brucejcooper/switch_gateway_firmware/src/lights.png

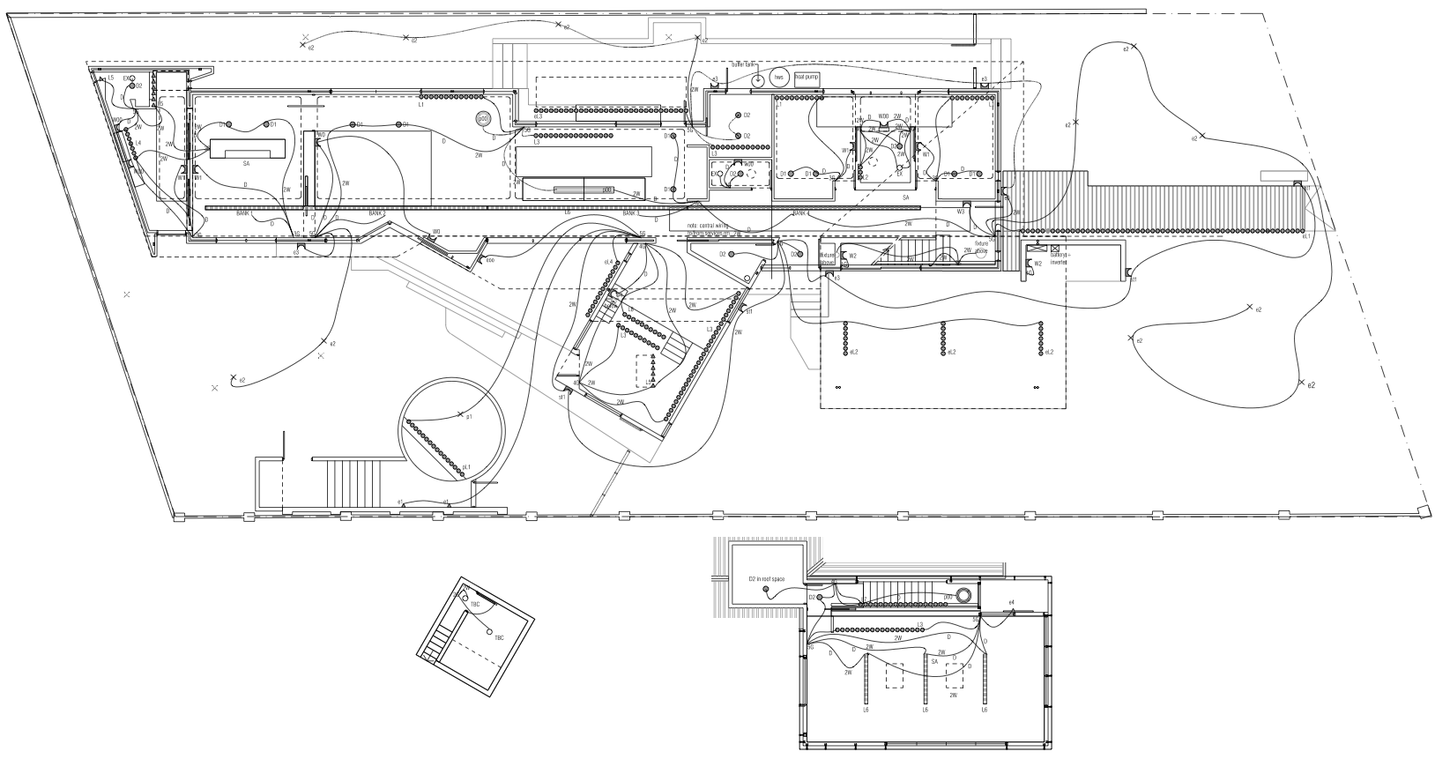
src/lights.png
