brucejcooper/switch_gateway_firmware/hardware/all_in_one_hub/production/all_in_one_hub_2024-05-29_09-31-53/bom.csv

Designator | Footprint | Quantity | Value | LCSC Part #
C1, C2, C3 | 0805 | 3 | 0.1u
CON1, CON2 | MIKROBUS_HOST_CONN | 2 | MIKROBUS_HOST_CONN
D1, D10, D100, D101, D102, D103, D104, D105, D106, D107, D108, D109, D11, D110, D111, D112, D113, D114, D115, D116, D117, D118, D119, D12, D120, D121, D122, D123, D124, D125, D126, D127, D128, D129, D13, D130, D131, D132, D133, D134, D135, D136, D137, D138, D139, D14, D140, D141, D142, D143, D144, D145, D146, D147, D148, D149, D15, D150, D151, D152, D153, D154, D155, D156, D157, D158, D159, D16, D160, D161, D162, D163, D164, D165, D166, D167, D168, D17, D18, D19, D2, D20, D21, D22, D23, D24, D25, D26, D27, D28, D29, D3, D30, D31, D32, D33, D34, D35, D36, D37, D38, D39, D4, D40, D41, D42, D43, D44, D45, D46, D47, D48, D49, D5, D50, D51, D52, D53, D54, D55, D56, D57, D58, D59, D6, D60, D61, D62, D63, D64, D65, D66, D67, D68, D69, D7, D70, D71, D72, D73, D74, D75, D76, D77, D78, D79, D8, D80, D81, D82, D83, D84, D85, D86, D87, D88, D89, D9, D90, D91, D92, D93, D94, D95, D96, D97, D98, D99 | D_SOD-123F | 168 | D
J1 | TerminalBlock_Phoenix_MKDS-1,5-6-5.08_1x06_P5.08mm_Horizontal | 1 | Screw_Terminal_01x06
J3, J4 | PinHeader_1x03_P2.54mm_Vertical | 2 | Conn_01x03
J5 | BarrelJack_Horizontal | 1 | Barrel_Jack_Switch
J6 | TerminalBlock_Phoenix_MKDS-1,5-2-5.08_1x02_P5.08mm_Horizontal | 1 | Screw_Terminal_01x02
R1, R2, R3, R4, R5, R6, R7 | 0603 | 7 | 4.7k
SW1 | SW_Tactile_SKHH_Angled | 1 | SW_Push
U1, U5, U6 | SOIC-16_3.9x9.9mm_P1.27mm | 3 | 74HC595
U2, U3, U7 | Molex 8pc*8pole RJ45 | 3 | ~
U4 | RaspberryPi_Pico_Common | 1 | RaspberryPi_Pico
