brucejcooper/switch_gateway_firmware/hardware/all_in_one_hub/Main Case.stl

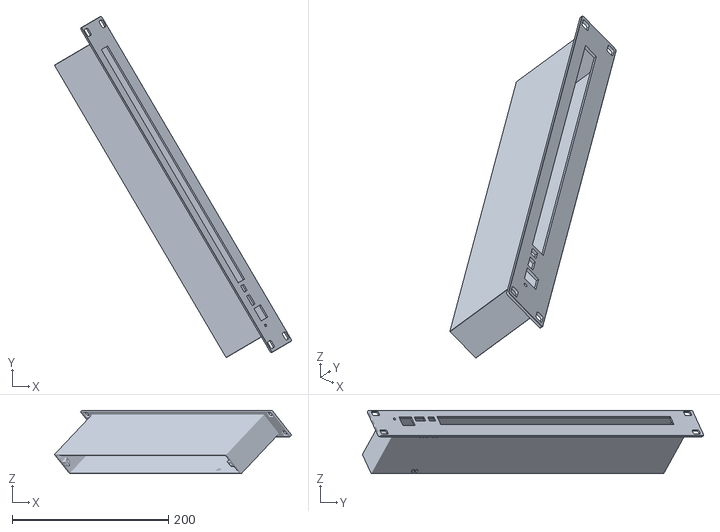
[picture p2: CAD file, 2026-10-23]
hardware/all_in_one_hub/Main Case.stl
303.6 x 437.1 x 81.3
