brucejcooper/switch_gateway_firmware/hardware/all_in_one_hub/All in One Hub v1 case.step

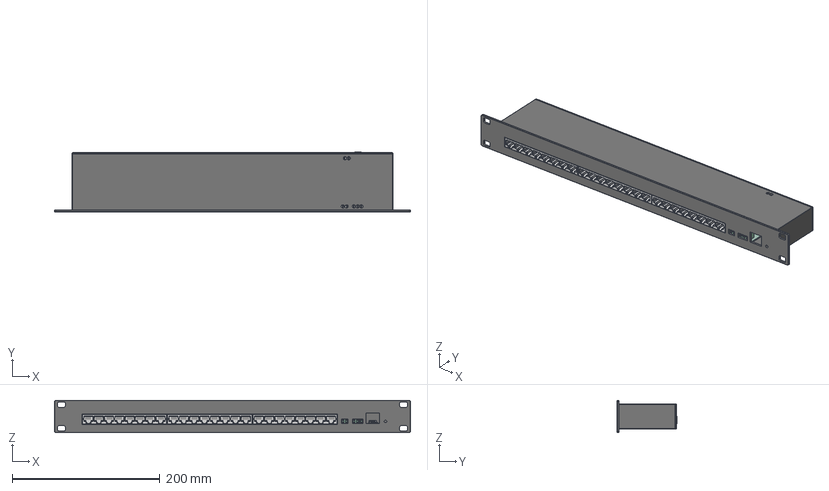
[picture p3: CAD file, 2026-10-23]
hardware/all_in_one_hub/All in One Hub v1 case.step
482.5 x 81.6 x 44.0 mm
D_SOD_123F x 168
R_0603_1608Metric x 7
TerminalBlock_Phoenix_MKDS_15_2_508_1x02_P508mm_Horizontal x 2
C_0805_2012Metric x 3
SSOP_16_53x62mm_P065mm x 3
BarrelJack_Horizontal
PinHeader_1x02_P254mm_Vertical
PinHeader_1x03_P254mm_Vertical
RaspberryPi_Pico_STEP
TerminalBlock_Phoenix_MKDS_15_3_508_1x03_P508mm_Horizontal
all_in_one_hub PCB
