brucejcooper/switch_gateway_firmware/hardware/all_in_one_hub/Mounting.FCStd

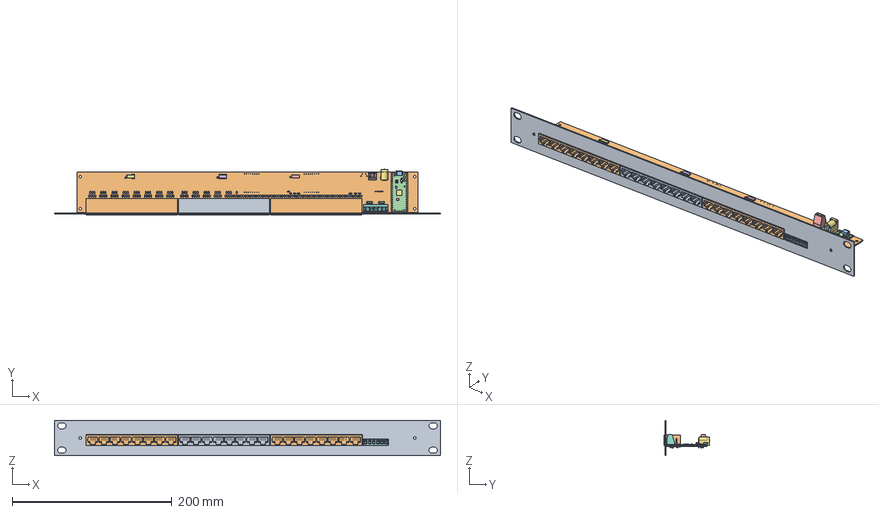
[picture p4: CAD file, 2026-10-23]
hardware/all_in_one_hub/Mounting.FCStd
483.5 x 57.1 x 44.0 mm
Face Plate
D_SOD-123F
D_SOD-123F001
D_SOD-123F002
D_SOD-123F003
D_SOD-123F004
D_SOD-123F005
D_SOD-123F006
D_SOD-123F007
D_SOD-123F008
D_SOD-123F009
D_SOD-123F010
D_SOD-123F011
D_SOD-123F012
D_SOD-123F013
TerminalBlock_Phoenix_MKDS-1,5-6-5.08_1x06_P5.08mm_Horizontal
R_0603_1608Metric
D_SOD-123F014
D_SOD-123F015
Pico_Board
C1_47u
C2_47u
D1_MBR120VLSFT1G
D2_QSME-C194_Base
D2_QSME-C194_Phosphor
D2_QSME-C194_Lens
J1_690T505-x62-01x
L1_2u2
Q1_DMG1012T
SW1_TP-1221U-K9K5325
U1_RP2040
U2_RT6150B-33GQW
U3_W25Q16JVUXIQ
X1_X12M000000S096
D_SOD-123F016
D_SOD-123F017
TerminalBlock_Phoenix_MKDS-1,5-2-5.08_1x02_P5.08mm_Horizontal
D_SOD-123F018
C_0805_2012Metric
D_SOD-123F019
D_SOD-123F020
D_SOD-123F021
D_SOD-123F022
D_SOD-123F023
SOIC-16_3.9x9.9mm_P1.27mm
D_SOD-123F024
C_0805_2012Metric001
D_SOD-123F025
D_SOD-123F026
D_SOD-123F027
D_SOD-123F028
D_SOD-123F029
D_SOD-123F030
D_SOD-123F031
D_SOD-123F032
D_SOD-123F033
D_SOD-123F034
D_SOD-123F035
D_SOD-123F036
D_SOD-123F037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
