brucejcooper/switch_gateway_firmware/hardware/all_in_one_hub/Rear Cover.stl

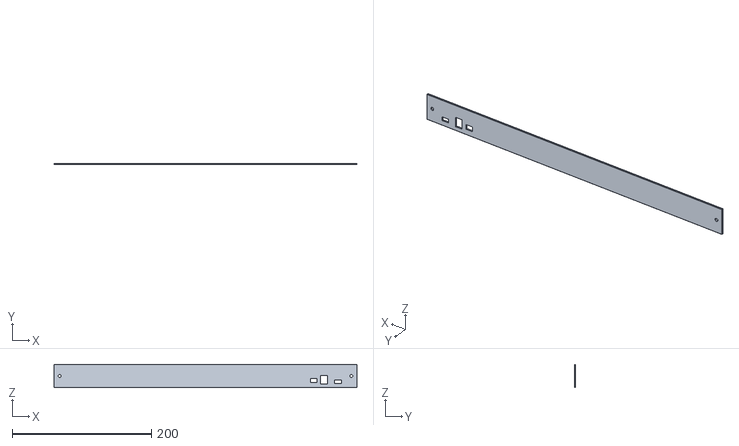
[picture p5: CAD file, 2026-10-23]
hardware/all_in_one_hub/Rear Cover.stl
434.6 x 2.00 x 33.6
