brucejcooper/switch_gateway_firmware/hardware/all_in_one_hub/all_in_one_hub.step

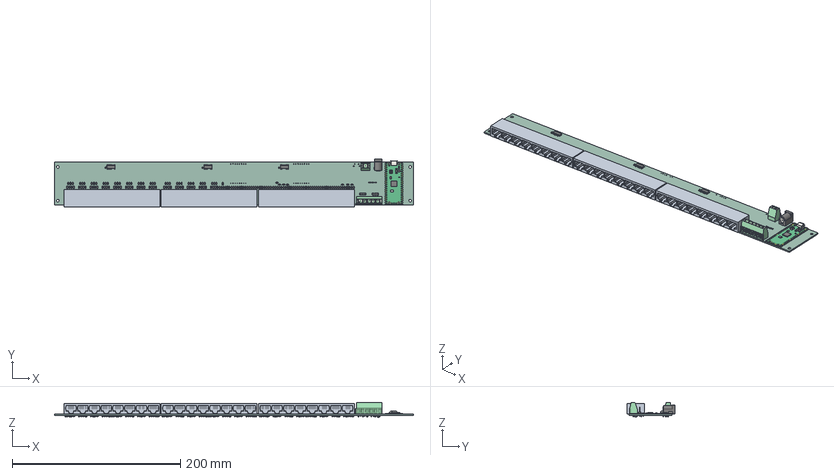
[picture p6: CAD file, 2026-10-23]
hardware/all_in_one_hub/all_in_one_hub.step
427.0 x 57.1 x 17.7 mm
D_SOD-123F x 168
TerminalBlock_Phoenix_MKDS-1,5-6-5.08_1x06_P5.08mm_Horizontal
R_0603_1608Metric x 7
Pico_Board
C1_47u
C2_47u
D1_MBR120VLSFT1G
D2_QSME-C194_Base
D2_QSME-C194_Phosphor
D2_QSME-C194_Lens
J1_690T505-x62-01x
L1_2u2
Q1_DMG1012T
SW1_TP-1221U-K9K5325
U1_RP2040
U2_RT6150B-33GQW
U3_W25Q16JVUXIQ
X1_X12M000000S096
TerminalBlock_Phoenix_MKDS-1,5-2-5.08_1x02_P5.08mm_Horizontal
C_0805_2012Metric x 3
SOIC-16_3.9x9.9mm_P1.27mm x 3
BarrelJack_Horizontal
PinHeader_1x03_P2.54mm_Vertical x 2
all_in_one_hub_PCB
