brucejcooper/switch_gateway_firmware/Switch wiring.xlsx

Sheet: Switch Positions
Light Fitting | Patch Panel Location | Button order |  |  |  |  | Map X | Map Y
Master Bath | 0 | 2 | 5 | 4 | 3 | 1 | 0.03923 | 0.13854
Master Bed near Bath | 1 | 2 | 5 | 4 |  |  | 0.09052 | 0.32571
Lounge near Master Bed | 2 | 2 | 5 | 3 | 4 | 0 | 0.17899 | 0.33459
Master Bed Near sliding Door | 17 | 0 | 1 | 2 | 3 | 4 | 0.16176 | 0.33464
Bed3 | 3 | 5 | 1 | 3 |  |  | 0.65847 | 0.24379
Kitchen bench | 4 | 0 | 1 | 2 | 5 | 4 | 0.33977 | 0.1688
Near Screen Door | 5 | 0 | 3 | 4 | 5 | 2 | 0.43088 | 0.33471
B office | 6 | 4 | 3 | 5 | 1 |  | 0.43491 | 0.34479
Hall near Kitchen | 7 | 2 | 5 | 4 | 3 |  | 0.47566 | 0.27911
Laundry/Kitchen | 8 | 1 | 5 | 4 | 3 |  | 0.46926 | 0.16669
Laundry near external door | 9 | 3 | 1 | 5 |  |  | 0.51399 | 0.25863
Powder | 10 | 5 | 3 | 1 |  |  | 0.51914 | 0.11531
Server Room | 11 | 3 | 1 | 5 | 4 | 2 | 0.5375 | 0.34013
Bed2 | 12 | 3 | 1 | 5 |  |  | 0.58 | 0.25028
Bath2 near Bed2 | 13 | 1 | 3 | 5 | 0 |  | 0.59988 | 0.16759
Bath2 near Bed3 | 14 | 0 | 5 | 3 | 1 |  | 0.63961 | 0.16901
Front Door | 15 | 2 | 5 | 1 | 3 | 4 | 0.70528 | 0.3319
Cellar | 16 | 1 | 3 |  |  |  | 0.55538 | 0.64826
Air Compressor Nook | 17 | 5 |  |  |  |  | 0.58709 | 0.37886
Steel Wall at bottom of stairs | 18 | 4 | 3 | 2 | 1 |  | 0.67684 | 0.37674
Top of stairs | 19 | 4 | 5 | 3 | 1 |  | 0.70459 | 0.69291
solar nook | 20 | 6 |  |  |  |  | 0.73011 | 0.39116
Brewery | 20 | 0 | 1 | 2 | 3 |  | 0.38265 | 0.55698
M studio near balcony | 21 | 1 | 0 | 3 | 4 | 5 | 0.80769 | 0.7589
M studio near door | 22 | 0 | 1 | 2 | 3 | 4 | 0.68279 | 0.78771
Master Bed near Pivot | 23 | 0 | 1 | 2 |  |  | 0.17046 | 0.18894

Sheet: Ethernet patches
Position | Switch Position | Thing | Wiring Fault
1 | 2 | main tv
2 | 5 | Bed2 left (printer)
3 | 17 | Bed 2 ap
4 |  | ???
5 | 20 | Mel studio ap
6 |  | ???
7 |  | Melissa bed side table
8 | 10 | Mel studio
9
10 | 19 | lounge room ap
11 | 12 | front doorbell
12 | 13 | side doorbell |  | 0
13 |  | brewery under table
14 |  | Bruce office 2 (near stairs)
15
16 | 21 | Bruce office 1 (dock)
17 | 18 | WIR ap
18 | 22 | Bed2 Right
19 | NON-ETH | Master Bed Button panel
20 | 16 | air con / solar / bike shed
21 | NON-ETH | Brewery Button panel
22 | 14 | carport | 4,5 open
23
24 | 23 | B studio AP

Sheet: Lights
Light | Location | Device | Address | Fix Name | Btn1 | Fix Name 2 | Btn2 | Fix name 3 | Btn3 | Note | Map X | Map Y
Master Bath Fan | Master Bath | 1 | 0 | Master Bath | 2 |  |  |  |  |  | 0.58902 | 0.36161
Cellar Exterior | Cellar | 1 | 1 | Cellar | 0 | Brewery | 3 |  |  |  | 0.48155 | 0.50552
garden near pool | Exterior | 1 | 2 | Master Bed Near sliding Door | 2 | Near Screen Door | 4 |  |  |  | 0.43215 | 0.46788
fireplace | Lounge | 1 | 3 | Lounge near Master Bed | 2 |  |  |  |  |  | 0.42725 | 0.48459
 | ??? | 1 | 4 |  |  |  |  |  |  |  | 0.4084 | 0.42025
back Deck thin end | Exterior | 1 | 5 | Master Bed Near sliding Door | 3 | Near Screen Door | 3 |  |  |  | 0.44076 | 0.53416
Laundry Fan | Laundry | 1 | 6 | Laundry/Kitchen | 3 | Laundry near external door | 1 |  |  |  | 0.62004 | 0.16019
Powder Fan | Powder Room | 1 | 7 | Powder | 2 |  |  |  |  |  | 0.63222 | 0.19474
Cellar interior | Cellar | 1 | 8 | Cellar | 1 |  |  |  |  |  | 0.63211 | 0.22782
Light above cabinet | Laundry | 1 | 9 |  |  |  |  |  |  |  | 0.60157 | 0.23467
Side Door Strike | Side Entry | 1 | 10 |  |  |  |  |  |  |  | 0.54775 | 0.23688
Master bath towel rail heater | Master Bath | 1 | 11 |  |  |  |  |  |  |  | 0.56708 | 0.23661
 | ??? | 1 | 12 |  |  |  |  |  |  |  | 0.59459 | 0.19509
air compressor nook | Exteriror | 1 | 13 | Air Compressor Nook | 0 |  |  |  |  |  | 0.55216 | 0.12053
Carport ceiling | Exterior | 1 | 14 | Server Room | 2 |  |  |  |  |  | 0.67429 | 0.23645
Front Garden | Exterior | 1 | 15 | Front Door | 4 |  |  |  |  |  | 0.69391 | 0.23685
side entry exterior, front of bike shed and letterbox | Exterior | 1 | 16 | Server Room | 3 |  |  |  |  |  | 0.68829 | 0.12043
Bath2 anton | Bath2 | 1 | 17 | Bath2 near Bed2 | 0 | Bath2 near Bed3 | 0 |  |  |  | 0.64762 | 0.19465
Powder anton | Powder Room | 1 | 18 | Powder | 1 |  |  |  |  |  | 0.56197 | 0.655
Almond and northwest | Exterior | 1 | 19 | Laundry/Kitchen | 2 |  |  |  |  |  | 0.58062 | 0.70708
Master Bath Anton | Master Bath | 1 | 20 | Master Bath | 0 |  |  |  |  |  | 0.68398 | 0.28319
pool wall, and the metal wall extender | Exterior | 1 | 21 | Near Screen Door | 2 | Lounge near Master Bed | 3 |  |  |  | 0.70506 | 0.34723
Northeast exterior | Exterior | 1 | 22 | Front Door | 3 | Laundry near external door | 2 |  |  |  | 0.69527 | 0.35837
Jewellery pendant | Hall | 1 | 25 | Top of stairs | 2 | Steel Wall at bottom of stairs | 3 |  |  |  | 0.75435 | 0.32254
M studio balcony | M Studio | 1 | 26 | M studio near balcony | 4 |  |  |  |  |  | 0.6984 | 0.09932
 | ??? | 1 | 27 |  |  |  |  |  |  |  | 0.86788 | 0.17273
AirCon / Solar Nook | Air con Hutch | 1 | 28 | solar nook | 0 |  |  |  |  |  | 0.71323 | 0.26359
Bath2 fan | Bath2 | 1 | 29 | Bath2 near Bed2 | 2 | Bath2 near Bed3 | 2 |  |  |  | 0.45641 | 0.17882
External Air Intake | Exterior | 1 | 30 |  |  |  |  |  |  |  | 0.45641 | 0.26061
 | ??? | 1 | 31 |  |  |  |  |  |  |  | 0.49059 | 0.28903
top of stairs | M Studio | 2 | 0 | Top of stairs | 0 | Steel Wall at bottom of stairs | 1 | M studio near door | 4 |  | 0.51469 | 0.28909
Back deck towel rail | Exterior | 2 | 1 | Near Screen Door | 0 |  |  |  |  |  | 0.62788 | 0.28895
M studio 3 bar | M Studio | 2 | 2 | M studio near door | 3 | M studio near balcony | 1 |  |  |  | 0.60936 | 0.28924
B studio exterior east | Exterior | 2 | 3 | Server Room | 2 |  |  |  |  |  | 0.37281 | 0.17779
Side Entry | Side Entry | 2 | 4 | Server Room | 0 |  |  |  |  |  | 0.30883 | 0.15254
M studio 1 spot | M Studio | 2 | 5 | M studio near door | 1 | M studio near balcony | 3 |  |  |  | 0.3486 | 0.26107
B studio ceiling LED strip | B Studio | 2 | 6 | B office | 0 | Brewery | 1 |  |  |  | 0.35362 | 0.26115
 |  | 2 | 7 |  |  |  |  |  |  | Collision ???
 | Back Deck | 2 | 7 |  |  |  |  |  |  | Collision |  |  | Multiple devices?
Server Room | Server Room | 2 | 8 | Server Room | 1 |  |  |  |  |  | 0.42529 | 0.26058
M studio 2 bar | M Studio | 2 | 9 | M studio near door | 2 | M studio near balcony | 2 |  |  |  | 0.41622 | 0.2605
M studio 2 spot | M Studio | 2 | 10 | M studio near door | 2 | M studio near balcony | 1 |  |  |  | 0.50692 | 0.17923
M studio 3 spot | M Studio | 2 | 11 | M studio near door | 3 | M studio near balcony | 0 |  |  |  | 0.50694 | 0.14723
B studio Drinks | B Studio | 2 | 12 | B office | 2 | Brewery | 0 |  |  |  | 0.5067 | 0.19731
B studio above Storage | B Studio | 2 | 13 | B office | 1 |  |  |  |  |  | 0.40846 | 0.13981
B studio sticky outy | B Studio | 2 | 14 | B office | 3 |  |  |  |  |  | 0.36752 | 0.00897
M studio bench | M Studio | 2 | 15 | M studio near door | 0 | M studio near balcony | 3 |  |  |  | 0.51524 | 0.15916
B studio Lightwell | B Studio | 2 | 16 | B office | 3 | Brewery | 2 |  |  |  | 0.2072 | 0.16113
Above steel wall | M Studio | 2 | 17 | Top of stairs | 1 | Steel Wall at bottom of stairs | 2 |  |  |  | 0.24321 | 0.16125
attic | M Studio | 2 | 18 | Top of stairs | 3 |  |  |  |  |  | 0.1807 | 0.18845
M studio 1 bar | M Studio | 2 | 37 | M studio near door | 1 | M studio near balcony | 2 |  |  |  | 0.2686 | 0.33315
Master Bath sconce | Master Bath | 3 | 0 | Master Bath | 1 | Master Bed near Bath | 1 | Master Bed near Pivot | 2 |  | 0.8433 | 0.73366
Laundry near door | Laundry | 3 | 1 | Laundry/Kitchen | 0 | Laundry near external door | 0 |  |  | Collision | 0.7374 | 0.76132
Front Door Light | Exterior | 3 | 1 | Front Door | 4 |  |  |  |  | Collision with Laundry | 0.72834 | 0.80681
Bath2 ceiling | Bath2 | 3 | 2 | Bath2 near Bed2 | 1 | Bath2 near Bed3 | 1 |  |  |  | 0.7291 | 0.86794
Spot on Curtain | Lounge | 3 | 3 |  |  |  |  |  |  | Collision with Bath2 soap holder
Bath2 soap holder | Bath2 | 3 | 3 | Bath2 near Bed2 | 3 | Bath2 near Bed3 | 3 |  |  | Collision | 0.77482 | 0.86514
Kitchen near laundry | Kitchen | 3 | 4 | Hall near Kitchen | 0 |  |  |  |  |  | 0.77488 | 0.80407
Bed3 Ceiling near door | Bed3 | 3 | 5 | Bed3 | 0 |  |  |  |  |  | 0.82134 | 0.86788
Master toilet ceiling | Master Bath | 3 | 6 | Master Bath | 4 |  |  |  |  |  | 0.82123 | 0.80497
Hall 3 (wide angle) | Hall | 3 | 7 | Hall near Kitchen | 2 | Front Door | 2 |  |  |  | 0.02503 | 0.1667
Bed2 Ceiling near door | Bed2 | 3 | 8 | Bed2 | 0 |  |  |  |  |  | 0.03514 | 0.19055
Master Bed WIR near bath | Master Bed | 3 | 10 | Master Bed near Pivot | 0 | Master Bed near Bath | 2 |  |  |  | 0.07614 | 0.23056
Bed2 Sconce | Bed2 | 3 | 11 | Bed2 | 1 |  |  |  |  |  | 0.06638 | 0.09675
Hall 4 | Hall | 3 | 12 | Hall near Kitchen | 2 | Front Door | 2 |  |  |  | 0.0118 | 0.0918
Bed3 Curtain | Bed3 | 3 | 13 | Bed3 | 2 |  |  |  |  |  | 0.05302 | 0.10556
Dining Room Upwards firing | Kitchen | 3 | 14 | Kitchen bench | 3 | Hall near Kitchen | 3 | Lounge near Master Bed | 4 |  | 0.03621 | 0.10184
kitchen spot nearest dining | Kitchen | 3 | 15 | Kitchen bench | 4 |  |  |  |  |  | 0.08582 | 0.22975
Oval Light over informal dining | Lounge | 3 | 16 | Kitchen bench | 1 | Master Bed near Pivot | 1 |  |  |  | 0.14049 | 0.16084
Master Bed WIR near lounge | Master Bed | 3 | 18 | Master Bed near Pivot | 0 | Master Bed near Bath | 2 |  |  |  | 0.11122 | 0.16103
Hall 2 | Hall | 3 | 20 | Hall near Kitchen | 1 | Server Room | 4 |  |  |  | 0.12304 | 0.2888
Powder ceiling | Powder Room | 3 | 21 | Powder | 0 |  |  |  |  |  | 0.1851 | 0.49329
Shower | Master Bath | 3 | 22 | Master Bath | 3 |  |  |  |  |  | 0.16732 | 0.3477
kitchen bench | Kitchen | 3 | 23 | Kitchen bench | 0 |  |  |  |  |  | 0.40574 | 0.40015
Bed3 Downlight near window | Bed3 | 3 | 25 | Bed3 | 0 |  |  |  |  |  | 0.30718 | 0.36861
Lounge sconce | Lounge | 3 | 26 | Lounge near Master Bed | 1 |  |  |  |  |  | 0.28232 | 0.74499
Bed2 Ceiling corner | Bed2 | 3 | 27 | Bed2 | 0 |  |  |  |  |  | 0.50866 | 0.23694
Laundry near exterior | Laundry | 3 | 28 | Laundry/Kitchen | 0 | Laundry near external door | 0 |  |  |  | 0.50696 | 0.2215
Bed3 Sconce | Bed3 | 3 | 29 | Bed3 | 1 |  |  |  |  |  | 0.49284 | 0.23653
Hallway Disc | Hall | 3 | 30 | Front Door | 0 |  |  |  |  |  | 0.55464 | 0.35978
Master Bath ceiling strip | Master Bath | 3 | 33 | Master Bath | 0 |  |  |  |  |  | 0.50152 | 0.36008
Lounge ceiling near bed | Lounge | 3 | 34 | Lounge near Master Bed | 0 |  |  |  |  |  | 0.51034 | 0.44259
kitchen spot nearest hall | Kitchen | 3 | 35 | Kitchen bench | 4 |  |  |  |  |  | 0.58986 | 0.48067
Master Bed Niche | Master Bed | 3 | 36 | Master Bed near Bath | 0 |  |  |  |  |  | 0.57837 | 0.38973
Hall 1 | Hall | 3 | 38 | Hall near Kitchen | 1 | Server Room | 4 |  |  |  | 0.41831 | 0.61896
lounge celining near bookshelf | Lounge | 3 | 41 | Lounge near Master Bed | 0 |  |  |  |  |  | 0.73337 | 0.37383
Kitchen near fridge | Kitchen | 3 | 43 | Hall near Kitchen | 0 |  |  |  |  |  | 0.69293 | 0.7119
Mystery | ??? | 3 | 45 |  |  |  |  |  |  |  | 0.75165 | 0.72365
BBQ | Exterior | 3 | 53 | Laundry/Kitchen | 1 |  |  |  |  |  | 0.65059 | 0.69834
Master Toilet window | Master Bath | 3 | 57 | Master Bath | 3
Master bed bar near bath | Master Bed | 3 | 58 | Master Bed Near sliding Door | 1
Dining Room Down firing | Kitchen | 3 | 60 | Kitchen bench | 2 |  |  |  |  |  | 0.06695 | 0.3452
Bed2 Curtain | Bed2 | 3 | 62 | Bed2 | 2
Front deck under-deck | Exterior |  |  | Front Door | 3
Laundry cabinet top | Laundry |  |  | Laundry/Kitchen | 0 | Laundry near external door | 0
Smiley Face | Hall |  |  | Front Door | 1 | Steel Wall at bottom of stairs | w |  |  | Has manual switch
Back Deck light | Exterior |  |  | Near Screen Door | 1
B studio exterior south | Exterior |  |  | Server Room | 3 |  |  |  |  | Missing Driver | 0.04951 | 0.14158

Sheet: Map Layout
Plate | Button | Light | Waypoints
