brucejcooper/switch_gateway_firmware/hardware/all_in_one_hub/all_in_one_hub.kicad_pcb

## KiCad design hardware/all_in_one_hub/all_in_one_hub.kicad_pcb (2026-10-23)

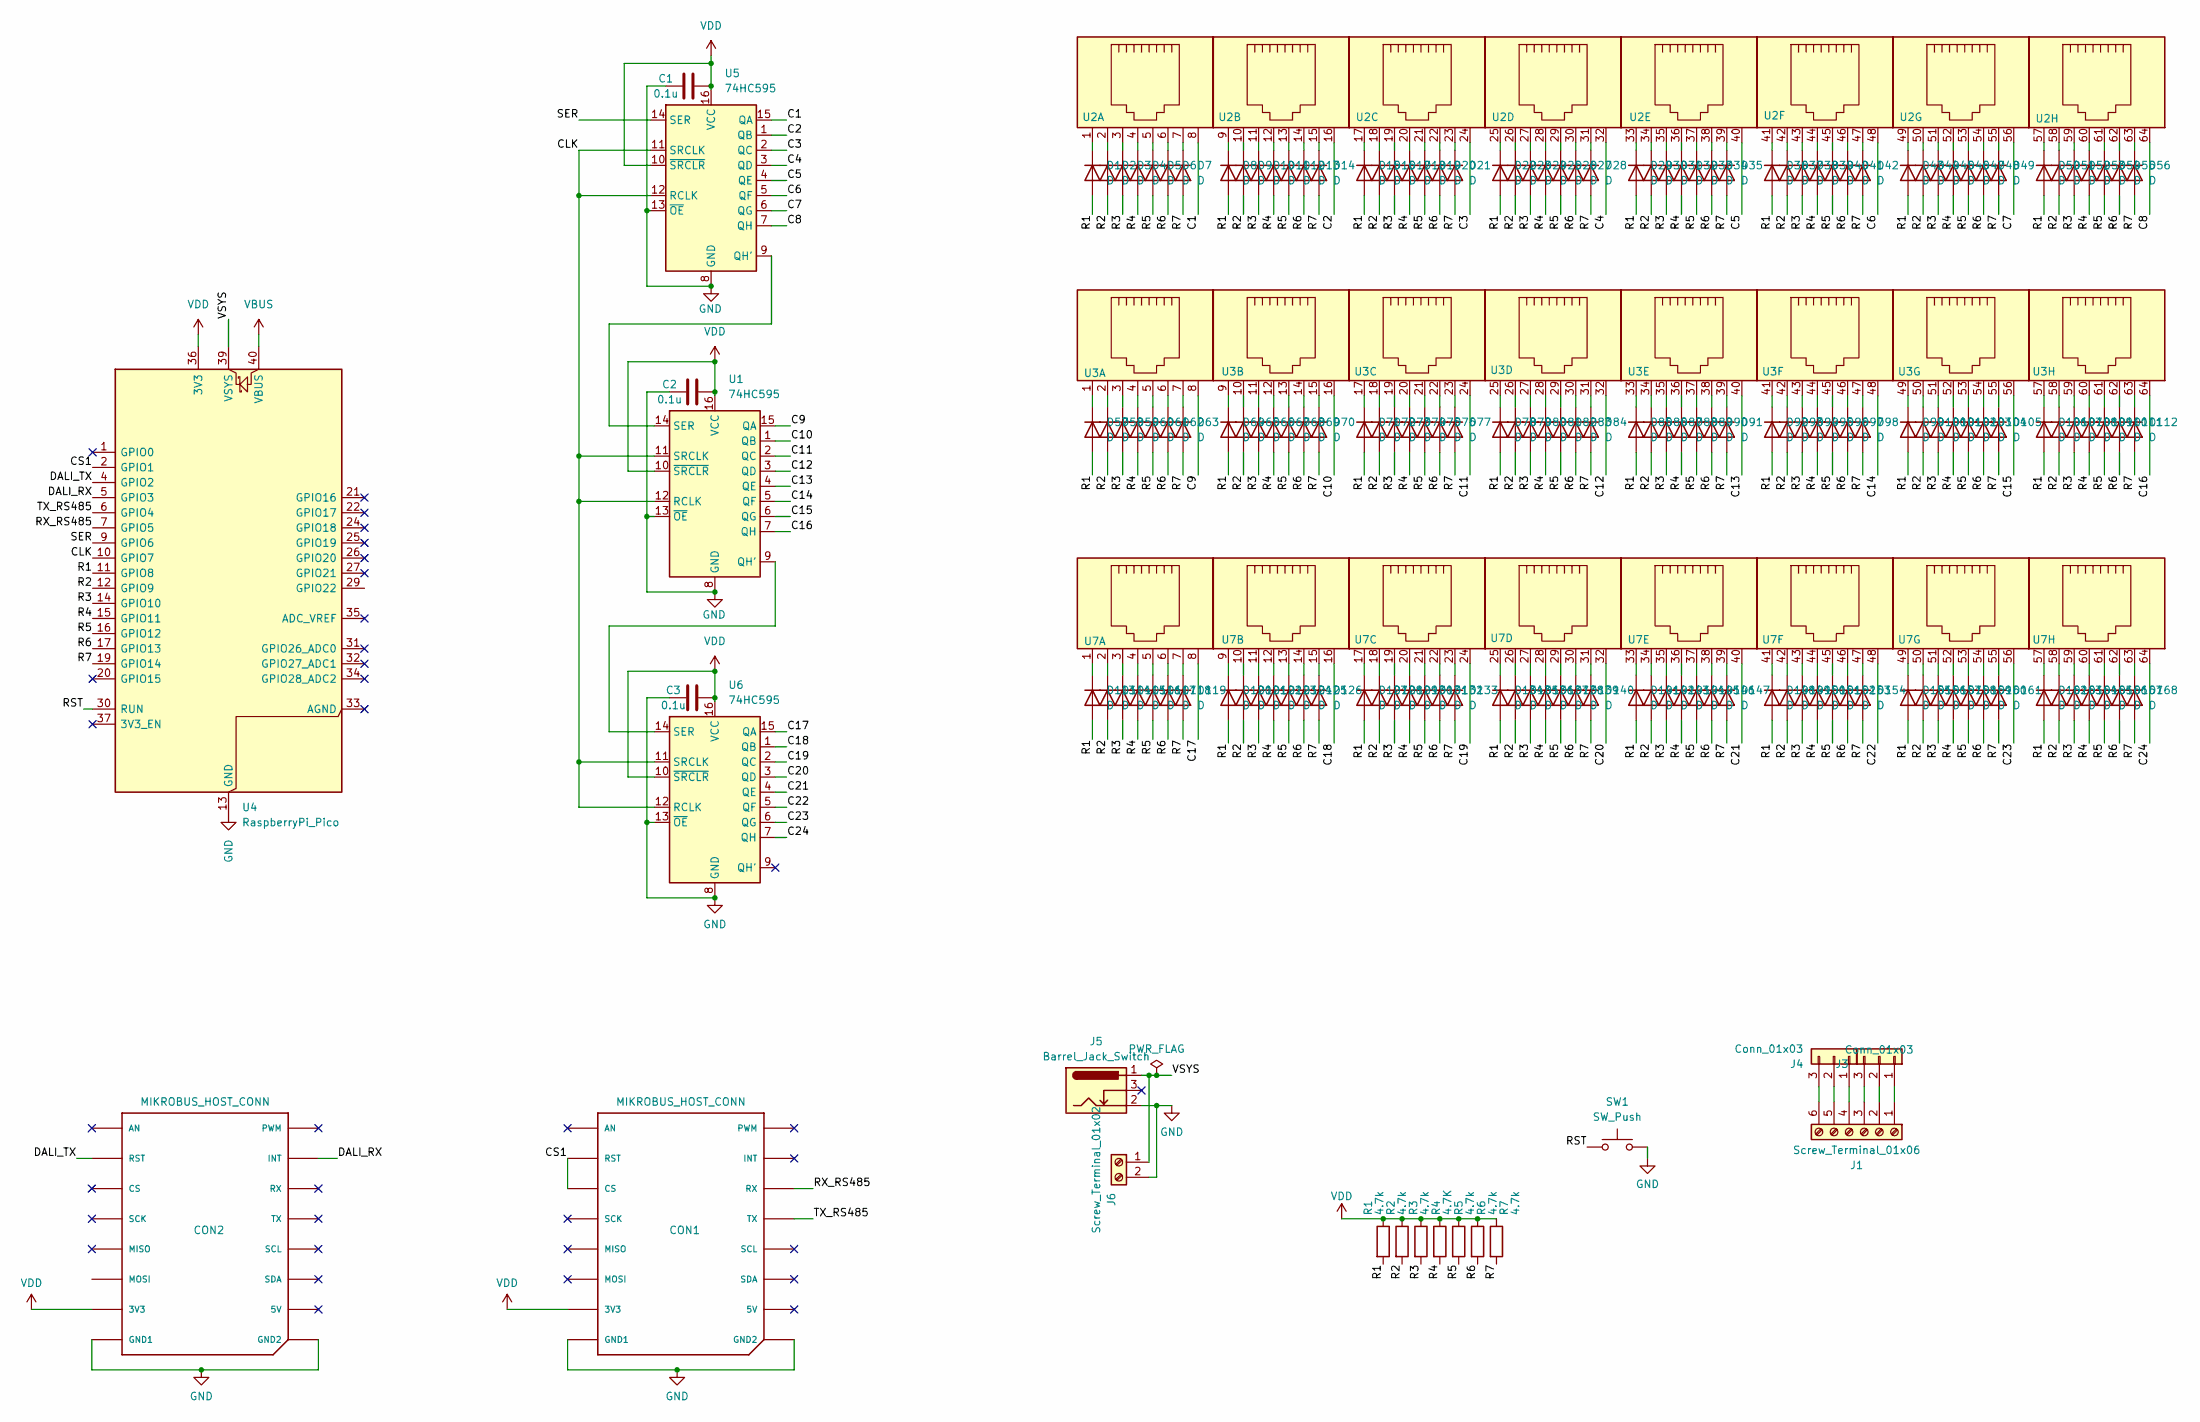
[picture p7: schematic all_in_one_hub.kicad_sch]

Parts:
C1, C2, C3: 0.1u; C_0805_2012Metric
CON1, CON2: MIKROBUS_HOST_CONN
D1, D2, D3, D4, D5, D6, D7, D8, D9, D10, D11, D12, D13, D14, D15, D16, D17, D18, D19, D20, D21, D22, D23, D24, D25, D26, D27, D28, D29, D30, D31, D32, D33, D34, D35, D36, D37, D38, D39, D40, D41, D42, D43, D44, D45, D46, D47, D48, D49, D50, D51, D52, D53, D54, D55, D56, D57, D58, D59, D60, D61, D62, D63, D64, D65, D66, D67, D68, D69, D70, D71, D72, D73, D74, D75, D76, D77, D78, D79, D80, D81, D82, D83, D84, D85, D86, D87, D88, D89, D90, D91, D92, D93, D94, D95, D96, D97, D98, D99, D100, D101, D102, D103, D104, D105, D106, D107, D108, D109, D110, D111, D112, D113, D114, D115, D116, D117, D118, D119, D120, D121, D122, D123, D124, D125, D126, D127, D128, D129, D130, D131, D132, D133, D134, D135, D136, D137, D138, D139, D140, D141, D142, D143, D144, D145, D146, D147, D148, D149, D150, D151, D152, D153, D154, D155, D156, D157, D158, D159, D160, D161, D162, D163, D164, D165, D166, D167, D168: D; D_SOD-123F
J1: Screw_Terminal_01x06; TerminalBlock_Phoenix_MKDS-1,5-6-5.08_1x06_P5.08mm_Horizont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
J3, J4: Conn_01x03; PinHeader_1x03_P2.54mm_Vertical
J5: Barrel_Jack_Switch; BarrelJack_Horizontal
J6: Screw_Terminal_01x02; TerminalBlock_Phoenix_MKDS-1,5-2-5.08_1x02_P5.08mm_Horizont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
R1, R2, R3, R5, R6, R7: 4.7k; R_0603_1608Metric
R4: 4.7K; R_0603_1608Metric
SW1: SW_Push; SW_Tactile_SKHH_Angled
U1, U5, U6: 74HC595; SOIC-16_3.9x9.9mm_P1.27mm
U2, U3, U7: Molex 8pc*8pole RJ45
U4: RaspberryPi_Pico; RaspberryPi_Pico_Common

Connections:
/C1: U2.8, U5.15 (QA)
/C2: U2.16, U5.1 (QB)
/C3: U2.24, U5.2 (QC)
/C4: U2.32, U5.3 (QD)
/C5: U2.40, U5.4 (QE)
/C6: U2.48, U5.5 (QF)
/C7: U2.56, U5.6 (QG)
/C8: U2.64, U5.7 (QH)
/C9: U1.15 (QA), U3.8
/C10: U1.1 (QB), U3.16
/C11: U1.2 (QC), U3.24
/C12: U1.3 (QD), U3.32
/C13: U1.4 (QE), U3.40
/C14: U1.5 (QF), U3.48
/C15: U1.6 (QG), U3.56
/C16: U1.7 (QH), U3.64
/C17: U6.15 (QA), U7.8
/C18: U6.1 (QB), U7.16
/C19: U6.2 (QC), U7.24
/C20: U6.3 (QD), U7.32
/C21: U6.4 (QE), U7.40
/C22: U6.5 (QF), U7.48
/C23: U6.6 (QG), U7.56
/C24: U6.7 (QH), U7.64
/CLK: U1.11 (SRCLK), U1.12 (RCLK), U4.10 (GPIO7), U5.11 (SRCLK), U5.12 (RCLK), U6.11 (SRCLK), U6.12 (RCLK)
/CS1: CON1.P2 (RST), CON1.P3 (CS), U4.2 (GPIO1)
/DALI_RX: CON2.P15 (INT), U4.5 (GPIO3)
/DALI_TX: CON2.P2 (RST), U4.4 (GPIO2)
/R1: D1.2 (A), D8.2 (A), D15.2 (A), D22.2 (A), D29.2 (A), D36.2 (A), D43.2 (A), D50.2 (A), D57.2 (A), D64.2 (A), D71.2 (A), D78.2 (A), D85.2 (A), D92.2 (A), D99.2 (A), D106.2 (A), D113.2 (A), D120.2 (A), D127.2 (A), D134.2 (A), D141.2 (A), D148.2 (A), D155.2 (A), D162.2 (A), R1.2, U4.11 (GPIO8)
/R2: D2.2 (A), D9.2 (A), D16.2 (A), D23.2 (A), D30.2 (A), D37.2 (A), D44.2 (A), D51.2 (A), D58.2 (A), D65.2 (A), D72.2 (A), D79.2 (A), D86.2 (A), D93.2 (A), D100.2 (A), D107.2 (A), D114.2 (A), D121.2 (A), D128.2 (A), D135.2 (A), D142.2 (A), D149.2 (A), D156.2 (A), D163.2 (A), R2.2, U4.12 (GPIO9)
/R3: D3.2 (A), D10.2 (A), D17.2 (A), D24.2 (A), D31.2 (A), D38.2 (A), D45.2 (A), D52.2 (A), D59.2 (A), D66.2 (A), D73.2 (A), D80.2 (A), D87.2 (A), D94.2 (A), D101.2 (A), D108.2 (A), D115.2 (A), D122.2 (A), D129.2 (A), D136.2 (A), D143.2 (A), D150.2 (A), D157.2 (A), D164.2 (A), R3.2, U4.14 (GPIO10)
/R4: D4.2 (A), D11.2 (A), D18.2 (A), D25.2 (A), D32.2 (A), D39.2 (A), D46.2 (A), D53.2 (A), D60.2 (A), D67.2 (A), D74.2 (A), D81.2 (A), D88.2 (A), D95.2 (A), D102.2 (A), D109.2 (A), D116.2 (A), D123.2 (A), D130.2 (A), D137.2 (A), D144.2 (A), D151.2 (A), D158.2 (A), D165.2 (A), R4.2, U4.15 (GPIO11)
/R5: D5.2 (A), D12.2 (A), D19.2 (A), D26.2 (A), D33.2 (A), D40.2 (A), D47.2 (A), D54.2 (A), D61.2 (A), D68.2 (A), D75.2 (A), D82.2 (A), D89.2 (A), D96.2 (A), D103.2 (A), D110.2 (A), D117.2 (A), D124.2 (A), D131.2 (A), D138.2 (A), D145.2 (A), D152.2 (A), D159.2 (A), D166.2 (A), R5.2, U4.16 (GPIO12)
/R6: D6.2 (A), D13.2 (A), D20.2 (A), D27.2 (A), D34.2 (A), D41.2 (A), D48.2 (A), D55.2 (A), D62.2 (A), D69.2 (A), D76.2 (A), D83.2 (A), D90.2 (A), D97.2 (A), D104.2 (A), D111.2 (A), D118.2 (A), D125.2 (A), D132.2 (A), D139.2 (A), D146.2 (A), D153.2 (A), D160.2 (A), D167.2 (A), R6.2, U4.17 (GPIO13)
/R7: D7.2 (A), D14.2 (A), D21.2 (A), D28.2 (A), D35.2 (A), D42.2 (A), D49.2 (A), D56.2 (A), D63.2 (A), D70.2 (A), D77.2 (A), D84.2 (A), D91.2 (A), D98.2 (A), D105.2 (A), D112.2 (A), D119.2 (A), D126.2 (A), D133.2 (A), D140.2 (A), D147.2 (A), D154.2 (A), D161.2 (A), D168.2 (A), R7.2, U4.19 (GPIO14)
/RST: SW1.1, U4.30 (RUN)
/RX_RS485: CON1.P14 (RX), U4.7 (GPIO5)
/SER: U4.9 (GPIO6), U5.14 (SER)
/TX_RS485: CON1.P13 (TX), U4.6 (GPIO4)
/VSYS: J5.1, J6.1, U4.39 (VSYS)
GND: C1.1, C2.1, C3.1, CON1.P8 (GND1), CON1.P9 (GND2), CON2.P8 (GND1), CON2.P9 (GND2), J5.2, J6.2, SW1.2, U1.8 (GND), U1.13 (~OE), U4.3 (GND), U4.8 (GND), U4.13 (GND), U4.18 (GND), U4.23 (GND), U4.28 (GND), U4.38 (GND), U5.8 (GND), U5.13 (~OE), U6.8 (GND), U6.13 (~OE)
unnamed: D1.1 (K), U2.1
unnamed: D2.1 (K), U2.2
unnamed: D3.1 (K), U2.3
unnamed: D4.1 (K), U2.4
unnamed: D5.1 (K), U2.5
unnamed: D6.1 (K), U2.6
unnamed: D7.1 (K), U2.7
unnamed: D8.1 (K), U2.9
unnamed: D9.1 (K), U2.10
unnamed: D10.1 (K), U2.11
unnamed: D11.1 (K), U2.12
unnamed: D12.1 (K), U2.13
unnamed: D13.1 (K), U2.14
unnamed: D14.1 (K), U2.15
unnamed: D15.1 (K), U2.17
unnamed: D16.1 (K), U2.18
unnamed: D17.1 (K), U2.19
unnamed: D18.1 (K), U2.20
unnamed: D19.1 (K), U2.21
unnamed: D20.1 (K), U2.22
unnamed: D21.1 (K), U2.23
unnamed: D22.1 (K), U2.25
unnamed: D23.1 (K), U2.26
unnamed: D24.1 (K), U2.27
unnamed: D25.1 (K), U2.28
unnamed: D26.1 (K), U2.29
unnamed: D27.1 (K), U2.30
unnamed: D28.1 (K), U2.31
unnamed: D29.1 (K), U2.33
unnamed: D30.1 (K), U2.34
unnamed: D31.1 (K), U2.35
unnamed: D32.1 (K), U2.36
unnamed: D33.1 (K), U2.37
unnamed: D34.1 (K), U2.38
unnamed: D35.1 (K), U2.39
unnamed: D36.1 (K), U2.41
unnamed: D37.1 (K), U2.42
unnamed: D38.1 (K), U2.43
unnamed: D39.1 (K), U2.44
unnamed: D40.1 (K), U2.45
unnamed: D41.1 (K), U2.46
unnamed: D42.1 (K), U2.47
unnamed: D43.1 (K), U2.49
unnamed: D44.1 (K), U2.50
unnamed: D45.1 (K), U2.51
unnamed: D46.1 (K), U2.52
unnamed: D47.1 (K), U2.53
unnamed: D48.1 (K), U2.54
unnamed: D49.1 (K), U2.55
unnamed: D50.1 (K), U2.57
unnamed: D51.1 (K), U2.58
unnamed: D52.1 (K), U2.59
unnamed: D53.1 (K), U2.60
unnamed: D54.1 (K), U2.61
unnamed: D55.1 (K), U2.62
unnamed: D56.1 (K), U2.63
unnamed: D57.1 (K), U3.1
unnamed: D58.1 (K), U3.2
unnamed: D59.1 (K), U3.3
unnamed: D60.1 (K), U3.4
unnamed: D61.1 (K), U3.5
unnamed: D62.1 (K), U3.6
unnamed: D63.1 (K), U3.7
unnamed: D64.1 (K), U3.9
unnamed: D65.1 (K), U3.10
unnamed: D66.1 (K), U3.11
unnamed: D67.1 (K), U3.12
unnamed: D68.1 (K), U3.13
unnamed: D69.1 (K), U3.14
unnamed: D70.1 (K), U3.15
unnamed: D71.1 (K), U3.17
unnamed: D72.1 (K), U3.18
unnamed: D73.1 (K), U3.19
unnamed: D74.1 (K), U3.20
unnamed: D75.1 (K), U3.21
unnamed: D76.1 (K), U3.22
unnamed: D77.1 (K), U3.23
unnamed: D78.1 (K), U3.25
unnamed: D79.1 (K), U3.26
unnamed: D80.1 (K), U3.27
unnamed: D81.1 (K), U3.28
unnamed: D82.1 (K), U3.29
unnamed: D83.1 (K), U3.30
unnamed: D84.1 (K), U3.31
unnamed: D85.1 (K), U3.33
unnamed: D86.1 (K), U3.34
unnamed: D87.1 (K), U3.35
unnamed: D88.1 (K), U3.36
unnamed: D89.1 (K), U3.37
unnamed: D90.1 (K), U3.38
unnamed: D91.1 (K), U3.39
unnamed: D92.1 (K), U3.41
unnamed: D93.1 (K), U3.42
unnamed: D94.1 (K), U3.43
unnamed: D95.1 (K), U3.44
unnamed: D96.1 (K), U3.45
unnamed: D97.1 (K), U3.46
unnamed: D98.1 (K), U3.47
unnamed: D99.1 (K), U3.49
unnamed: D100.1 (K), U3.50
unnamed: D101.1 (K), U3.51
unnamed: D102.1 (K), U3.52
unnamed: D103.1 (K), U3.53
unnamed: D104.1 (K), U3.54
unnamed: D105.1 (K), U3.55
unnamed: D106.1 (K), U3.57
unnamed: D107.1 (K), U3.58
unnamed: D108.1 (K), U3.59
unnamed: D109.1 (K), U3.60
unnamed: D110.1 (K), U3.61
unnamed: D111.1 (K), U3.62
unnamed: D112.1 (K), U3.63
unnamed: D113.1 (K), U7.1
unnamed: D114.1 (K), U7.2
unnamed: D115.1 (K), U7.3
unnamed: D116.1 (K), U7.4
unnamed: D117.1 (K), U7.5
unnamed: D118.1 (K), U7.6
unnamed: D119.1 (K), U7.7
unnamed: D120.1 (K), U7.9
unnamed: D121.1 (K), U7.10
unnamed: D122.1 (K), U7.11
unnamed: D123.1 (K), U7.12
unnamed: D124.1 (K), U7.13
unnamed: D125.1 (K), U7.14
unnamed: D126.1 (K), U7.15
unnamed: D127.1 (K), U7.17
unnamed: D128.1 (K), U7.18
unnamed: D129.1 (K), U7.19
unnamed: D130.1 (K), U7.20
unnamed: D131.1 (K), U7.21
unnamed: D132.1 (K), U7.22
unnamed: D133.1 (K), U7.23
unnamed: D134.1 (K), U7.25
unnamed: D135.1 (K), U7.26
unnamed: D136.1 (K), U7.27
unnamed: D137.1 (K), U7.28
unnamed: D138.1 (K), U7.29
unnamed: D139.1 (K), U7.30
unnamed: D140.1 (K), U7.31
unnamed: D141.1 (K), U7.33
unnamed: D142.1 (K), U7.34
unnamed: D143.1 (K), U7.35
unnamed: D144.1 (K), U7.36
unnamed: D145.1 (K), U7.37
unnamed: D146.1 (K), U7.38
unnamed: D147.1 (K), U7.39
unnamed: D148.1 (K), U7.41
unnamed: D149.1 (K), U7.42
unnamed: D150.1 (K), U7.43
unnamed: D151.1 (K), U7.44
unnamed: D152.1 (K), U7.45
unnamed: D153.1 (K), U7.46
unnamed: D154.1 (K), U7.47
unnamed: D155.1 (K), U7.49
unnamed: D156.1 (K), U7.50
unnamed: D157.1 (K), U7.51
unnamed: D158.1 (K), U7.52
unnamed: D159.1 (K), U7.53
unnamed: D160.1 (K), U7.54
unnamed: D161.1 (K), U7.55
unnamed: D162.1 (K), U7.57
unnamed: D163.1 (K), U7.58
unnamed: D164.1 (K), U7.59
unnamed: D165.1 (K), U7.60
unnamed: D166.1 (K), U7.61
unnamed: D167.1 (K), U7.62
unnamed: D168.1 (K), U7.63
unnamed: J1.1, J3.1
unnamed: J1.2, J3.2
unnamed: J1.3, J3.3
unnamed: J1.4, J4.1
unnamed: J1.5, J4.2
unnamed: J1.6, J4.3
unnamed: U1.9 (QH'), U6.14 (SER)
unnamed: U1.14 (SER), U5.9 (QH')
VBUS: U4.40 (VBUS)
VDD: C1.2, C2.2, C3.2, CON1.P7 (3V3), CON2.P7 (3V3), R1.1, R2.1, R3.1, R4.1, R5.1, R6.1, R7.1, U1.10 (~SRCLR), U1.16 (VCC), U4.36 (3V3), U5.10 (~SRCLR), U5.16 (VCC), U6.10 (~SRCLR), U6.16 (VCC)

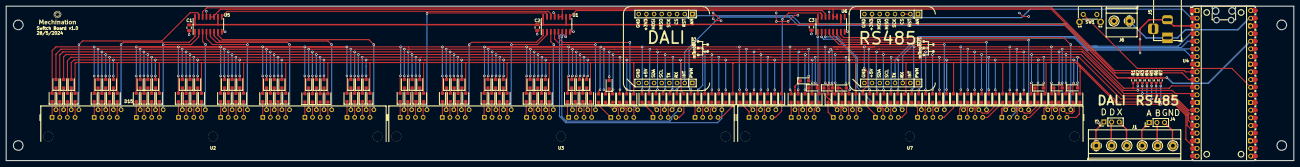
[picture p8: board all_in_one_hub.kicad_pcb from above]

Board: 2 copper layers, 427.0 x 51.2 mm, 193 parts (0 on the bottom side), 218 nets.
