brucejcooper/switch_gateway_firmware/src/dali_state.c

/*
 * dali_state.c — the controller's DALI world model. See dali_state.h.
 *
 * One sweep state machine per DALI slave. The work to do is held as BITMAPS of
 * what needs asking, not as a queue of commands: a ballast marked twice before
 * its query runs is asked once, which is the whole point of keeping wants as
 * state.
 *
 * Each slave runs ONE ballast's pass at a time, but a pass submits its queries
 * in WINDOWS of up to two. STATUS and LEVEL do not depend on each other's
 * answers, nor do the two group reads, so holding one query in flight and only
 * asking the next after the previous landed left the queue empty at every
 * collect moment — and an empty queue is exactly when the transport must spend
 * a bare poll instead of an enqueue that carries the ack (task 10). Submitting
 * the pair means the collect of the first rides the enqueue of the second, and
 * the gateway's DALI engine has the next frame ready the instant it finishes
 * one. The decision about what to ask NEXT still happens at the last possible
 * moment — when the window's results land — so nothing is committed early.
 *
 * A believed-ABSENT address is the exception and stays a single STATUS probe:
 * pairing would double the DALI cost of the common empty-address case for a
 * LEVEL answer that is discarded the moment STATUS reports nobody home.
 *
 * Selection order per slave:
 *   1. verification marks (a command just touched these) at DQ_PRIO_LEVEL_READ
 *   2. scan marks (boot / post-provision discovery)       at DQ_PRIO_BACKGROUND
 *   3. the rotating idle sweep                            at DQ_PRIO_BACKGROUND
 */

#include "dali_state.h"
#include "dali_queue.h"
#include "mbq_client.h"
#include "state_cache.h"
#include "lighting_actions.h"
#include "dali_provision.h"
#include "config.h"
#include "cdc_out.h"
#include "log.h"
#include "pico/time.h"
#include <string.h>

/* DALI query opcodes (IEC 62386-102), short-address command form. */
#define Q_STATUS        0x90u   /* status byte: fade running, lamp fail, limit error, ... */
#define Q_ACTUAL_LEVEL  0xA0u   /* current arc level */
#define Q_GROUPS_0_7    0xC0u
#define Q_GROUPS_8_15   0xC1u

/* Background sweep pace: ONE ballast interrogated per this interval, per slave.
 *
 * This is deliberately slow. The sweep exists only to catch what nothing tells
 * us about — a ballast that lost power and came back, or gear changed by
 * something outside this controller. Everything the system itself does is
 * verified immediately by the post-command path below, so the sweep is a
 * backstop, not the mechanism.
 *
 * For scale: the gateway's own rescan cursor (which this replaces) ran at ONE
 * ballast per 64 s. An earlier version of this file used 250 ms, which is 256x
 * faster than the thing it replaced and kept the RS-485 bus ~59% busy doing
 * nothing useful. */

/* While a ballast reports FADE RUNNING, re-read it at this pace until it
 * settles. A DAPC lands immediately but the level ramps, so a single read taken
 * mid-fade caches an intermediate value and — without this — would stand until
 * the next sweep, minutes later. Bounded by FADE_TRACK_MAX_MS because a stuck
 * fade bit must not pin the bus forever; DALI's longest fade time is ~90 s. */
#define FADE_POLL_MS        250u
#define FADE_TRACK_MAX_MS   95000u

/* Every Nth background step probes an ABSENT address instead of re-reading a
 * present one. Without this the sweep only ever walks ballasts it already
 * believes in, so a ballast that was powered off at boot — or added afterwards —
 * would never be rediscovered short of a manual `scan` or a reboot. A probe of
 * an absent address costs exactly one query (STATUS gets a clean no-answer and
 * the pass is abandoned), and at one probe per 6 steps a full pass over 64
 * addresses takes ~64 min at the default interval: cheap, and far faster than
 * "never". */
#define ABSENT_PROBE_EVERY  6u

/* How often to re-attempt a gateway the client has declared down
 * (LINK_DOWN_FAILS consecutive no-replies, mbq_client.h — the threshold used to
 * be a second `#define 3u` here, with nothing keeping the two in agreement).
 * The client fails these probes fast once the link has been down longer than a
 * restart could explain, so one every 5 s costs a single transaction. */
#define LINK_RETRY_MS     5000u

/* QUERY STATUS bit 4 = fade running (IEC 62386-102). */
#define STATUS_FADE_RUNNING 0x10u

/* Per-ballast query sequence. */
typedef enum {
    STEP_STATUS = 0,
    STEP_LEVEL,
    STEP_GROUPS_LO,   /* scan only */
    STEP_GROUPS_HI,   /* scan only */
    STEP_DONE,
} step_t;

/* One step's submission and its answer. Each carries its OWN token: two
 * queries are live at once and either may be superseded or abandoned alone, so
 * a single expected-token guard could no longer say which answer it admitted. */
typedef struct {
    uint16_t gen;         /* stale-callback guard; 0 = no live query for this step */
    bool     have;        /* a result landed */
    dq_result_t res;
    uint8_t  answer;
} ds_step_state_t;

typedef struct {
    bool     in_use;
    uint8_t  slave_id;
    uint8_t  slave_idx;

    uint64_t verify;      /* ballasts needing a post-command read (high priority) */
    uint64_t scan;        /* ballasts needing a full discovery pass */
    uint64_t present;     /* our current belief */
    uint8_t  strikes[64]; /* consecutive clean no-answers, per address */
    /* When this bus last gave a CLEAN directed-query result (an answer or a
     * silence). Proof the bus itself is alive — see presence_from(). */
    bool     clean_seen;
    uint32_t clean_ms;

    /* the window currently in flight: steps [step, step + win_n) */
    bool     busy;
    uint8_t  addr;
    step_t   step;
    uint8_t  win_n;       /* queries submitted together, 1 or 2 */
    bool     is_scan;     /* this pass includes the group reads */
    bool     burst;       /* this slave's background burst depth is raised */
    uint16_t gen;         /* token source */
    ds_step_state_t st[STEP_DONE];
    absolute_time_t deadline;

    /* partial results for the ballast being read */
    uint8_t  got_status;
    bool     got_status_ok;
    uint8_t  got_level;      /* captured at STEP_LEVEL; the scan path commits later */
    bool     got_level_ok;
    bool     got_level_mask; /* LEVEL answered MASK (0xFF): gear still starting */
    uint16_t got_groups;
    uint8_t  got_groups_ok;   /* bit0 GROUPS 0-7 answered, bit1 GROUPS 8-15 */

    uint8_t  cursor;        /* rotating idle sweep position (present ballasts) */
    uint8_t  absent_cursor; /* rotating probe position across ALL addresses */
    uint8_t  step_count;    /* sweep steps taken, for the absent-probe cadence */
    absolute_time_t next_step_at;
    absolute_time_t link_retry_at;  /* gateway unreachable: don't re-attempt until this */

    /* Fade tracking: re-verify a ballast while it reports FADE RUNNING. */
    uint64_t fade_watch;              /* ballasts being tracked through a fade */
    absolute_time_t fade_next_at;
    absolute_time_t fade_give_up_at;
} ds_slave_t;

static ds_slave_t s_ds[MAX_DALI_SLAVES];

#define QUERY_DEADLINE_MS 400u

/* ── helpers ─────────────────────────────────────────────────────────────── */

/* Background sweep pace, from config. 0 DISABLES the sweep (same convention as
 * gw_diag_interval_ms). Disabling it is safe: every command the system issues is
 * still verified immediately by the post-command path, so switching the sweep
 * off only means "never re-check a ballast that nothing told us about". */
static uint32_t sweep_interval_ms(void) {
    return g_config.dali_sweep_interval_ms;
}

static ds_slave_t *slave_for(uint8_t slave_id) {
    for (int i = 0; i < MAX_DALI_SLAVES; i++)
        if (s_ds[i].in_use && s_ds[i].slave_id == slave_id) return &s_ds[i];
    return NULL;
}

static uint8_t cached_arc(const ds_slave_t *d, uint8_t addr) {
    dali_ballast_state_t *b = state_cache_get_dali(d->slave_idx, addr);
    return b ? b->arc_level : 0u;
}

static uint16_t next_gen(ds_slave_t *d) {
    if (++d->gen == 0) d->gen = 1;   /* 0 = "no live query" */
    return d->gen;
}

void dali_state_init(void) {
    memset(s_ds, 0, sizeof s_ds);
    for (int i = 0; i < g_config.dali_slave_count && i < MAX_DALI_SLAVES; i++) {
        s_ds[i].in_use    = true;
        s_ds[i].slave_id  = g_config.dali_slave_ids[i];
        s_ds[i].slave_idx = (uint8_t)i;
        s_ds[i].next_step_at = get_absolute_time();
    }
}

void dali_state_mark_dirty(uint8_t slave_id, uint8_t addr) {
    ds_slave_t *d = slave_for(slave_id);
    if (!d || addr >= 64) return;
    d->verify |= (uint64_t)1 << addr;
}

void dali_state_mark_dirty_group(uint8_t slave_id, uint8_t group) {
    ds_slave_t *d = slave_for(slave_id);
    if (!d) return;
    /* Fan out through the cached membership. If the cache is empty or stale we
     * simply verify nothing extra — the idle sweep still catches it — rather
     * than guessing at members. */
    uint64_t members = state_cache_get_dali_group(d->slave_idx, group);
    d->verify |= members & d->present;
}

void dali_state_request_full_scan(uint8_t slave_id) {
    ds_slave_t *d = slave_for(slave_id);
    if (!d) return;
    d->scan = ~(uint64_t)0;   /* every address — presence is what we're discovering */
    LOG_INFO("dstate", "slave %u full scan armed", slave_id);
}

void dali_state_mark_scan(uint8_t slave_id, uint8_t addr) {
    ds_slave_t *d = slave_for(slave_id);
    if (!d || addr >= 64) return;
    d->scan |= (uint64_t)1 << addr;
}

static bool scan_busy(const ds_slave_t *d) {
    return d->scan != 0 || (d->busy && d->is_scan);
}

bool dali_state_scan_busy(uint8_t slave_id) {
    ds_slave_t *d = slave_for(slave_id);
    return d && scan_busy(d);
}

/* ── result handling ─────────────────────────────────────────────────────── */

/* The token names the STEP as well as the query: whichever step still expects
 * this token owns the answer. A token no step holds belongs to a query that was
 * superseded or abandoned, and is dropped. */
static void ds_cb(uint8_t slave_id, dq_result_t res, uint8_t answer, void *ctx) {
    ds_slave_t *d = slave_for(slave_id);
    if (!d) return;
    uint16_t g = (uint16_t)(uintptr_t)ctx;
    if (g == 0) return;
    for (int s = 0; s < STEP_DONE; s++) {
        if (d->st[s].gen != g) continue;
        d->st[s].res    = res;
        d->st[s].answer = answer;
        d->st[s].have   = true;
        return;
    }
}

/* A garbled answer counts as a collided ballast only if this bus produced a
 * clean result this recently. A scan steps through addresses every ~100-200 ms,
 * so a live bus refreshes this constantly; a dead bus never does. */
#define BUS_ALIVE_MS 5000u

/* Apply the presence evidence rules to one query outcome. Returns true if the
 * ballast is (still) believed present. */
static bool presence_from(ds_slave_t *d, uint8_t addr, dq_result_t res,
                          bool authoritative) {
    uint64_t bit = (uint64_t)1 << addr;
    switch (res) {
        case DQ_RES_OK:
            d->clean_seen = true;
            d->clean_ms   = to_ms_since_boot(get_absolute_time());
            d->strikes[addr] = 0;
            if (!(d->present & bit)) {
                d->present |= bit;
                state_cache_set_dali_present(d->slave_idx, addr, true);
                LOG_INFO("dstate", "%u.%u present", d->slave_id, addr);
            }
            return true;
        case DQ_RES_NAK:
            d->clean_seen = true;
            d->clean_ms   = to_ms_since_boot(get_absolute_time());
            /* The only outcome that is evidence of absence: the bus was healthy
             * and nobody answered a directed query.
             *
             * An EXPLICIT SCAN is authoritative and skips the debounce. The
             * debounce exists so a single missed reply during routine background
             * polling cannot drop a healthy ballast — but a scan is a deliberate
             * re-establishment of ground truth (boot, `scan`, post-provisioning),
             * and there the caution actively hurts: after a re-provision every
             * vacated address would linger as a phantom in HA, one per background
             * sweep step, so a full renumber could take minutes to converge. */
            if (d->strikes[addr] < 0xFFu) d->strikes[addr]++;
            if (authoritative) d->strikes[addr] = DALI_ABSENT_STRIKES;
            if (d->strikes[addr] >= DALI_ABSENT_STRIKES && (d->present & bit)) {
                d->present &= ~bit;
                state_cache_set_dali_present(d->slave_idx, addr, false);
                LOG_INFO("dstate", "%u.%u absent (%u clean no-answers)",
                         d->slave_id, addr, d->strikes[addr]);
            }
            return (d->present & bit) != 0;
        case DQ_RES_ERR:
            /* A garbled answer to a query sent to ONE short address means
             * something answered — typically two or more gear sharing the
             * address (a collision: new gear often ships on the same address).
             * They are real, they switch on and off together with every command
             * to that address, and HA must show them, not "unavailable" (house,
             * 2026-09-30: 3.1 and 3.3 were doubled up and hidden). The gateway
             * labels that overlap COLLISION or BUSFAULT depending on which pulse
             * its decoder tripped on, so the code cannot tell a collision from a
             * dead bus — an unpowered bus reads BUSFAULT on EVERY address. The
             * bus itself can: accept the garble as presence only if this bus
             * gave a clean answer or silence within BUS_ALIVE_MS. A dead bus
             * never does, so it cannot conjure 64 phantom ballasts. */
            if (d->clean_seen &&
                to_ms_since_boot(get_absolute_time()) - d->clean_ms < BUS_ALIVE_MS) {
                d->strikes[addr] = 0;
                if (!(d->present & bit)) {
                    d->present |= bit;
                    state_cache_set_dali_present(d->slave_idx, addr, true);
                    LOG_WARN("dstate", "%u.%u present, answer garbled — two or more "
                             "gear share this address (collision)", d->slave_id, addr);
                }
                return true;
            }
            return (d->present & bit) != 0;
        default:
            /* Dropped / lost: evidence about the transport, not about this
             * ballast. Freeze the counters and keep the current belief —
             * stale-but-never-wrong beats fresh-but-maybe-wrong. */
            return (d->present & bit) != 0;
    }
}

/* Commit whatever we learned about `addr` and emit if it changed. */
static void commit_ballast(ds_slave_t *d, uint8_t addr, uint8_t arc, uint8_t status,
                           bool have_groups, uint16_t groups) {
    dali_ballast_state_t *b = state_cache_get_dali(d->slave_idx, addr);
    bool changed = !b || b->arc_level != arc || b->status_byte != status;

    state_cache_set_dali_arc(d->slave_idx, addr, arc, status);

    if (have_groups) {
        for (uint8_t g = 0; g < 16; g++) {
            uint64_t mask = state_cache_get_dali_group(d->slave_idx, g);
            uint64_t bit  = (uint64_t)1 << addr;
            bool member   = (groups >> g) & 1u;
            uint64_t nm   = member ? (mask | bit) : (mask & ~bit);
            if (nm != mask) state_cache_set_dali_group(d->slave_idx, g, nm);
        }
    }
    if (changed) lighting_emit_dali_state(d->slave_id, addr, arc, status);
}

/* ── the sweep ───────────────────────────────────────────────────────────── */

/* Pick the next address to interrogate. Verification marks win; then scan
 * marks; then the rotating idle sweep over believed-present ballasts. */
static bool pick_next(ds_slave_t *d, uint8_t *addr_out, bool *is_scan) {
    /* A ballast mid-fade is re-queued for verification as soon as its poll
     * interval elapses — ahead of the background sweep, behind fresh commands. */
    if (d->fade_watch) {
        if (time_reached(d->fade_give_up_at)) {
            LOG_WARN("dstate", "slave %u fade never settled — dropping watch", d->slave_id);
            d->fade_watch = 0;
        } else if (time_reached(d->fade_next_at)) {
            d->verify |= d->fade_watch;
        }
    }
    if (d->verify) {
        *addr_out = (uint8_t)__builtin_ctzll(d->verify);
        *is_scan  = false;
        return true;
    }
    if (d->scan) {
        *addr_out = (uint8_t)__builtin_ctzll(d->scan);
        *is_scan  = true;
        return true;
    }
    if (sweep_interval_ms() == 0u) return false;   /* sweep disabled by config */
    if (!time_reached(d->next_step_at)) return false;

    /* Periodically probe an address we believe is EMPTY, so gear that was off at
     * boot or added later is discovered without a manual scan. */
    if (++d->step_count >= ABSENT_PROBE_EVERY) {
        d->step_count = 0;
        for (uint8_t i = 0; i < 64; i++) {
            uint8_t a = (uint8_t)((d->absent_cursor + i) & 0x3Fu);
            if (!(d->present & ((uint64_t)1 << a))) {
                d->absent_cursor = (uint8_t)((a + 1u) & 0x3Fu);
                *addr_out = a;
                /* Scan-style pass: a newly-found ballast needs its groups read
                 * too, not just its level. */
                *is_scan  = true;
                return true;
            }
        }
        /* Every address occupied — nothing to probe for. */
    }

    for (uint8_t i = 0; i < 64; i++) {
        uint8_t a = (uint8_t)((d->cursor + i) & 0x3Fu);
        if (d->present & ((uint64_t)1 << a)) {
            d->cursor = (uint8_t)((a + 1u) & 0x3Fu);
            *addr_out = a;
            *is_scan  = false;
            return true;
        }
    }
    /* Nothing believed present: re-arm a discovery pass rather than idling
     * forever, so a bus that comes up after us is still found. */
    d->next_step_at = make_timeout_time_ms(5000u);
    d->scan = ~(uint64_t)0;
    return false;
}

/* How many queries to submit together, starting at the pass's current step.
 * Only the fixed sequences pair: neither step of a pair needs the other's
 * answer, so both can be decided now. */
static uint8_t window_at(const ds_slave_t *d) {
    switch (d->step) {
        case STEP_STATUS:
            /* Pair STATUS+LEVEL only where we already believe someone is home.
             * On an address we believe empty, STATUS is a probe we expect to go
             * unanswered and LEVEL would be a second DALI frame thrown at
             * nobody — and 62 of a 64-address scan's frames are that case. */
            return (d->present & ((uint64_t)1 << d->addr)) ? 2u : 1u;
        case STEP_GROUPS_LO:
            return 2u;   /* GROUPS_LO + GROUPS_HI */
        default:
            return 1u;
    }
}

/* Submit the window starting at d->step. Returns false only if NOTHING went
 * out (the class is full); a second query refused after the first went out
 * simply narrows the window to one and is picked up by the next step. */
static bool issue(ds_slave_t *d) {
    static const uint8_t OPCODE[] = {
        [STEP_STATUS]     = Q_STATUS,
        [STEP_LEVEL]      = Q_ACTUAL_LEVEL,
        [STEP_GROUPS_LO]  = Q_GROUPS_0_7,
        [STEP_GROUPS_HI]  = Q_GROUPS_8_15,
    };
    uint8_t addr_byte = (uint8_t)(((d->addr & 0x3Fu) << 1) | 0x01u);
    /* Verification reads outrank the sweep: a command's real outcome must reach
     * HA promptly, while a background refresh can wait behind anything. This now
     * holds: DQ_PRIO_LEVEL_READ has its own scheduler class. */
    dq_prio_t prio = d->is_scan ? DQ_PRIO_BACKGROUND : DQ_PRIO_LEVEL_READ;
    uint8_t want = window_at(d);
    uint8_t n = 0;

    for (uint8_t i = 0; i < want; i++) {
        step_t s = (step_t)(d->step + i);
        uint16_t g = next_gen(d);
        if (!dq_submit(d->slave_id, prio, addr_byte, OPCODE[s],
                       DQ_ANSWER, 0, true, ds_cb, (void *)(uintptr_t)g))
            break;      /* class full — whatever is left goes next tick */
        d->st[s].gen  = g;
        d->st[s].have = false;
        n++;
    }
    if (n == 0) return false;

    d->win_n    = n;
    d->busy     = true;
    /* One deadline for the window: both queries were handed over at the same
     * instant, so it bounds each of them exactly as the per-query deadline it
     * replaced did. */
    d->deadline = make_timeout_time_ms(QUERY_DEADLINE_MS);
    return true;
}

/* Record one step's answer into the pass's accumulators and retire its token. */
static void record(ds_slave_t *d, step_t s) {
    bool ok = (d->st[s].res == DQ_RES_OK);
    uint8_t answer = d->st[s].answer;
    switch (s) {
        case STEP_STATUS:
            d->got_status_ok = ok;
            d->got_status    = ok ? answer : 0u;
            break;
        case STEP_LEVEL:
            /* A query that did not answer cleanly must not publish a fabricated
             * 0 — keep whatever the cache already holds.
             *
             * MASK (0xFF) is not a level either: IEC 62386-102 has QUERY ACTUAL
             * LEVEL answer MASK while the lamp is still starting up. Drivers
             * with a slow start answer it to the verify read ~100 ms after an
             * "on" (house 3.1/3.9/3.19, 2026-09-30), and it used to be published
             * as brightness 255 until the idle sweep came round minutes later.
             * Treat it like a fade in progress: keep the cached level, publish
             * nothing from this read, re-read at FADE_POLL_MS (advance()). */
            d->got_level_mask = ok && answer == 0xFFu;
            d->got_level_ok   = ok && !d->got_level_mask;
            d->got_level      = d->got_level_ok ? answer : cached_arc(d, d->addr);
            break;
        case STEP_GROUPS_LO:
            if (ok) { d->got_groups = (uint16_t)((d->got_groups & 0xFF00u) | answer);
                      d->got_groups_ok |= 1u; }
            break;
        case STEP_GROUPS_HI:
            if (ok) { d->got_groups = (uint16_t)((d->got_groups & 0x00FFu) | ((uint16_t)answer << 8));
                      d->got_groups_ok |= 2u; }
            break;
        default: break;
    }
    d->st[s].gen = 0;   /* answered: this token is no longer live */
}

/* Fold the completed window into the pass and decide what to ask next. */
static void advance(ds_slave_t *d) {
    uint64_t bit = (uint64_t)1 << d->addr;
    step_t last = (step_t)(d->step + d->win_n - 1u);

    for (step_t s = d->step; s <= last; s = (step_t)(s + 1)) record(d, s);

    /* Presence is judged on the FIRST directed query of the pass (QUERY STATUS):
     * one clean no-answer there is the absence evidence; the remaining steps are
     * pointless if nobody is home. */
    if (d->step == STEP_STATUS) {
        bool present = presence_from(d, d->addr, d->st[STEP_STATUS].res, d->is_scan);
        if (!present) {
            /* Abandon the rest of this ballast's pass. A LEVEL answer that
             * arrived in the same window is discarded with it: presence keys off
             * STATUS alone, and there is nothing to publish about a ballast that
             * is not there. */
            d->verify &= ~bit;
            d->scan   &= ~bit;
            d->busy    = false;
            d->step    = STEP_STATUS;
            return;
        }
    }

    if (last == STEP_LEVEL) {
        if (!d->is_scan) {
            /* Verification pass ends here: status + level are what a command
             * changes. Group membership is only re-read on a full scan. */
            if (!d->got_level_mask)   /* MASK: nothing measured yet — re-read below */
                commit_ballast(d, d->addr, d->got_level, d->got_status, false, 0);
            d->verify &= ~bit;
            /* Still ramping? Keep re-reading at FADE_POLL_MS until it settles,
             * and PUBLISH EACH SAMPLE. Every one is a real measured level, so HA
             * gets a live ramp rather than a jump at the end — that is wanted.
             *
             * What must never be published is a level we only ASSUMED: the
             * requested value before the ballast has clamped it to its own
             * min/max. See the "bri" branch of dali_apply_kv, which deliberately
             * reports nothing and lets these reads speak. */
            if ((d->got_status & STATUS_FADE_RUNNING) || d->got_level_mask) {
                if (!(d->fade_watch & bit)) {
                    d->fade_watch |= bit;
                    d->fade_give_up_at = make_timeout_time_ms(FADE_TRACK_MAX_MS);
                }
                d->fade_next_at = make_timeout_time_ms(FADE_POLL_MS);
            } else {
                d->fade_watch &= ~bit;
            }
            d->busy    = false;
            d->step    = STEP_STATUS;
            return;
        }
        d->got_groups    = 0;   /* about to read them */
        d->got_groups_ok = 0;
    }

    if (last == STEP_GROUPS_HI) {
        /* Membership is committed only from TWO clean answers. A QUERY GROUPS
         * that did not answer is bus evidence, not membership evidence: it
         * used to commit as an empty byte, wiping the ballast out of up to
         * eight groups in the cache (and HA) until the next full scan — seen
         * 2026-10-10 when a scan read timed out behind a long desired-state
         * drain. The cached membership stands instead. */
        if (d->got_groups_ok != 3u)
            LOG_WARN("dstate", "slave %u addr %u: QUERY GROUPS unanswered — membership "
                     "left as cached", d->slave_id, d->addr);
        commit_ballast(d, d->addr, d->got_level, d->got_status,
                       d->got_groups_ok == 3u, d->got_groups);
        d->scan  &= ~bit;
        if (d->got_level_mask) {   /* still starting: follow it like a fade */
            if (!(d->fade_watch & bit)) {
                d->fade_watch |= bit;
                d->fade_give_up_at = make_timeout_time_ms(FADE_TRACK_MAX_MS);
            }
            d->fade_next_at = make_timeout_time_ms(FADE_POLL_MS);
        }
        d->busy   = false;
        d->step   = STEP_STATUS;
        return;
    }

    d->step = (step_t)(last + 1);
    d->busy = false;   /* issue the next window on the following tick */
}

void dali_state_tick(void) {
    for (int i = 0; i < MAX_DALI_SLAVES; i++) {
        ds_slave_t *d = &s_ds[i];
        if (!d->in_use) continue;

        /* A scan is the one background burst worth paying for: seconds of work
         * whose whole point is to converge, where depth 1 leaves the gateway's
         * DALI engine idle between every frame. Armed here and dropped the
         * moment the last marked address is committed, from the single place
         * that knows both ends of a scan's life. */
        /* ARMED, not "a scan-style pass is running": the idle sweep's periodic
         * absent probe is also a scan-style pass, and one probe every six sweep
         * steps is the steady state dd83279 bounds at depth 1. */
        bool scanning = (d->scan != 0);
        if (scanning != d->burst) {
            dq_set_bg_burst(d->slave_id, scanning);
            d->burst = scanning;
        }

        /* A slave mid-provisioning owns its bus. */
        if (dali_provision_busy_slave(d->slave_id)) continue;

        /* Gateway not answering: stop generating work for it. The transport
         * keeps a dead slave off the wire (modbus.c absent-slave backoff), but
         * that alone is not enough — a skipped request completes instantly, and
         * every producer's pacing assumes a transaction costs ~25 ms of wall
         * time, so the sweep would churn through all 64 addresses at main-loop
         * speed and re-arm forever. Measured: 10589 skipped requests in 68 s
         * against two dead slaves. Off the bus, but pointless work.
         *
         * One attempt per LINK_RETRY_MS is enough to notice it come back — the
         * queue client's own reconnect and the 5 s scan re-arm do the rest. */
        if (mbq_client_consec_fail(d->slave_id) >= LINK_DOWN_FAILS) {
            if (!time_reached(d->link_retry_at)) continue;
            d->link_retry_at = make_timeout_time_ms(LINK_RETRY_MS);
        }

        if (d->busy) {
            step_t last = (step_t)(d->step + d->win_n - 1u);
            bool all = true;
            for (step_t s = d->step; s <= last; s = (step_t)(s + 1))
                if (!d->st[s].have) all = false;

            if (all) {
                advance(d);
            } else if (time_reached(d->deadline) && dq_pending_count(d->slave_id) > 0u) {
                /* Not lost — not even sent. The deadline is set when the window
                 * is handed to the scheduler, and while this gateway's
                 * desired-state table is draining (a Siri "all off", a big
                 * membership edit) background reads wait below it for
                 * seconds. Expiring here recorded real ballasts as unanswered.
                 * Same rule as the queue client's blocked head: push the
                 * deadline out while the wait is explained, and let it run
                 * again once the drain is done. */
                d->deadline = make_timeout_time_ms(QUERY_DEADLINE_MS);
            } else if (time_reached(d->deadline)) {
                /* Abandon whatever is still missing: record() drops its token so
                 * a late answer is ignored, and the outcome is bus evidence (not
                 * absence evidence) — the counters stay frozen, the belief
                 * stands. A step of the window that DID answer keeps its answer. */
                for (step_t s = d->step; s <= last; s = (step_t)(s + 1)) {
                    if (d->st[s].have) continue;
                    d->st[s].res    = DQ_RES_ERR;
                    d->st[s].answer = 0;
                    d->st[s].have   = true;
                }
                advance(d);
            }
            continue;
        }

        uint8_t addr; bool is_scan;
        if (d->step == STEP_STATUS) {
            if (!pick_next(d, &addr, &is_scan)) continue;
            d->addr    = addr;
            d->is_scan = is_scan;
            d->next_step_at = make_timeout_time_ms(sweep_interval_ms());
        }
        issue(d);   /* false = class full; retried next tick */
    }
}

/* ── observability ───────────────────────────────────────────────────────── */

void dali_state_debug_print(int slave_id) {
    bool any = false;
    for (int i = 0; i < MAX_DALI_SLAVES; i++) {
        ds_slave_t *d = &s_ds[i];
        if (!d->in_use) continue;
        if (slave_id >= 0 && d->slave_id != (uint8_t)slave_id) continue;
        any = true;
        int np = 0;
        for (uint8_t a = 0; a < 64; a++) if (d->present & ((uint64_t)1 << a)) np++;
        cdc_out_printf("dstate slave %u: present=%d busy=%u addr=%u step=%u scan=%s\n",
                       d->slave_id, np, d->busy, d->addr, (unsigned)d->step,
                       d->scan ? "armed" : "idle");
        cdc_out_printf("  present mask: %08lx%08lx\n",
                       (unsigned long)(d->present >> 32), (unsigned long)(d->present & 0xFFFFFFFFu));
        cdc_out_printf("  verify mask:  %08lx%08lx  cursor=%u\n",
                       (unsigned long)(d->verify >> 32), (unsigned long)(d->verify & 0xFFFFFFFFu),
                       d->cursor);
    }
    if (!any) cdc_out_printf("dstate: no matching DALI slave\n");
}
