brucejcooper/switch_gateway_firmware/src/state_cache.c

#include "state_cache.h"
#include "config.h"            /* fix #3: g_config */
#include "mapping.h"
#include <string.h>

static bool                  s_relay[RELAY_COUNT];
static dali_ballast_state_t  s_dali[MAX_DALI_SLAVES][DALI_ADDR_COUNT];
static uint64_t              s_dali_groups[MAX_DALI_SLAVES][16];

void state_cache_init(void) {
    memset(s_relay,        0, sizeof(s_relay));
    memset(s_dali,         0, sizeof(s_dali));
    memset(s_dali_groups,  0, sizeof(s_dali_groups));
}

static uint32_t s_relay_known;   /* bit per channel: a real value has landed */

bool state_cache_relay_known(uint8_t ch) {
    return ch < RELAY_COUNT && (s_relay_known & ((uint32_t)1 << ch)) != 0;
}

void state_cache_set_relay(uint8_t ch, bool on) {
    if (ch >= RELAY_COUNT) return;
    s_relay[ch] = on;
    /* Every caller is a coil READ or a write ACK, never a request, so reaching
     * here means this channel's value is now known rather than defaulted. */
    s_relay_known |= ((uint32_t)1 << ch);
}

bool state_cache_get_relay_on(uint8_t ch) {
    return ch < RELAY_COUNT ? s_relay[ch] : false;
}

int state_cache_slave_idx(uint8_t slave_id) {
    for (int i = 0; i < g_config.dali_slave_count; i++) {
        if (g_config.dali_slave_ids[i] == slave_id) return i;
    }
    return -1;
}

dali_ballast_state_t *state_cache_get_dali(uint8_t slave_idx, uint8_t addr) {
    if (slave_idx >= MAX_DALI_SLAVES || addr >= DALI_ADDR_COUNT) return NULL;
    return &s_dali[slave_idx][addr];
}

void state_cache_set_dali_arc(uint8_t slave_idx, uint8_t addr,
                               uint8_t arc, uint8_t status) {
    if (slave_idx >= MAX_DALI_SLAVES || addr >= DALI_ADDR_COUNT) return;
    bool fading = (status & 0x10) != 0;
    s_dali[slave_idx][addr].arc_level   = arc;
    s_dali[slave_idx][addr].status_byte = status;
    s_dali[slave_idx][addr].fading      = fading;
}

void state_cache_set_dali_config(uint8_t slave_idx, uint8_t addr,
                                  uint8_t max_l, uint8_t min_l,
                                  uint8_t power_on, uint8_t sys_fail,
                                  uint8_t fade_rate, uint8_t fade_time) {
    if (slave_idx >= MAX_DALI_SLAVES || addr >= DALI_ADDR_COUNT) return;
    dali_ballast_state_t *b = &s_dali[slave_idx][addr];
    b->max_level      = max_l;
    b->min_level      = min_l;
    b->power_on_level = power_on;
    b->sys_fail_level = sys_fail;
    b->fade_rate      = fade_rate;
    b->cfg_known      = true;   /* a real read landed */
    b->fade_time      = fade_time;
}

void state_cache_set_dali_present(uint8_t slave_idx, uint8_t addr, bool present) {
    if (slave_idx >= MAX_DALI_SLAVES || addr >= DALI_ADDR_COUNT) return;
    s_dali[slave_idx][addr].present = present;
}

void state_cache_set_dali_group(uint8_t slave_idx, uint8_t group, uint64_t mask) {
    if (slave_idx >= MAX_DALI_SLAVES || group >= 16) return;
    s_dali_groups[slave_idx][group] = mask;
}

uint64_t state_cache_get_dali_group(uint8_t slave_idx, uint8_t group) {
    if (slave_idx >= MAX_DALI_SLAVES || group >= 16) return 0;
    return s_dali_groups[slave_idx][group];
}

bool state_cache_dali_group_any_on(uint8_t slave_idx, uint8_t group) {
    if (slave_idx >= MAX_DALI_SLAVES || group >= 16) return false;
    uint64_t mask = s_dali_groups[slave_idx][group];
    while (mask) {
        uint8_t a = (uint8_t)__builtin_ctzll(mask);
        mask &= mask - 1;
        if (a >= DALI_ADDR_COUNT) continue;
        dali_ballast_state_t *b = &s_dali[slave_idx][a];
        /* MEASURED, not intended: a member counts as on because its last read
         * arc level was non-zero, never because we asked it to be on. Using the
         * commanded intent here made a group report on the instant a command was
         * sent, before any ballast had confirmed it — an inferred value on a
         * topic that must only carry measured ones. */
        if (b->present && b->arc_level > 0) return true;
    }
    return false;
}

uint8_t state_cache_dali_group_max_bri(uint8_t slave_idx, uint8_t group) {
    if (slave_idx >= MAX_DALI_SLAVES || group >= 16) return 0;
    uint64_t mask = s_dali_groups[slave_idx][group];
    uint8_t  max  = 0;
    while (mask) {
        uint8_t a = (uint8_t)__builtin_ctzll(mask);
        mask &= mask - 1;
        if (a >= DALI_ADDR_COUNT) continue;
        dali_ballast_state_t *b = &s_dali[slave_idx][a];
        if (b->present && b->arc_level > max) max = b->arc_level;
    }
    return max;
}
