brucejcooper/switch_gateway_firmware/src/config.h

#pragma once
#include <stdint.h>
#include <stdbool.h>
#include <stddef.h>   /* size_t, for config_hostname_set() */

/* Slaves are addressed by their real Modbus address. The relay (Waveshare) and
 * DALI (TinyModbus) gateways are kept in separate config lists so the firmware
 * can dispatch operations to the right protocol via slave_kind(). Default
 * hardware: relay at slave 1, DALI gateways at slaves 2 and 3. */
#define MAX_RELAY_SLAVES 2
#define MAX_DALI_SLAVES  2

typedef struct {
    uint16_t long_press_ms;        /* default 500 */
    uint16_t dim_repeat_ms;        /* default 200 */
    uint16_t reversal_window_ms;   /* default 400 */
    /* How often the controller reads each DALI gateway's FC04 0x0310 sysinfo
     * block (uptime / boot count / reset reason) and publishes it to HA as
     * diagnostic sensors. Piggybacks on the existing dirty-poll loop. 0 = off. */
    uint32_t gw_diag_interval_ms;  /* default 30000 */
    /* Background DALI sweep: interrogate ONE ballast per slave this often.
     * 0 disables it. This is a backstop for changes nothing tells us about (a
     * ballast that lost power, gear changed outside this controller) — every
     * command the system issues is verified immediately regardless, so a slow
     * sweep costs nothing user-visible. Default 10000. */
    uint32_t dali_sweep_interval_ms;
    uint8_t  relay_slave_ids[MAX_RELAY_SLAVES];
    uint8_t  relay_slave_count;
    uint8_t  dali_slave_ids[MAX_DALI_SLAVES];
    uint8_t  dali_slave_count;

    /* Pending relay_slaves/dali_slaves rewrite, staged by `cfg relay_slaves=`/
     * `dali_slaves=` (CLI). These lists are persist-only, reboot-to-apply: every
     * consumer above binds slave_id -> array index once at boot (dali_state.c,
     * dirty_poll.c, dali_queue.c keep their own frozen slave_id/idx tables) while
     * state_cache_slave_idx() recomputes the index live from
     * relay_slave_ids/dali_slave_ids on every call. Writing a rewrite straight
     * into the live arrays made the frozen tables and the live lookup disagree
     * mid-session, so e.g. removing slave 2 from a {2,3} list re-numbered slave
     * 3 to index 0 and caused emit_state_dali to publish slave 2's stale cached
     * state under slave 3's name while dirty_poll kept polling the removed
     * slave. config_save() persists these pending values in place of the live
     * ones when a rewrite is pending; the live arrays only pick it up on the
     * next config_load() at boot. */
    bool     relay_slaves_pending;
    uint8_t  pending_relay_slave_ids[MAX_RELAY_SLAVES];
    uint8_t  pending_relay_slave_count;
    bool     dali_slaves_pending;
    uint8_t  pending_dali_slave_ids[MAX_DALI_SLAVES];
    uint8_t  pending_dali_slave_count;

    /* Modbus bus settings (migrated from /modbus_baud.txt). */
    uint32_t baud;                 /* default 38400 */

    /* Some Modbus relay boards (e.g. Waveshare Modbus RTU Relay 32CH) return the
     * FC01 coil-status data field with its bytes in REVERSED order (byte0 =
     * highest channels), contrary to the Modbus spec. When set, the firmware
     * reverses the coil-data bytes before decoding so relay read-back matches the
     * physical state. Default 0 (spec-compliant). */
    bool     relay_byteswap;       /* default 0 */

    /* MQTT broker. host is a dotted-quad IP (hostname/DNS is a follow-up).
     * Compile defaults are placeholders only — never commit secrets. */
    char     mqtt_host[64];
    uint16_t mqtt_port;            /* default 1883 */
    char     mqtt_user[48];
    char     mqtt_pass[64];
    char     mqtt_prefix[24];      /* default "lighting" */

    /* Network. dhcp default on; static fields used only when dhcp == 0. */
    uint8_t  net_dhcp;             /* default 1 */
    uint8_t  net_ip[4], net_mask[4], net_gw[4], net_dns[4];
    /* DHCP option-12 hostname (default "lights"). Sent in DISCOVER/REQUEST so the
     * router registers it in local DNS — e.g. reach the board as "lights". DNS
     * label charset (letters/digits/hyphen); reboot to apply. Always stored
     * lowercased — see config_hostname_set(). */
    char     net_hostname[32];     /* default "lights" */

    /* Embedded config web UI (core 1). Basic-auth credentials; default
     * admin/admin. Plain HTTP (no TLS on the W5100S) — LAN-only fallback.
     *
     * The PASSWORD is never stored — only an Argon2id hash of it. The
     * device is the sole VERIFIER of web_pass (there is no third party to
     * present it to), unlike mqtt_pass below, which stays plaintext because
     * there the device is the CLIENT authenticating outward to the broker.
     * That asymmetry is why only this credential moved: /config.json is
     * readable over the CLI (`cat /config.json`) and lands in any flash/UPDI
     * dump or backup, so a plaintext web_pass sitting there defeated the
     * point of having a password at all. web_pass_hash/web_salt are each
     * stored as lowercase hex text (raw 32/16 bytes) rather than binary —
     * see web_auth.h for the KDF and codec, config.c's CFG_HEX schema kind
     * for how they load/save/validate like any other config string. */
    char     web_user[32];         /* default "admin" */
    char     web_pass_hash[65];    /* Argon2id(pass,salt), 32 raw bytes as hex; default = hash of "admin" */
    char     web_salt[33];         /* 16 raw bytes as hex; fixed for the factory default, random once a password is set */

    /* OTA manifest URL override. Empty = the compiled-in default
     * (FWUPDATE_MANIFEST_URL, fwupdate.c). Settable via CLI `cfg fw_url=…`
     * — lets a bench device poll a local HTTP server instead of the
     * production host, and production point at a staging server. */
    char     fw_url[128];
} global_config_t;

extern global_config_t g_config;

/* ── DHCP/DNS hostname validation ─────────────────────────────────────────
 * One RFC-1123 label: 1..31 chars, letters/digits/hyphen, not leading or
 * trailing a hyphen. Rejecting anything else keeps an illegal label off the
 * wire (some DHCP servers drop those silently).
 *
 * Lives here rather than in cli.c (where it started, private and
 * core-0-only) because all three write paths need the same rule: the CLI, the
 * web/API command handler on core 1, and config_load() itself — which used to
 * skip validation entirely and let anything in /config.json reach
 * netif_init(), and so HOST_NAME[] and the wire. Pure functions, no shared
 * state, safe to call from either core. */
bool config_hostname_ok(const char *s);

/* Validate `src` and write its LOWERCASED form into dst[cap]; returns false
 * and leaves dst untouched if `src` is not a valid label. Uppercase is legal
 * in a label (labels are case-insensitive, RFC 4343) but is normalised on the
 * way in so the stored value, the DHCP option-12 bytes and whatever the router
 * shows in local DNS are all the same string. */
bool config_hostname_set(char *dst, size_t cap, const char *src);

/* ── Config field schema — the single writer-side rule for every field ─────
 * See config.c's CFG_SCHEMA[] for the field table itself (name, storage
 * offset, limits) and the drift story that made it necessary: the same
 * "long_press_ms is 100..5000" rule used to live as a UI hint in
 * ha_bridge.c's CFG_NUM[] (never enforced), a raw (uint16_t) cast in the same
 * file's MQTT parse (silently wrapped an out-of-range value), and an
 * unchecked atoi() in cli.c's cmd_cfg — three copies, none of them agreeing,
 * none of them actually bounding anything. Every writer (CLI, the intercore
 * command dispatch, the on-board HTTP API, ha_bridge's MQTT parse) now
 * funnels through the two apply functions below instead of hand-rolling its
 * own parse-and-poke. */
typedef enum {
    CFG_APPLY_OK,             /* validated and written to g_config */
    CFG_APPLY_UNKNOWN_KEY,    /* no schema row named `key` */
    CFG_APPLY_OUT_OF_RANGE,   /* numeric value outside the schema row's min/max */
    CFG_APPLY_TOO_LONG,       /* string value does not fit the field (strfit.h rule) */
    CFG_APPLY_INVALID,        /* wrong-kind API for this key, or a hostname/credential
                                * that failed its own rule (bad label; empty credential) */
} cfg_apply_result_t;

/* Validate + write a numeric or bool field, addressed by its schema key
 * (e.g. "long_press_ms", "mqtt_port", "relay_byteswap"). Range-checked
 * against the schema row before anything is written — out of range leaves
 * g_config untouched. CORE-0-ONLY: writes g_config, the single-writer struct
 * core 0 owns. */
cfg_apply_result_t config_apply_u32(const char *key, uint32_t value);

/* Validate + write a string, hostname, or credential field, addressed by its
 * schema key (e.g. "mqtt_host", "net_hostname", "web_user"). A too-long value
 * (CFG_STR/CFG_CRED) or an invalid label (CFG_HOSTNAME, via
 * config_hostname_set()) leaves g_config untouched. A credential field
 * additionally refuses an empty value (CFG_APPLY_INVALID) — today's rule for
 * a web-credential write; the both-or-neither pairing for a full
 * user+pass change stays in ic_seam.c, not here. CORE-0-ONLY: writes
 * g_config. */
cfg_apply_result_t config_apply_str(const char *key, const char *value);

/* Pure lookup: the [min,max] a numeric schema field enforces, or false if
 * `key` names no numeric field. Touches only the read-only schema table, so
 * unlike the two functions above this is safe to call from EITHER core —
 * e.g. so ha_bridge.c's HA-discovery number entities (core 1) advertise the
 * exact bounds config_apply_u32() (core 0) enforces, instead of a second,
 * driftable copy of the same numbers. */
bool config_field_range(const char *key, uint32_t *min, uint32_t *max);

/* Pure lookup: the longest value (NUL excluded) a string/hostname/credential
 * schema field will accept, or 0 if `key` names no such field. Same
 * either-core safety as config_field_range(). */
unsigned config_field_maxlen(const char *key);

typedef enum {
    SLAVE_KIND_UNKNOWN = 0,
    SLAVE_KIND_RELAY,
    SLAVE_KIND_DALI,
} slave_kind_t;

/* Resolve a Modbus slave id to its protocol kind via the configured lists.
 * Returns SLAVE_KIND_UNKNOWN for slave 0 (broadcast) and unconfigured ids. */
slave_kind_t slave_kind(uint8_t slave_id);

/* Load from /config.json; fills defaults if absent or corrupt.
 * Uses stdio fopen() — works with pico-vfs. Accepts both the legacy
 * "relay_slave":N scalar and the new "relay_slaves":[...] array shape. */
bool config_load(void);

/* Persist current g_config to /config.json */
bool config_save(void);

void config_defaults(void);
