brucejcooper/switch_gateway_firmware/src/net/http_server.c

/*
 * http_server.c — non-blocking embedded config web server (core 1). See header.
 *
 * Design notes:
 *  - One connection per socket, single request then close. The W5100S has no
 *    accept(): a socket sits in SOCK_LISTEN and auto-promotes to ESTABLISHED on
 *    a SYN, so each managed socket is its own little accept-serve-close loop.
 *  - Everything is poll-driven off the socket status register (getSn_SR) and the
 *    RX/TX free-size registers (getSn_RX_RSR / getSn_TX_FSR). We never block and
 *    send at most one bounded chunk per socket per tick, so a large transfer
 *    can't starve mqtt_app_tick() or trip the core-1 watchdog.
 *  - Responses are close-delimited (Connection: close). /api/state has no
 *    Content-Length and is streamed straight from web_state's cursor renderer.
 */

#include "http_server.h"
#include "web_assets.h"
#include "web_state.h"
#include "netif.h"
#include "intercore.h"
#include "web_auth.h"      /* KDF verify/hash + hex codec — check_auth(), POST /api/auth */
#include "log.h"
#include "cdc_out.h"       /* cdc_out_history() — GET /api/log */
#include "fwupdate.h"      /* fwupdate_status_json/announce/install — /api/ota */
#include "remote_cli.h"    /* POST /api/cli — the CLI over HTTP */
#include "cli.h"           /* CLI_LINE_MAX */

#include "socket.h"
#include "wizchip_conf.h"   /* getSn_SR / getSn_RX_RSR / getSn_TX_FSR / Sn_* */
#include "jsmn.h"
#include "jsmn_util.h"      /* jtok_eq/jfind/jint/jstr_set/... — shared jsmn helper layer */
#include "mapping.h"        /* mapping_target_t, TARGET_*, MAX_TARGETS_PER_BTN */
#include "config.h"         /* config_hostname_set() — /api/net validation */
#include "strfit.h"         /* str_set()/STR_MAX_LEN() — the shared fits-or-fails rule */

#include "pico/time.h"
#include <string.h>
#include <stdio.h>
#include <stdlib.h>
#include <stdbool.h>
#include <stdint.h>

#define HTTP_PORT        80
#define HTTP_SOCK_BUFSZ  2048u   /* per-socket TX/RX buffer (netif txsz/rxsz) */
#define HTTP_BUF         2048u    /* per-conn request reassembly / send staging */
#define RECV_TIMEOUT_MS  8000u
#define SEND_TIMEOUT_MS  8000u
/* POST /api/cli: how long to hold the connection open for core 0 to run the
 * command. `discover` and the other blocking commands take seconds. */
#define CLI_WAIT_MS     30000u
#define DRAIN_TIMEOUT_MS 2000u

/* Managed sockets. Sockets 2-3 are always ours; socket 0 is lent opportunistically
 * by the netif DHCP arbiter (revocable bonus capacity). s_conn[2] is socket 0 and
 * is only pumped while netif_web_sock0_enabled(). */
#define N_BASE  2                 /* sockets 2,3 — always ours */
#define N_SOCK  (N_BASE + 1)      /* + socket 0 (opportunistic) */
static const uint8_t k_socks[N_SOCK] = { 2, 3, 0 };

typedef enum { CONN_LISTEN, CONN_RECV, CONN_WAIT, CONN_SEND, CONN_DRAIN } conn_state_t;
typedef enum { RESP_MEM, RESP_STATE } resp_kind_t;
typedef enum { PH_HDR, PH_BODY } send_phase_t;

typedef struct {
    uint8_t  sn;
    conn_state_t st;
    uint32_t t_ms;            /* last activity for timeouts */

    /* request reassembly (during CONN_RECV) */
    uint16_t rx_len;
    bool     hdr_complete;
    uint16_t content_len;
    uint16_t body_start;      /* index of body in buf */

    /* response */
    resp_kind_t  resp;
    send_phase_t phase;
    /* staged bytes to send out of buf[] (header, then state chunks) */
    uint16_t out_len, out_sent;
    /* RESP_MEM body (points into flash/rodata) */
    const uint8_t *mem; uint32_t mem_len, mem_sent;
    /* RESP_STATE streaming */
    web_render_cursor_t cur;
    bool state_done;

    /* POST /api/cli: the remote_cli mailbox ticket this connection holds (0 =
     * none). Held from submit until the connection is reset, because the
     * response body streams straight out of the mailbox's output buffer. */
    uint32_t rcli_ticket;

    char buf[HTTP_BUF];
} conn_t;

static conn_t s_conn[N_SOCK];
static bool   s_sock0_active = false;   /* are we currently serving on socket 0? */

/* Live copy of the Basic-auth credentials. Seeded from the launch snapshot;
 * updated in place when the password is changed via POST /api/auth so the new
 * credentials take effect immediately (core 0 persists them for next boot).
 *
 * s_hash_hex/s_salt_hex are the same hex text config.h stores (web_auth.h's
 * KDF verifies against the raw bytes — see check_auth()). Unlike the old
 * s_pass, this is NOT the credential the server compares candidates against
 * directly; it's what a full KDF run is checked against on a cache miss.
 *
 * s_authcache_digest/s_authcache_valid are the hot-path shortcut: a BLAKE2b
 * digest of the last "user:pass" candidate that passed a full KDF verify,
 * checked with a cheap constant-time compare on every later request instead
 * of re-running Argon2id on each ~1.5 s web-UI poll. Invalidated (only)
 * wherever s_hash_hex/s_salt_hex themselves change — see http_server_init()
 * and the POST /api/auth handler, the only two writers. */
static char s_user[32];
static char s_hash_hex[65];
static char s_salt_hex[33];
static uint8_t s_authcache_digest[WEB_AUTH_HASH_LEN];
static bool    s_authcache_valid = false;

static uint32_t now_ms(void) { return to_ms_since_boot(get_absolute_time()); }

/* ── socket lifecycle ───────────────────────────────────────────────────────*/
/* Count socket()/listen() failures here. arm_listen runs in the per-tick pump,
 * so per the hot-path rule we must NOT LOG_* — bump a counter, surfaced off the
 * hot path via http_server_arm_fail_count(). A non-zero, climbing count means a
 * web socket failed to (re)arm and that listener is dead. */
static uint32_t s_arm_fails = 0;
uint32_t http_server_arm_fail_count(void) { return s_arm_fails; }

/* Self-heal watchdog: if NEITHER base socket reaches LISTEN/ESTABLISHED for this
 * long while netif is otherwise up, the W5100S socket layer is wedged (arm_listen
 * keeps failing, so port 80 refuses) and only a full chip reset clears it — ask
 * netif to recover. s_last_listen_ms tracks the last tick a base socket was
 * healthy; it's also reset whenever netif isn't ready so the window only counts
 * contiguous wedged-while-up time. */
#define WEB_WEDGE_TIMEOUT_MS 30000u
static uint32_t s_last_listen_ms = 0;

/* GET /api/log snapshot. cdc_out_history() must be linearised into a stable buffer
 * because RESP_MEM streams the body pointer across many ticks while the live ring
 * keeps moving. One shared buffer → one /api/log stream at a time; a second
 * concurrent request gets 503 until the first connection is re-armed. */
#define LOG_SNAP_CAP 8192
static char    s_logbuf[LOG_SNAP_CAP];
static conn_t *s_logbuf_owner = NULL;

/* Common to arm_listen and release_sock0_conn: drop whatever this connection
 * was mid-doing and blank its request/response scratch state. Always releases
 * the shared /api/log snapshot owner — a connection that's being torn down
 * (listener re-armed, or socket 0 yanked back by netif) can never finish
 * reading it, so holding the owner slot past this point only starves every
 * later GET /api/log with a permanent 503. */
static void reset_conn_state(conn_t *c) {
    if (s_logbuf_owner == c) s_logbuf_owner = NULL;
    if (c->rcli_ticket) { rcli_release(c->rcli_ticket); c->rcli_ticket = 0; }
    c->st = CONN_LISTEN;
    c->rx_len = 0; c->hdr_complete = false; c->content_len = 0; c->body_start = 0;
    c->out_len = c->out_sent = 0; c->mem = NULL; c->mem_len = c->mem_sent = 0;
    c->state_done = false;
}

static void arm_listen(conn_t *c) {
    reset_conn_state(c);
    close(c->sn);
    int8_t s = socket(c->sn, Sn_MR_TCP, HTTP_PORT, SF_IO_NONBLOCK);
    int8_t l = (s == c->sn) ? listen(c->sn) : (int8_t)-1;
    if (s != c->sn || l != SOCK_OK) s_arm_fails++;
}

/* Socket 0 was just yanked back by the netif arbiter (DHCP renewal due, or
 * ping/ota/fwupdate acquired it) — see http_server_tick(). We no longer own
 * the physical socket, so unlike arm_listen() we must NOT re-open/listen on
 * it (that would fight whoever the arbiter handed it to next); we only close
 * our end and blank the connection slot so it starts clean if/when the loan
 * returns and arm_listen() re-arms it for real. */
static void release_sock0_conn(conn_t *c) {
    reset_conn_state(c);
    close(c->sn);
}

void http_server_init(void) {
    const ic_snapshot_t *sn = intercore_snapshot();
    /* Fall back to admin/admin's factory-default hash+salt only when there is
     * NO snapshot at all (pure bootstrap) — the same literals
     * config_defaults() compiles in (config.c), so this fallback and a fresh
     * device's real snapshot agree. An EMPTY hash/salt in a REAL snapshot is
     * not "unset" — a fresh device gets the real default hash from
     * config_defaults(), so empty can only mean config_load() deliberately
     * cleared an unusable stored credential (see the CFG_HEX/CFG_CRED
     * fail-closed rules, config.c). Defaulting that back to admin/admin would
     * turn a damaged config into an auth downgrade, which is exactly what the
     * clearing exists to prevent; check_auth() refuses while either stays
     * empty. */
    snprintf(s_user,     sizeof s_user,     "%s", sn ? sn->web_user      : "admin");
    snprintf(s_hash_hex, sizeof s_hash_hex, "%s", sn ? sn->web_pass_hash
             : "05143c762a259de70d8e6e2eac4b0a857d816fa43071e968e24680f32d39bd8c");
    snprintf(s_salt_hex, sizeof s_salt_hex, "%s", sn ? sn->web_salt
             : "6c6967687473776974636864666c7430");
    s_authcache_valid = false;
    if (!s_user[0] || !s_hash_hex[0] || !s_salt_hex[0])
        LOG_ERR("http", "web credential unusable — UI locked until /config.json is repaired");
    for (size_t i = 0; i < N_SOCK; i++) s_conn[i].sn = k_socks[i];
    /* Arm the always-ours sockets now; socket 0 is armed on demand by the tick. */
    for (size_t i = 0; i < N_BASE; i++) arm_listen(&s_conn[i]);
    s_last_listen_ms = now_ms();
    LOG_INFO("http", "config web server on :%d (sockets 2-3 +0 when DHCP idle)", HTTP_PORT);
}

/* ── tiny HTTP helpers ───────────────────────────────────────────────────────*/

/* Case-insensitive search for a header; returns a pointer to the value (leading
 * spaces skipped) within the NUL-terminated request, or NULL. */
static const char *find_header(const char *req, const char *name) {
    size_t nlen = strlen(name);
    for (const char *p = req; *p; ) {
        const char *eol = strstr(p, "\r\n");
        if (!eol || eol == p) break;                 /* end of headers */
        if ((size_t)(eol - p) > nlen && p[nlen] == ':' &&
            strncasecmp(p, name, nlen) == 0) {
            const char *v = p + nlen + 1;
            while (*v == ' ' || *v == '\t') v++;
            return v;
        }
        p = eol + 2;
    }
    return NULL;
}

static int b64val(char c) {
    if (c >= 'A' && c <= 'Z') return c - 'A';
    if (c >= 'a' && c <= 'z') return c - 'a' + 26;
    if (c >= '0' && c <= '9') return c - '0' + 52;
    if (c == '+') return 62;
    if (c == '/') return 63;
    return -1;
}
static int b64decode(const char *in, uint8_t *out, int outcap) {
    int n = 0, bits = 0, acc = 0;
    for (; *in && *in != '\r' && *in != '\n' && *in != ' '; in++) {
        int v = b64val(*in);
        if (v < 0) break;                /* padding '=' or invalid -> stop */
        acc = (acc << 6) | v; bits += 6;
        if (bits >= 8) { bits -= 8; if (n < outcap) out[n++] = (uint8_t)(acc >> bits); }
    }
    return n;
}

/* Validate Basic auth against the snapshot credentials.
 *
 * HOT PATH: called once per request, including every ~1.5 s /api/state poll
 * from every open web-UI tab — see the file header's "do NOT log / do NOT
 * block" rule. A full Argon2id run (tens to a few hundred ms on this MCU,
 * see web_auth.c) on every one of those would starve the connection pump and
 * mqtt_app_tick() sharing this core, so this function runs the KDF at most
 * ONCE per credential — the first request after boot or after a password
 * change — and thereafter compares a cheap BLAKE2b digest
 * (web_auth_fast_digest(), microseconds) against a cache seeded by that one
 * KDF verify. The cache is content-addressed by nothing but its own explicit
 * invalidation: http_server_init() and the POST /api/auth handler are the
 * ONLY two writers of s_hash_hex/s_salt_hex, and both clear
 * s_authcache_valid in the same breath, so the cache can never outlive the
 * credentials it was computed against.
 *
 * check_auth() itself never disagrees with the slow path about what counts
 * as a match — every comparison, fast or slow, goes through
 * web_auth_verify_equal() (constant-time), and the fast-path digest is only
 * ever written immediately after a slow-path pass, never predicted. */
static bool check_auth(const char *req) {
    /* Fail CLOSED on a missing credential. config_load() clears the hash (or
     * salt) when the stored value is unusable, deliberately refusing to fall
     * back to the compiled admin/admin default — a damaged config must not
     * become an auth downgrade. Without this check an empty hash would
     * accept anything hashing to it — impossible for a REAL hash, but an
     * empty s_hash_hex is exactly the "cleared" marker, not a real hash. */
    if (!s_user[0] || !s_hash_hex[0] || !s_salt_hex[0]) return false;
    const char *v = find_header(req, "Authorization");
    if (!v || strncasecmp(v, "Basic ", 6) != 0) return false;
    uint8_t dec[96];
    int n = b64decode(v + 6, dec, sizeof dec - 1);
    if (n <= 0) return false;
    dec[n] = '\0';

    /* Split "user:pass" (Basic auth's wire format) at the first colon. */
    char *colon = memchr(dec, ':', (size_t)n);
    if (!colon) return false;
    *colon = '\0';
    const char *cand_user = (const char *)dec;
    const char *cand_pass = (const char *)colon + 1;

    /* Username is an identifier, not a secret (CFG_CRED's own framing,
     * config.h) — same plain compare the combined-string version above used
     * for the whole "user:pass", no behaviour change for this half. */
    if (strcmp(cand_user, s_user) != 0) return false;

    uint8_t digest[WEB_AUTH_HASH_LEN];
    web_auth_fast_digest(cand_user, cand_pass, digest);

    bool ok;
    if (s_authcache_valid && web_auth_verify_equal(digest, s_authcache_digest)) {
        ok = true;   /* fast path: matches the last candidate that verified */
    } else {
        uint8_t salt[WEB_AUTH_SALT_LEN], want_hash[WEB_AUTH_HASH_LEN];
        if (!web_auth_hex_decode(s_salt_hex, salt, sizeof salt) ||
            !web_auth_hex_decode(s_hash_hex, want_hash, sizeof want_hash)) {
            ok = false;   /* can't happen given the emptiness check above, but never trust it */
        } else {
            uint8_t got_hash[WEB_AUTH_HASH_LEN];
            /* retry_ms=0: a single non-blocking attempt. Losing the race for
             * the shared KDF work area (core 0 or the /api/auth handler mid-
             * hash) fails CLOSED for this one request rather than blocking
             * the tick loop — see this function's header comment and
             * web_auth.c's concurrency argument for why that's safe: the
             * next poll (or an impatient human's retry) tries again, and a
             * busy KDF never yields a cheap "yes" for a request that hasn't
             * actually been checked. */
            ok = web_auth_hash(cand_pass, salt, got_hash, 0) &&
                 web_auth_verify_equal(got_hash, want_hash);
            web_auth_wipe(got_hash, sizeof got_hash);
        }
        web_auth_wipe(salt, sizeof salt);
        web_auth_wipe(want_hash, sizeof want_hash);
        if (ok) {
            memcpy(s_authcache_digest, digest, sizeof digest);
            s_authcache_valid = true;
        }
    }
    web_auth_wipe(digest, sizeof digest);
    web_auth_wipe(dec, sizeof dec);
    return ok;
}

/* ── response builders ───────────────────────────────────────────────────────*/

static void resp_mem(conn_t *c, const char *status, const char *extra_hdr,
                     const char *mime, const uint8_t *body, uint32_t len, bool gz) {
    c->out_len = (uint16_t)snprintf(c->buf, sizeof c->buf,
        "HTTP/1.1 %s\r\n"
        "Content-Type: %s\r\n"
        "Content-Length: %lu\r\n"
        "%s%s"
        "Connection: close\r\n\r\n",
        status, mime, (unsigned long)len,
        gz ? "Content-Encoding: gzip\r\n" : "",
        extra_hdr ? extra_hdr : "");
    c->out_sent = 0;
    c->resp = RESP_MEM; c->phase = PH_HDR;
    c->mem = body; c->mem_len = len; c->mem_sent = 0;
    c->st = CONN_SEND; c->t_ms = now_ms();
}

/* Small fixed text/JSON reply (body is a string literal in flash). */
static void resp_text(conn_t *c, const char *status, const char *mime, const char *body) {
    resp_mem(c, status, NULL, mime, (const uint8_t *)body, (uint32_t)strlen(body), false);
}

/* Dump the retained log scrollback (GET /api/log). Network path to the logs that
 * otherwise live only on USB-CDC — works even when USB has no reader or is wedged.
 * Snapshots under cdc_out's lock into s_logbuf, then streams it like any RESP_MEM
 * body. Auth is already enforced by route() before we get here. */
static void resp_log(conn_t *c) {
    if (s_logbuf_owner && s_logbuf_owner != c) {
        resp_text(c, "503 Service Unavailable", "text/plain", "log busy, retry\n");
        return;
    }
    int n = cdc_out_history(s_logbuf, sizeof s_logbuf);
    s_logbuf_owner = c;
    resp_mem(c, "200 OK", "Cache-Control: no-store\r\n", "text/plain; charset=utf-8",
             (const uint8_t *)s_logbuf, (uint32_t)n, false);
}

/* Small dynamic JSON reply. Unlike resp_text (whose body must be a stable
 * pointer valid across the multi-tick send), this copies the body INTO the
 * connection's own buf right after the header, so mem points at per-connection
 * storage — safe with concurrent connections, no shared buffer/owner guard. */
static void resp_json(conn_t *c, const char *status, const char *body, int blen) {
    int hlen = snprintf(c->buf, sizeof c->buf,
        "HTTP/1.1 %s\r\n"
        "Content-Type: application/json\r\n"
        "Content-Length: %d\r\n"
        "Cache-Control: no-store\r\n"
        "Connection: close\r\n\r\n",
        status, blen);
    if (hlen < 0) hlen = 0;
    if (hlen > (int)sizeof c->buf) hlen = (int)sizeof c->buf;
    if (blen > (int)sizeof c->buf - hlen) blen = (int)sizeof c->buf - hlen;
    memcpy(c->buf + hlen, body, (size_t)blen);
    c->out_len = (uint16_t)hlen; c->out_sent = 0;
    c->resp = RESP_MEM; c->phase = PH_HDR;
    c->mem = (const uint8_t *)(c->buf + hlen); c->mem_len = (uint32_t)blen; c->mem_sent = 0;
    c->st = CONN_SEND; c->t_ms = now_ms();
}

/* GET /api/ota — firmware/update status for the web Firmware tab and for
 * scripted/agent polling. Auth is already enforced by route(). */
static void resp_ota(conn_t *c) {
    char body[900];
    int n = fwupdate_status_json(body, sizeof body);
    resp_json(c, "200 OK", body, n);
}

static void resp_401(conn_t *c) {
    resp_mem(c, "401 Unauthorized",
             "WWW-Authenticate: Basic realm=\"lightswitch\"\r\n",
             "text/plain", (const uint8_t *)"auth required", 13, false);
}

static void resp_state(conn_t *c) {
    char etag[24];
    snprintf(etag, sizeof etag, "ETag: \"%lu\"\r\n", (unsigned long)web_state_seq());
    c->out_len = (uint16_t)snprintf(c->buf, sizeof c->buf,
        "HTTP/1.1 200 OK\r\n"
        "Content-Type: application/json\r\n"
        "Cache-Control: no-store\r\n"
        "%s"
        "Connection: close\r\n\r\n", etag);
    c->out_sent = 0;
    c->resp = RESP_STATE; c->phase = PH_HDR;
    web_render_begin(&c->cur); c->state_done = false;
    c->st = CONN_SEND; c->t_ms = now_ms();
}

/* ── JSON request parsing (jsmn) + write dispatch ───────────────────────────*/
/* jtok_eq/jfind/jhas/jint/jint_key/jstr_get_unescaped/jstr_clamped/jbool_key/
 * jip are the shared helpers, jsmn_util.h — see that header for why
 * jstr_get_unescaped() (via jfield_unescaped() above, not jstr_set(), and
 * not jstr_clamped — this file's old jstr_key) is what every /api/mqtt,
 * /api/auth and /api/net(hostname) field below decodes through: the escaped
 * JSON text jsmn hands back is not what the browser typed (see json_str.h's
 * header comment for the literal-backslash bug that was), and every one of
 * these fields is stored and later echoed back as if it were. jstr_clamped
 * survives only for jip()'s dotted-quad scratch and the "mode" string a few
 * lines down — see its own comment for why those two are fine with the old
 * clamp-not-reject behaviour. jtri() stays local: it decodes the
 * {on: true|false|"toggle"} tri-state used only by the DALI/relay/group
 * write handlers here, not a generic jsmn primitive. */
static bool jtri(const char *js, const jsmntok_t *t, int n, const char *key, ic_tri_t *out) {
    int i = jfind(js, t, n, key);
    if (i < 0) return false;
    if (jtok_eq(js, &t[i], "toggle"))                              *out = IC_TRI_TOGGLE;
    else if (jtok_eq(js, &t[i], "on") || jtok_eq(js, &t[i], "true")) *out = IC_TRI_ON;
    else { char ch = js[t[i].start]; *out = (ch == 't' || ch == '1') ? IC_TRI_ON : IC_TRI_OFF; }
    return true;
}
/* Walk a JSON targets array [{slave,addr|group},...] at value-token `ai`. */
static uint8_t parse_targets_at(const char *js, const jsmntok_t *t, int n, int ai,
                                mapping_target_t *out, uint8_t max) {
    if (ai < 0 || t[ai].type != JSMN_ARRAY) return 0;
    uint8_t c = 0; int i = ai + 1, count = t[ai].size;
    for (int el = 0; el < count && c < max && i < n; el++) {
        if (t[i].type != JSMN_OBJECT) break;
        int sz = t[i].size; i++;
        int sl = 0, addr = 0, grp = -1;
        for (int f = 0; f < sz && i + 1 < n; f++) {
            if      (jtok_eq(js, &t[i], "slave")) sl   = (int)jint(js, &t[i + 1]);
            else if (jtok_eq(js, &t[i], "addr"))  addr = (int)jint(js, &t[i + 1]);
            else if (jtok_eq(js, &t[i], "group")) grp  = (int)jint(js, &t[i + 1]);
            i += 2;
        }
        out[c].slave = (uint8_t)sl;
        out[c].addr  = grp >= 0 ? TARGET_MAKE_GROUP(grp) : (uint8_t)(addr & 0x3F);
        c++;
    }
    return c;
}
/* Decode a JSON member array [0,1,5] at value-token `ai` to a 64-bit mask. */
static uint64_t parse_members_at(const char *js, const jsmntok_t *t, int n, int ai) {
    uint64_t mask = 0;
    if (ai < 0 || t[ai].type != JSMN_ARRAY) return 0;
    int count = t[ai].size, i = ai + 1;
    for (int el = 0; el < count && i < n; el++, i++) {
        int a = (int)jint(js, &t[i]);
        if (a >= 0 && a < 64) mask |= (1ull << a);
    }
    return mask;
}

static void resp_ok(conn_t *c) { resp_text(c, "200 OK", "application/json", "{\"ok\":true}"); }

/* 400 for an over-long field, naming the field and its real maximum so the
 * caller learns where the boundary is rather than just that they crossed it.
 * `cap` is the destination's sizeof, so the limit quoted can never drift from
 * the one actually enforced. */
static void resp_too_long(conn_t *c, const char *field, size_t cap) {
    char msg[128];
    snprintf(msg, sizeof msg, "{\"error\":\"%s is too long (max %u characters)\"}",
             field, STR_MAX_LEN(cap));
    resp_text(c, "400 Bad Request", "application/json", msg);
}

/* 400 for a malformed JSON string escape — a dangling backslash, an escape
 * letter outside RFC 8259 §7's set, bad \uXXXX hex, or a lone UTF-16
 * surrogate (json_str.h's json_unescape(), the decode step behind
 * jstr_get_unescaped()/jfield_unescaped() below). Distinct from
 * resp_too_long() so the caller learns their JSON was broken, not merely
 * that the value was oversized — jsmn itself accepted the token (it only
 * validates that an escape's SHAPE is legal, never decodes it; see
 * json_str.h's header comment), so this is the first point in the pipeline
 * that actually looks at what the escape decodes to. */
static void resp_bad_escape(conn_t *c, const char *field) {
    char msg[96];
    snprintf(msg, sizeof msg, "{\"error\":\"%s has a malformed JSON string escape\"}", field);
    resp_text(c, "400 Bad Request", "application/json", msg);
}

/* jstr_get_unescaped() into dst[cap], translating its four states into the
 * two failure responses a write handler's string field can produce and
 * sending the response itself — every NEW-write call site below is just
 * `if (!jfield_unescaped(...)) return;`. JSTR_ABSENT (present but not a JSON
 * string — jhas() already gated presence at every call site below) is
 * folded into "too long" rather than getting its own message: that matches
 * this file's PRE-existing behaviour, where a false return from jstr_set()
 * meant the same thing for "wrong type" and "too long" and both produced
 * resp_too_long(). Splitting that apart is not this pass's job. */
static bool jfield_unescaped(conn_t *c, const char *js, const jsmntok_t *t, int n,
                             const char *key, char *dst, size_t cap) {
    jstr_status_t s = jstr_get_unescaped(js, t, n, key, dst, cap);
    if (s == JSTR_OK) return true;
    if (s == JSTR_MALFORMED) resp_bad_escape(c, key);
    else                     resp_too_long(c, key, cap);
    return false;
}

static void push_cmd_resp(conn_t *c, const ic_cmd_t *cmd) {
    if (intercore_push_cmd(cmd)) resp_ok(c);
    else resp_text(c, "503 Service Unavailable", "application/json", "{\"error\":\"busy\"}");
}
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
