brucejcooper/switch_gateway_firmware/src/dali_queue.c

/*
 * dali_queue.c — DALI adapter over the generic Modbus command-queue client
 * See dali_queue.h for the model.
 *
 * This layer is DALI-SPECIFIC and sits ABOVE the DALI-agnostic mbq_client:
 *   1. a per-slave PULL SCHEDULER: storage partitioned by
 *      priority class rather than one shared FIFO, plus per-ballast dim-step
 *      COUNTERS that hold no commands at all. dq_tick walks the priority ladder
 *      and ships at most one command per tick per slave, applying that class's
 *      own gateway depth — so background work can neither displace a user
 *      command's storage nor sit more than 2 slots deep in front of one;
 *   2. a PAYLOAD ADAPTER: pack a DALI command into the client's 4 opaque command
 *      bytes ([addr, data, flags, dtr0]) and map the client's terminal outcome +
 *      response8 back to a dq_result_t for the producer's callback.
 *
 * There is NO id ledger and NO reboot resync/rebuild/rollback here — the client
 * handles gateway-reboot recovery through the queue-protocol §4 rules,
 * resubmitting idempotent commands and reporting the rest DQ_RES_DROPPED.
 *
 * FAIRNESS is this layer's job, not the protocol's (spec §5). Slaves with work
 * pending are served ROUND-ROBIN from a rotating cursor, so with per-slave
 * single-outstanding transactions any slave's wait is bounded by one
 * transaction time per competing slave. This is what replaced spinning as the
 * anti-starvation mechanism when the client started pacing its polls.
 */

#include "dali_queue.h"
#include "dali_pending.h"
#include "mbq_client.h"
#include "modbus.h"
#include "config.h"
#include "dali_provision.h"
#include "log.h"
#include "pico/time.h"
#include <string.h>
#include "cdc_out.h"
#include "core1.h"   /* wd_feed */

/* ── Scheduler shape ────────────────────────────────────────────────────────
 * There is no single FIFO backlog any more. Two reasons, both measured:
 *
 * 1. A shared pool lets background work occupy the storage a button press needs
 *    — the old 16-deep backlog reported backlog_full=2 in normal operation, and
 *    every one of those is a silently dropped command. Storage is now
 *    PARTITIONED BY CLASS, so a burst of background work can neither displace a
 *    user command nor sit in front of one. The user class is sized to one
 *    button's full fan-out (MAX_TARGETS_PER_BTN), so a press always fits.
 *
 * 2. Latency comes from commands already at the GATEWAY, which executes strictly
 *    FIFO with no priority — so a queued background command delays a button by a
 *    whole DALI frame. Hence a per-class DEPTH: background may occupy only ONE
 *    of the gateway's command slots, bounding that inversion to one frame time,
 *    while user work may fill the queue. The task-07 soak measured the trade at
 *    the older 8-slot depth (depth 2 = 82 % of peak throughput, depth 4 = 96 %,
 *    each extra slot ~25 ms of inversion); at the v4 depth of 2 the ladder's
 *    only remaining lever is keeping background out of the second slot.
 *    Background work is not latency-sensitive; buttons are.
 *
 * Dim steps are not stored as commands at all — see the delta counters below. */
#define DQ_CLASS_MAX     8u   /* per-class ring capacity (max over the classes) */

/* Each class's GATEWAY DEPTH is the SCHEDULER's own ordering policy, not the
 * protocol's flow control — that is A_FULL (spec §5, decided 2026-08-12): the
 * client has no in-flight cap of its own, and submits until the gateway
 * refuses. What depth actually bounds is s->outstanding: commands this
 * scheduler has SHIPPED to the client and not yet had resolved, i.e. how much
 * of a class's commitment is allowed to sit ahead of the priority ladder
 * (see DQ_PIPELINE_MAX below). Note v2 needed every class strictly BELOW the
 * depth, because a submit carried its own status read-back and so needed a
 * slot it already knew was free. A v4 enqueue is its own frame and needs no
 * free slot in advance, so a class may fill the queue completely — that
 * retired constraint is what buys the one-transaction-per-DALI-frame steady
 * state. */
/* How much of the PIPELINE the scheduler keeps filled — client staging plus
 * whatever the gateway holds, which is what s->outstanding counts.
 *
 * CMDQ_DEPTH at the gateway plus ONE staged is the whole of it. Going deeper
 * does not buy throughput (the gateway is the bottleneck, and it says A_FULL)
 * and it costs latency: work staged in the client has left the priority
 * ladder behind, so anything queued past the gateway's depth is a DALI frame
 * a button press may have to wait out. */
#define DQ_PIPELINE_MAX  (CMDQ_DEPTH + 1u)

/* Pipeline share per class. The ladder's job is priority, not flow control.
 * What matters is that BACKGROUND may never take the staging slot: capped at
 * CMDQ_DEPTH it can fill the gateway but never the slot in front of it, so a
 * button press arriving now is staged next and waits only for the DALI frame
 * already executing. That bound is the whole point of the ladder. */
#define DQ_DEPTH_USER    DQ_PIPELINE_MAX          /* user work may fill the queue */
#define DQ_DEPTH_CFG     DQ_PIPELINE_MAX
#define DQ_DEPTH_READ    DQ_PIPELINE_MAX          /* verification reads: an outcome to HA */
/* ONE, and the file's own design note above says why: the gateway executes
 * strictly FIFO with no priority, so every background command already sitting
 * there delays a button press by a whole DALI frame. At depth 2 background can
 * hold BOTH gateway slots and a press waits ~76 ms behind them; at 1 the
 * inversion is bounded to the single frame already executing.
 *
 * This was CMDQ_DEPTH, which contradicted that note — the comment said "only
 * ONE of the gateway's command slots" while the constant allowed both.
 * Background throughput drops to ~0.6x (one idle DALI frame per collect round
 * trip), which is irrelevant to a 10 s-cadence backstop sweep and costs a few
 * seconds on the boot scan. Buttons are latency-sensitive; sweeps are not. */
#define DQ_DEPTH_BG      1u

/* ...EXCEPT while a scan is armed for that slave (dq_set_bg_burst, task 10).
 *
 * Depth 1 also serialises background work to one command per round trip: the
 * gateway's DALI engine finishes a frame and then sits idle while the result is
 * collected and the next command enqueued. That idle is most of what made a
 * full scan hold 66 % of the RS-485 bus for 3.4 s — the producer windows above
 * cannot ship their second query while a background command is outstanding.
 *
 * A scan is armed at boot, by `scan`, and after provisioning: seconds at a
 * time, not the steady state. For that window background may hold BOTH gateway
 * slots, so a button press can again wait ~76 ms behind two frames (dd83279
 * measured the depth-1 bound as a 241->189 ms median improvement under
 * SATURATING load). Bruce's call, 2026-08-15: a few seconds of scan is worth
 * it; the steady-state sweep stays at 1, where dd83279's bound is what
 * matters. */
#define DQ_DEPTH_BG_BURST 2u

/* The pending desired-state table (task 14 — HA/web/CLI on/off/level, see
 * dali_pending.h) drains at CMDQ_DEPTH: it may keep the gateway full but, like
 * background, never takes the staging slot in front of it. A wall press arriving
 * mid-drain is therefore staged next and waits only for the frames already at
 * the gateway — buttons always win. A Siri "all off" is ~40 frames on the
 * busier gateway, ~1.5 s of DALI, and none of it may sit ahead of a press. */
#define DQ_DEPTH_PENDING  CMDQ_DEPTH
_Static_assert(DQ_DEPTH_PENDING < DQ_PIPELINE_MAX,
               "the pending table must not take the staging slot");
_Static_assert(DQ_DEPTH_USER <= DQ_PIPELINE_MAX && DQ_DEPTH_CFG <= DQ_PIPELINE_MAX &&
               DQ_DEPTH_READ <= DQ_PIPELINE_MAX && DQ_DEPTH_BG < DQ_PIPELINE_MAX &&
               DQ_DEPTH_BG_BURST < DQ_PIPELINE_MAX,
               "no class may exceed the pipeline, and background must not take the staging slot");

/* Pending dim steps, per ballast and per group, instead of queued UP/DOWN
 * frames (user decision, 2026-07-28). A held button emits dim repeats faster
 * than DALI can issue them, so queueing each one builds a backlog that keeps
 * dimming after release — the exact latency problem this task removes. A signed
 * counter collapses that: the scheduler issues ONE step per submit opportunity
 * and decrements ON SUBMIT.
 *
 * Decrementing on submit (not on completion) is deliberate: a step lost to a
 * gateway reboot simply doesn't happen, which is invisible in a dim ramp, and
 * it can never be replayed into a double-step. That is also why these frames go
 * out non-idempotent. The clamp drops excess by design — the ballast's own fade
 * rate and min/max clamping still govern the result, which is why this issues
 * real UP/DOWN rather than computing a level from cache. */
#define DQ_DELTA_MAX     4

/* DALI response8 failure codes on a FAILED slot — the payload contract mirrored
 * from the gateway (TinyModbus dali_sync.h). A COMPLETE slot's response8 is the
 * backward-frame answer byte instead. */
/* 0x01 was DALI_RESP_NAK, retired 2026-08-13 — "a query got silence" is the
 * status MBQ_R_NAK now, not a failure payload. Reserved, not reused. */
#define DALI_RESP_COLLISION  0x02u  /* garbled backward frame (≥1 gear answered) */
#define DALI_RESP_BUSFAULT   0x03u  /* transport-level fault (short pulse etc.) */

typedef struct {
    uint8_t  addr, data, flags, dtr0;
    uint8_t  prio;           /* dq_prio_t — kept for the debug dump */
    bool     idempotent;
    dq_result_cb_t cb;
    void    *ctx;
} dq_cmd_t;
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
