brucejcooper/switch_gateway_firmware/(commit log)

2025-11-17 Now we use LUA, and don't use FreeRTOS, because pico-vfs and FreeRTOS appear to be incompatible
2026-01-23 Copeid values off old device
2026-03-13 Multi-button scripting
2026-05-16 Remove unused FreeRTOS-Kernel dependency
    The firmware doesn't use FreeRTOS, so drop the submodule and its
    CMake import helper. pico-sdk (2.2.0) and pico-vfs are already at
    their latest upstream revisions.
2026-06-05 Controller bring-up tooling + 38400 default baud
    - dali_raw <slave> <cmd16> [twice]: send a raw 16-bit DALI forward frame
    through the gateway RAW_CMD register, with Modbus-level ack/exception.
    - gw_reboot <slave>: software-reset a TinyModbus gateway (writes the
    MBREG_SYSTEM_RESET magic) to recover a wedged bus.
    - Decode Modbus exception codes in CLI error output and the rx-exception
    warning (modbus_exception_str) — e.g. "exception 0x06 (device busy)".
    - dirty_poll: log the *reason* before each holding-register read at INFO,
    and demote the per-action Modbus function/response chatter to DEBUG.
    - Default and boot-discovery (probe) baud -> 38400, now that the TinyModbus
    RX-starvation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
2026-06-05 Controller: end-to-end test harness, Saleae tooling, working notes
    - test/run_tests.py: build/flash the controller, wait for boot discovery,
    capture all controller logs, and run DALI presence tests over the CLI.
    - test/saleae_capture.py: Saleae Logic 2 automation wrapper — captures the
    DALI/RS-485 lines, decodes RS-485 as Modbus, summarises line activity;
    handles the capture arming-latency and uses timed (auto-stopping) captures.
    - test/dali_tx_probe.py: wire-level "does the gateway drive DALI TX?" probe.
    - test/gw_watch.py: watch a gateway for receive-path wedges.
    - CLAUDE.md: build/flash for both firmwares, serial port, rig wiring, the
    root-cause writeup, and gateway recovery not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
2026-06-06 Revert canonical bus baud to 19200 (38400 marginal for ATtiny RX sampling)
    DEFAULT_BAUD_RATE and the discovery BAUD_FAST go back to 19200. At 38400 the
    TinyModbus ATtiny mis-frames otherwise-clean Modbus frames under DALI load
    (its internal-RC oscillator is marginal for 38400 RX sampling) — confirmed
    byte-for-byte on the Saleae and by the gateway's new RX error counters going
    to zero at 19200. The earlier RX interrupt-starvation bug was a separate,
    already-fixed fault; 38400 was never actually reliable on this hardware.
2026-06-06 DALI collision tooling: dali_raw result-readback, read_mem, identify, re-provision
    - dali_raw now always polls FC04 0x0108 and reports the DALI outcome
    (ok 0x00FF / nak / err malformed...).
    - read_mem <slave> <addr> <bank> <off> <n>: read a ballast's memory bank via
    raw SET DTR1/DTR0 + READ MEMORY LOCATION (re-sets DTR0 per byte to tolerate
    unreadable holes like bank-0 offset 0x01); prints hex.
    - identify <slave> <addr>: GTIN (bank 0, 0x03, 6B) + serial (0x0B, 8B) as hex;
    a garbled serial read => "collision" (serial is unique per device, so two
    gear sharing an address is always detectable).
    - provision <slave> <addr> now works: writes 0x03YY to drive the gateway's new
    re-provisio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
2026-06-06 Add dali_inventory.py: scan a slave's ballasts, print GTIN/serial, flag collisions
2026-06-06 Add dali_xlsx_sync.py: sync device serials with Switch wiring.xlsx
    The DALI serial number (memory bank 0) is a stable per-device id; short
    addresses change on (re-)provisioning. Two modes on the Lights sheet:
    populate (record each device's GTIN+serial into its Device/Address row) and
    remap (after re-provisioning, scan serial->address and rewrite each row's
    Address by matching its recorded serial). Backs up the file first.
2026-06-06 Fix button-driven DALI toggle going stale after the first press
    A button toggle reads state_cache_any_on, but only the CLI path called
    dirty_poll_mark_active to refresh the cache — button presses left it stale, so
    every press read the same on-state and did nothing after the first.
    Every lighting DALI action now records a synchronous on/off intent
    (commanded_on) that the toggle reads, and marks the slave active so dirty-poll
    confirms the exact level. dirty-poll re-syncs commanded_on only from a stable
    read after a 0.7s settle window, so a stale/mid-fade read can't clobber an
    in-flight rapid toggle, while external changes are still picked up once tapping
    stops. Verified: clean alternation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
2026-06-06 Add btn synth-press CLI + toggle debug log (button testing)
    `btn <fixture> <button> [tap|press|release]` injects a synthetic button event
    into the FSM queue (button_fsm_inject) so the button path can be exercised
    without hardware. do_toggle logs the cached on/off it toggled from.
2026-06-06 Expose DALI per-ballast config to HA + get/set commands
    Home Assistant needs min/max/power-on/sys-fail/fade. The controller already
    fetched these (full scan reads gateway BLOCK1-3) but never exposed them.
    - state_dali emit now carries min/max/power_on/sys_fail/fade_rate/fade_time.
    - set_dali_config <slave> <addr> <field> <value> (CLI) and
    {"t":"set_dali_config",...} (JSON, any subset of fields) write the gateway
    BLOCK1/2/3 register pairs, arming the DALI STORE-DTR-AS sequence; read-
    modify-write preserves the pair's other field, with a predictive cache
    update + re-emit. {"t":"get_dali_config",...} re-emits a ballast's state.
    - Flip the BLOCK1 read order to (min<<8)|max to match th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
2026-06-07 Unify settings protocol: {t,d,v} envelope for set/get/report (JSON + CLI)
    The HA bridge needs one consistent notation. Replace the flat, asymmetric
    commands with a single {t, d, v} envelope per domain — d addresses the entity,
    v is a field bag — used identically for set, get, and the report, so the client
    sets values in the same shape it receives them.
    - JSON: set_dali/get_dali (state on/bri + config min/max/power_on/sys_fail/
    fade_rate/fade_time), set_relay/get_relay, set_group/get_group,
    set_cfg/get_cfg, get_mapping. Reports keep their names (state_dali/state_relay/
    state_group/config_mapping; new state_cfg). ack is the receipt, state_* the
    value confirmation. Fields parse by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
2026-06-07 Fold controller device config into the cfg domain; FW_VERSION from git
    cfg now carries the whole controller device config so Home Assistant shows it
    like everything else: state_cfg / hello report fw_version (read-only), baud,
    relay_slaves, dali_slaves, and the timing values. set_cfg / `cfg key=val`
    set the writable ones — timing, baud (reboot to apply), and the slave lists
    (JSON arrays; CLI comma form). set_baud folded into set_cfg's baud key.
    FW_VERSION is now built from git (`<base>+<git describe --tags --always
    --dirty>`) via cmake/gen_version.cmake → build/generated/version.h, regenerated
    each build and only rewritten when the string changes (no spurious recompiles).
    Verified on ha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
2026-06-07 Finish bindings in the unified scheme: CLI map + grid dims + get_mappings
    JSON bindings were already consistent (get/set/del_mapping → config_mapping);
    this finishes the rest:
    - CLI `map` joins the unified pattern: `map <fix> <btn> [targets=<s>:<a>,...]`,
    bare = get (emits config_mapping), `targets=` (empty) deletes. Targets take
    N (ballast) or gN (group). Replaces the old `map set/del` subcommands.
    - Renamed JSON get_config -> get_mappings (dump all) — clearer now that cfg is
    the device config.
    - state_cfg reports read-only max_fixtures/max_buttons/max_targets so HA knows
    the binding grid.
    Verified on hardware: CLI map get/set/delete (ballast + group targets), JSON
    set/get/get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
2026-06-07 Persist mappings as versioned JSON instead of a raw struct dump
    The old /mappings.bin was a versionless raw fwrite() of mapping_record_t, read
    back with a bare fread() of sizeof(struct). That couples the on-disk format to
    the in-memory layout with no safety net: any struct change (or a whole-table
    overwrite while the table is momentarily empty) silently drops every binding.
    That's why bindings vanished across a firmware change while /config.json (text
    JSON) survived — the partition was never wiped.
    Switch to line-delimited JSON in /mappings.json: a
    {"format":"mappings","version":1} header then one
    {"fixture":F,"button":B,"targets":[...]} object per binding, with explicit
    serialise/parse.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
2026-06-07 mqtt bridge: update to new protocol + per-instance identity + .env config
    - Protocol: the bridge sent cmd_relay/cmd_dali/set_config, all removed this
    session. Switch to set_relay/set_dali/set_cfg in the {t,d,v} envelope (bri/on
    in v, not d). Inbound state parsing was already compatible (extra config
    fields ignored).
    - Co-existence: HA unique_ids and device identifiers hardcoded "lighting", so a
    second bridge would collide in HA. Parameterize them by NODE (= --prefix), and
    add --node-name (LABEL) to prefix human device names. Default lighting/"" keeps
    the main system byte-for-byte unchanged; a test rig runs with --prefix testrig
    to get fully independent topics + entities + devic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
2026-06-07 mqtt bridge: expose groups, DALI config, device config, and fixture bindings
    Surface all the features added this session as HA entities:
    - DALI groups: a light entity (on/bri) per non-empty group + an editable
    "members" text entity, on a per-group device. state_group → state + members;
    group/<s>/<g>/set → set_group; .../members/set → set_group members.
    - Per-ballast config: min/max/power_on/sys_fail/fade_rate/fade_time as number
    entities (config category) on each present ballast; values come from the
    extended state_dali, set via dali/<s>/<a>/config/<field>/set → set_dali.
    - Controller device: a "Controller" device with timing number entities
    (long_press/dim_repeat/reversal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
2026-06-07 mqtt bridge: brightness slider fix + per-gateway availability
    - Brightness: switch ballast/group lights from the legacy `brightness: true`
    flag (no longer renders a slider in recent HA) to supported_color_modes:
    ["brightness"], reporting color_mode in the ON state. Verified the broker
    carries {"state":"ON","color_mode":"brightness","brightness":N}.
    - Per-gateway availability: handle state_gateway → gateway/<slave>/availability
    (seeded online on hello). Ballast lights, ballast-config numbers, group light +
    members, and provisioning entities now gate on [system, gateway, (per-ballast)]
    with availability_mode "all", so a down gateway marks them unavailable. Verified
    end-to-end: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
2026-06-07 bridge: drop prefix/node_name config — one lighting system per broker
    Each broker now hosts exactly one lighting system (dev broker = test rig, prod
    broker = main rig), so the per-instance MQTT_PREFIX / NODE_NAME machinery is
    unnecessary. Removed the --prefix/--node-name flags and their env vars; NODE is a
    fixed "lighting" constant for HA unique_ids/topics and LABEL stays empty (clean
    device names). Defaults now target a local anonymous broker (localhost, no creds).
2026-06-07 bridge: publish all 16 DALI groups per gateway (always present)
    The controller only reports a group once it has members, so empty groups never
    appeared in HA — you couldn't add lights to one. DALI groups are a fixed 0-15 set
    per gateway, so on hello the bridge now publishes all 16 group devices per DALI
    slave, seeded empty/off, gated on the gateway availability ([system, gateway],
    mode all). The controller's state_group fills in the populated ones; an empty
    group now has a real members text entity the mapper can write to populate it.
    Verified: 32 group devices (16 × 2 slaves) discovered in HA.
2026-06-07 modbus: retry RAW_CMD on DEVICE_BUSY so multi-target buttons fire all targets
    A gateway mid-DALI-frame answers a new RAW_CMD with a DEVICE_BUSY (0x06)
    exception. The modbus layer treated any exception as a final answer and never
    retried, so a button bound to several ballasts on one gateway only actuated the
    first — the rest raced into the busy window and were silently dropped.
    Now DEVICE_BUSY is retried: wait ~one average DALI forward-frame (10 ms) and poll
    again, up to DALI_BUSY_RETRIES (6) times, which transparently serialises rapid
    same-gateway commands. Other exceptions are still delivered as failures.
    Verified on the rig: a button bound to 2:0,2:1 toggles both ballasts on/off.
    Co-A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
2026-06-07 serial: emit get_mappings incrementally so the whole table reaches HA
    serial_tx_config_full() serialised every binding into one 4 KB buffer via
    mapping_serialise_all(), which returns -1 (and prints nothing) the moment the
    output would overflow. A full house config (~95 bindings ≈ 8 KB) tripped this, so
    get_mappings answered empty. HA calls get_mappings on every reconnect, clears its
    binding text entities first, then had nothing to refill them — so the bindings
    "vanished" from Home Assistant after every flash/reconnect even though the
    controller's /mappings.json and in-RAM table were intact and the buttons worked.
    Now each populated binding is emitted as its own config_mapping line with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
2026-06-07 docs: state-sync review — intermittent HA updates root-caused
2026-06-07 docs: record B outcome — fixes intermittency for fading ballasts
2026-06-07 state sync: backstop dirty-poll + drop the optimistic level guess
    A (backstop, dirty_poll): the poller deactivated after 2 zero reads (~200ms), so
    on/fade/multi-target dirty bits landing later were missed and took the 60s
    background check to self-heal. Now a slave stays active for a 2s window after the
    last command/change (time-based, not a zero count), and a regular 1s dirty-mask
    sweep runs while idle so external/manual/post-fade changes reflect within ~1s. A
    non-zero sweep re-activates fast polling. Measured: fade=0 multi-target ON 2/8 -> 12/12.
    C (no guess, serial): set_dali "on" no longer assumes a brightness (it used to emit
    max_level/254). GOTO_LAST_ACTIVE restores a level the control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
2026-06-07 docs: correct D — GOTO_LAST_ACTIVE is intended; polling is the fix
2026-06-07 dirty_poll: drop invalid 0xFF level reads; add DALI wire-decode proof tool
    Belt-and-braces behind the gateway fix: if a brightness read ever comes back 0xFF
    (not a valid DALI level — max is 254), drop it and keep the last good value rather
    than reporting 100%.
    test/dali_wire_proof.py captures D0/D1 with the Saleae and Manchester-decodes the
    DALI forward+backward frames (self-validating against the known forward opcodes) so
    "what the ballast actually returned" is provable from the wire, not inferred.
2026-06-07 docs: record wire-proven 255 root cause + fix
2026-06-08 tools/xlsx_to_ha.py: migrate Switch wiring.xlsx into Home Assistant
    Reads the Lights + Switch Positions sheets and produces (then applies) a plan:
    - rename each DALI light device by (Device, Address) -> Light name; place at Map X/Y
    - rename each fixture (patch location L -> lighting_switch_plate_LL), set its
    button_order = the wiring string (order[position] = controller pin), place at
    Map X/Y; a patch location shared by two fixtures becomes one HA fixture with a
    split order "A+B" and a second (ext) marker placed from the 2nd fixture's Map X/Y
    - bindings: a light's (Fix Name, position Btn) -> pin = order[Btn] -> that fixture
    pin's binding text entity gets the light's target
    Bt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
2026-06-08 relay availability: gate on relay-board reachability like DALI gateways
    Relays showed as available whenever the Pico was connected, even with the relay
    board absent — because the controller never polled the board for reachability and
    the bridge gated relay switches on the system topic only (DALI ballasts additionally
    gate on their gateway's state_gateway topic, which is why slave 3 went unavailable).
    Controller (dirty_poll.c): poll each relay slave's coils every 2s and emit
    state_gateway online/offline on a debounced transition, identical to the DALI
    gateway path (reuses GATEWAY_FAIL_THRESHOLD). Modbus already queues requests so this
    doesn't collide with the DALI polls.
    Bridge: store rel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
2026-06-08 Update Switch wiring.xlsx
2026-06-08 build: target WIZnet W5100S-EVB-Pico (RP2040), add net + JSON libs
    First commit of the core1-mqtt work (moving the Python MQTT bridge on-board
    onto core 1 over the W5100S). Build-system only; no behaviour change yet.
    - Switch PICO_BOARD to wiznet_w5100s_evb_pico: pins PICO_PLATFORM=rp2040,
    the W5100S SPI0 pins, 2 MB flash + W25Q080 stage2. (Was bare Pico 2/rp2350.)
    - Add submodules lib/ioLibrary_Driver (W5100S socket/DHCP/DNS) and lib/coreMQTT
    (pinned v2.3.1, static / malloc-free / float-free). Vendor lib/jsmn/jsmn.h.
    - Link pico_multicore; add the jsmn include dir. Libraries are in-tree but not
    yet compiled — wired into the build by the later net commits.
    - button_actions.c: replac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
2026-06-08 core1: launch the second core + heartbeat-gated watchdog
    Bring up core 1 as a stub network bridge and make the single hardware
    watchdog tolerant of a network outage while still catching a real core-1 wedge.
    - core1.c/.h: multicore_launch_core1_with_stack() with an explicit static
    8 KB stack. core1_entry() calls flash_safe_execute_core_init() first
    (registers core 1 as the flash lockout victim — the one app-side action
    needed for multicore flash safety; pico-vfs already wraps the writes),
    then loops beating a heartbeat and draining/discarding the event queue
    (the net stack replaces the discard later). core1_launch() blocks
    (bounded 1 s) until that init is done, so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
2026-06-08 intercore: carry provisioning msg verbatim to core 1
    Revert a premature optimisation. The previous commit dropped the gateway's
    free-form provisioning status message from the event struct (to keep the
    element ~32 B) and planned to synthesise it on core 1 from the state enum.
    That loses real detail HA shows in its "Commission Status" sensor — error
    specifics, per-step progress, prose counts — and adds a synthesiser core 1
    would not otherwise need.
    RAM is plentiful (264 KB), so carry the 80-byte msg verbatim, faithfully
    reproducing the Python bridge. The event queue is ~50 KB of heap now; fine.
2026-06-08 net: W5100S bring-up, DHCP, PHY link and chip recovery (core 1)
    Get the board onto the network. This is the netif half of the original
    "commit 4"; the TCP socket state machine + DNS move to the coreMQTT commit,
    where the connection manager that drives them lives.
    - net/wizchip_glue.c: SPI0 + CS/RST/INT glue and the ioLibrary callbacks.
    The cris callback disables interrupts around each W5100S access so a
    register/burst transfer can't be interrupted mid-transaction by core 1's
    flash-lockout (SIO) IRQ — which would park core 1 with CS asserted while
    core 0 writes flash. Each access is microseconds, so it only briefly
    defers a flash write, never blocks it.
    - net/netif.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
2026-06-08 net: coreMQTT connection manager + non-blocking TCP socket SM + LWT
    Stand up the broker connection on core 1 and make it self-healing. Treats the
    connection as disposable: any fault tears down to a known state and rebuilds.
    - net/mqtt_app.c: a 5-state connection manager (OFFLINE -> TCP_CONNECTING ->
    MQTT_CONNECTING -> ONLINE -> BACKOFF) over a single non-blocking W5100S
    socket. Implements the socket-level reliability requirements:
    #1 SF_IO_NONBLOCK + getSn_SR() state machine; every op has a wall-clock
    timeout (TCP connect 5 s) so connect() can't wedge the loop.
    #2 explicit SOCK_CLOSE_WAIT -> disconnect()+close() recycle.
    #3 act on Sn_IR (CON / DISCON / T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
2026-06-08 net: Home Assistant MQTT discovery (incremental) + availability
    Port mqtt_bridge.py's auto-discovery to core 1. On each MQTT (re)connect the
    full retained entity set is (re)published so HA repopulates from scratch.
    Published INCREMENTALLY — one entity per disc_step(), a bounded batch per tick,
    gated on free socket-TX space (TX_HEADROOM). Blasting ~600 retained configs at
    once would overrun the 2 KB socket TX buffer and freeze the core-1 heartbeat;
    the tx-free check means a ~650 B publish never meets a full buffer, so it flows
    at network speed and never blocks. Payloads are built one at a time into a
    single reused 1.5 KB buffer (no full-set-in-RAM).
    Entities (shapes mirror mqtt_bridge.py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
2026-06-08 net: event->state + command translation + resync (HA functional)
    Complete the mqtt_bridge.py port. The board now publishes live state to HA and
    acts on HA commands directly — no Python bridge in the path.
    Outbound (ic_event_t -> retained MQTT state), mirroring the bridge:
    relay/dali(state+config)/group(state+members)/gateway-availability/button/
    mapping(+binding)/provision-status(with verbatim msg + state-enum->string)/
    config-state. Per-ballast and controller config-number entities moved into
    the incremental discovery cursor (TX-safe) rather than lazy bursts.
    scan_complete's 64-address availability sweep is its own incremental cursor:
    popping a scan_complete starts a sweep tha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
2026-06-08 config: unify config.json (baud/DE + mqtt + net), wire broker into core 1
    Consolidate the four persisted files to two. config.json now also holds the
    modbus baud + DE mode and the MQTT + network settings; mappings.json is
    untouched (kept separate for its tolerant, frequently-rewritten format).
    - config.c: parse with jsmn (malloc/float-free; JSMN_STATIC so config.c and
    ha_bridge.c each get a private copy). Flat keys (mqtt_host, net_ip, ...) for
    simple, robust, human-editable JSON. One-time migration imports
    /modbus_baud.txt + /modbus_config.txt then deletes them.
    - modbus.c: read baud + DE mode from g_config (set by config_load before
    modbus_init); modbus_set_baud / set_m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
2026-06-08 serial: strip JSON from USB (text CLI only); README on-board topology
    USB CDC is now a human text CLI only — all JSON emit/parse is gone. JSON lives
    solely at core 1's MQTT edge. The state emitters still feed core 1 (typed
    structs); they just no longer print JSON to USB.
    - emit_state_dali/relay/group/cfg, emit_config_mapping, serial_provision_poll:
    converted from "printf JSON + push struct" to push-only.
    - removed emit_event (the levt->JSON formatter); serial_poll forwards events
    via levt_to_ic only.
    - removed handle_json_line (inbound JSON command parser) — handle_line ignores
    any stray '{' line; the text CLI is the only USB command surface.
    - removed serial_tx_ack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
2026-06-09 net: W5100S SPI at 10 MHz + longer reset — fixes hardware bring-up
    First on-hardware test: getVER() read 0x00 (SPI desync) at the initial 30 MHz
    SPI clock. Dropping to 10 MHz and lengthening the reset (RSTn low 10 ms, 150 ms
    PLL-settle before the first access) brings the chip up cleanly — VER=0x51, PHY
    link up, DHCP lease acquired. 10 MHz is ample for MQTT and conservative for the
    board's signal integrity.
    Also adds a write/read-back diagnostic in the VER-mismatch path (re-read VER +
    RTR write/read) to distinguish a dead SPI link from an anomalous read on any
    future failure.
    Validated on a WIZnet W5100S-EVB-Pico: "net: DHCP lease ip=192.168.1.234" /
    "core1: alive: link=1 ready=1".
    Co-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
2026-06-09 core1: register flash victim before fs_init (fix persistence on fresh board)
    On-hardware: config/mappings wouldn't persist on a fresh board. Root cause —
    fs_init() ran in main() BEFORE core1_launch(), so the first-boot littlefs
    format (a flash write via pico-vfs) happened before core 1 had registered as
    the flash lockout victim. flash_safe_execute() then returns NOT_PERMITTED (no
    lockout helper; PICO_FLASH_ASSUME_CORE1_SAFE defaults to 0), the format fails,
    and the filesystem never mounts — so every fopen() fails. (The old single-core
    board only ever *mounted* an already-formatted fs, so it never hit this.)
    Fix: launch core 1 first (it calls flash_safe_execute_core_init), THEN fs_init()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
2026-06-09 net: work around ioLibrary non-block recv() bug (fixes MQTT receive)
    On-hardware: MQTT connected (CONNECT accepted by the broker) but the Pico never
    received the CONNACK — MQTT_Connect failed with MQTTNoDataAvailable while the
    diagnostic showed sr=ESTABLISHED, rx_rsr=4 (the 4-byte CONNACK sat unread).
    Root cause is a bug in the vendored ioLibrary_Driver socket.c recv(): on the
    non-IPv6 path the SF_IO_NONBLOCK check returns SOCK_BUSY *before* the
    "if (recvsize != 0) break;" check, so a non-block socket's recv() never delivers
    received data (the IPv6 path has the checks in the correct order).
    Work around it in our transport_recv without patching the vendored lib: read
    Sn_RX_RSR robustly (t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
2026-06-09 net: coalesce MQTT publishes into one TCP segment via transport writev
    coreMQTT serialises each packet as several iovec fragments (fixed header,
    topic-len, topic, [packet-id], payload). With only a scalar `send` in the
    TransportInterface, sendMessageVector() called send() once per fragment,
    and each ioLibrary send() issues a W5100S SEND immediately (no Nagle) —
    so one PUBLISH left the wire as 3-4 tiny back-to-back TCP segments.
    Implement the optional `writev` callback: gather all fragments into one
    scratch buffer (MQTT_NET_BUF_SIZE; we have ample RAM) and send once.
    Partial gather/send is handled — return the accepted count and coreMQTT
    re-calls for the remainder — so large payloads a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
2026-06-09 cleanup: retire the Python bridge, sweep transition cruft, refresh docs
    The MQTT bridge now runs on-board on core 1, so the external Python host
    and its leftovers are gone. Also enable CLI echo by default and bring the
    docs in line with the actual firmware.
    Removed:
    - bridge/ — mqtt_bridge.py + env/requirements (replaced by core 1; the
    rotating controller.log* and .env secrets went with the directory).
    - docs/{core1-mqtt-plan,issue-raw-cmd-async,state-sync-review}.md — design
    notes for completed work; git history preserves them.
    - src/bindings.txt, src/lights.png — unreferenced scratch data committed
    into src/.
    - mapping_serialise_all() — dead since get_mappings switched to in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
2026-06-09 relay/gateway availability: replay reachability on resync
    Relays (and DALI gateways) showed available even when the board was
    absent. The controller does emit gateway online/offline (dirty_poll relay
    health poll + gateway_report), but reachability is a ONE-SHOT transition:
    online→offline fires once, early in boot. On every MQTT (re)connect core 1's
    discovery re-seeds every gateway-availability topic "online"
    (seed_gateway_avail), and lighting_resync_emit replayed relay/DALI/group
    state but NOT gateway reachability — so the seed's "online" was never
    corrected. Relays have no per-channel presence to fall back on (unlike DALI
    ballasts, whose per-address availability resync DOES replay via
    s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
2026-06-09 feat: embedded config web UI on core 1 (W5100S)
    A LAN-only fallback for commissioning a device before/instead of Home
    Assistant, running alongside the MQTT client on the W5100S.
    Firmware (core 1):
    - src/net/http_server.c: non-blocking HTTP/1.1 server on sockets 2-3
    (+ opportunistic DHCP socket 0). Basic auth (creds from config snapshot),
    gzipped static asset serving from flash, GET /api/state, and full-parity
    POST /api/{relay,dali,group,cfg,net,mqtt,auth,mapping,provision}. One
    request per connection, bounded one-chunk-per-tick I/O, no hot-path logging.
    - src/net/web_state.c: core-1 read model fed from the same event drain the
    MQTT bridge consumes (so the UI stays live even when M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
2026-06-09 fix(ha): button events never fired in HA — drop event value_template
    The MQTT button-event discovery (disc_plate_event) set
    "value_template":"{{ value_json.event_type }}"
    HA's MQTT *event* platform applies value_template first and then requires the
    RESULT to be a JSON object containing event_type. The template renders the bare
    string "press", which isn't JSON, so HA logged "No valid JSON event payload
    detected" and the event entity never fired (stuck at 'unknown').
    The publish already sends {"event_type":"press"} — exactly what the event
    platform parses by default — so the template is both wrong and unnecessary.
    Removing it makes HA take event_type from the raw payload. Verified on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
2026-06-09 feat(buttons): split into press/release/click/long_press events
    The button event taxonomy was mislabeled and asymmetric: a short tap emitted
    "press" (on release — so a click was reported as a press), "release" only fired
    after a hold, and there was no physical button-down event at all.
    New model — physical press/release frame every interaction, with the gestures
    overlaid:
    - press physical button down (every interaction)
    - release physical button up (every interaction)
    - click completed short tap (down->up before long-press)
    - long_press hold threshold crossed (was long_press_start)
    - long_press_repeat repeats while held
    So a tap emits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
2026-06-09 fix(buttons): log every emitted event to the CLI
    The CLI only logged the button-down "press" and the hold-path events, so a tap
    appeared to produce a single "press" with nothing else — the click/release were
    emitted to HA but never written to the serial log. Move logging into the single
    emit choke-point (emit_button_event) so the CLI mirrors exactly what reaches HA:
    press, click, release, long_press at INFO; long_press_repeat at DEBUG (it's
    ~5 Hz). The old scattered FSM logs are removed; the held=ms / dim dir detail is
    kept at DEBUG.
2026-06-09 feat(ha): re-assert discovery + state on HA restart (birth message)
    Previously the controller relied solely on retained discovery/state: an HA
    restart was handled only by the broker replaying retained messages, and the
    controller re-published only when its OWN broker session reconnected.
    Now ha_bridge subscribes to homeassistant/status and, on "online" (HA's birth
    message), kicks the same full discovery burst + state resync as a fresh session
    connect. This is the HA-recommended belt-and-suspenders pattern: discovery stays
    retained as the fallback, and HA also gets a proactive, fresh re-assert whenever
    it restarts. Verified: publishing homeassistant/status=online makes the device
    log "HA onl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
2026-06-09 fix(core0/net): watchdog-safe blocking modbus waits + clamp JSON snprintf accumulation
    Two review findings from the cross-repo consistency scan:
    1. A DALI group-membership write to an unresponsive gateway chains up to four
    1.5 s `cli_mb_wait` spins (plus inter-word sleeps) on the core-0 main loop —
    the only watchdog feeder — exceeding the 5 s watchdog and forcing a spurious
    reboot. `cli_mb_wait` now feeds the watchdog each poll iteration, covering
    every blocking CLI/command modbus path. It reuses main.c's core-1-gated
    `wd_feed()` (now exposed via core1.h), so a genuine core-1 wedge still
    reboots — only the slow-gateway false positive is suppressed.
    2. The `n += snpr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
2026-06-11 Restoring Switch wiring
2026-06-13 feat(modbus): log received RS-485 response bytes at debug level
    The TX path dumped the request frame as hex at DEBUG, but the RX path only
    logged the byte count ("rx ok ... bytes=N"). Add a matching hex dump of every
    received frame so request and response can be compared on the wire.
    Refactored the tx hex dump into a shared log_frame_hex("tx"/"rx", ...) helper
    (identical format both directions) and sized it for a full frame — the old tx
    dump capped at 16 bytes; it now shows up to 64 with a "+N" trailer. The rx dump
    runs at the top of the response handler, so it covers normal and exception
    replies; a timeout logs nothing (readbuf_sz == 0).
    This immediately earned its keep: on a bus whose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
2026-06-13 fix(modbus): don't latch our own frame — arm RX only after transmit
    In half-duplex (rs485=tx / DE-WHENTX) the master could receive its own
    outgoing request as the "reply": every transaction logged rx == tx byte-for-
    byte (even to a nonexistent slave), and the real response that arrived a few
    hundred µs later was discarded. On the wire the transceiver was correct — DE/RE
    high during transmit (receiver muted), the genuine reply afterward, no bus echo
    (confirmed on a scope). The fault was timing in the firmware.
    start_action_tx() enabled the RX interrupt *during* transmit. While DE is
    asserted the receiver is muted and its RxD pin floats, so the controller
    capacitively latched its own 8 t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
2026-06-13 fix(modbus): pull up the RX pin — kill the half-duplex self-echo at its source
    Empirically the root cause of the "rx == tx" self-echo: GP5 (UART RX) had no
    pull configured, so while the transceiver tri-states RxD during transmit (RE
    tracks DE in half-duplex) the pin floats and capacitively couples from the
    adjacent GP4 (TX), and the UART latches the controller's own outgoing frame as
    a phantom reply.
    Confirmed on hardware: adding only this pull-up to the OLD (RX-armed-during-TX)
    firmware eliminates the echo — real slave replies come through. Biasing RX to
    the UART idle level (high) means coupling can no longer fake a start bit.
    Kept alongside the deferred RX-arm in release_de() (prev c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
2026-06-13 fix(disc): ping the relay board with a full 32-coil read
    ping_relay() issued FC01 read-coils with count=1 (tx 01 01 00 00 00 01 ...).
    The relay board doesn't answer a single-coil read — it only responds to a
    full-bank read of all 32 coils (tx 01 01 00 00 00 20 ...), the same frame
    dirty_poll/state reads already use. So `ping 1` (and boot discovery of the
    relay) always failed even with the board present and healthy.
    Read all 32 coils instead. Verified on hardware: ping 1 now gets
    rx [01 01 04 00 00 00 00 FB D1] and reports the relay present.
2026-06-13 fix(button): route relay-bound toggles to the relay, not DALI
    do_toggle() dispatched every non-group binding target to the DALI path
    (lighting_set_on_off -> FC06 holding-register write). A binding to a relay
    channel (e.g. 1:22) is a coil, not a ballast, so the relay board never answered
    and the write timed out:
    light: dali 1.22 on
    modbus: rx timeout slave=1 fc=0x06 (gave up)
    light: DALI write failed (0)
    Check slave_kind() like the dim path already does, and send relay targets via
    lighting_set_relay(channel, on) (addr = coil channel). Verified on hardware:
    toggling F10.B1 (bound 1:22) now emits FC05 write-coil 22 and the relay answers.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
2026-06-14 fix(modbus): self-heal a wedged bus SM + stop poll state-leaks on dropped actions
    Hardening for the "controller stops sending commands after a fade burst, needs a
    reboot" failure. Root causes found in review:
    1. The bus SM could wedge permanently in a non-IDLE state with no error and no
    recovery: MODBUS_TRANSMITTING is left ONLY by the release_de alarm (whose
    schedule return was unchecked), and MODBUS_RECEIVING has no overall deadline
    (uart_irq refreshes the inter-byte timeout on every byte, so a dribbling bus
    never times out). Either strands the SM forever -> queue fills -> all commands
    silently dropped.
    2. dirty_poll and the relay-health poll advanced their AWAITING_* / aw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
2026-06-15 fix(errors) P1: surface swallowed faults (bad reads, dropped events/cmds)
    Per the audit policy: detect/handle/log fallible calls; log off the hot path,
    COUNT on it.
    dirty_poll: full_scan BLOCK1-3 and background_check BLOCK0 ignored their
    sync_read_holding() returns, caching uninitialised stack data on a timeout. Now
    track per-chunk success, LOG_WARN a failed chunk, and skip the cache write for
    ballasts in a failed chunk.
    provisioning: serial_provision_poll() cleared its dirty flag *before* an
    unchecked intercore_push_event(), permanently losing the terminal provisioning
    status on a full queue. Now clear only on a successful push (retry otherwise).
    mqtt_app: tcp_open() ignored connect()'s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
2026-06-15 fix(errors) P2: correct log levels
    Per policy (routine → DEBUG, real problem → WARN/ERROR):
    - gateway / relay-board reachability transitions were silent at this layer:
    LOG_WARN on going unreachable, LOG_INFO on recovery (gateway_report /
    relay_health_cb).
    - mqtt_app_publish: the QoS0 publish-fail log was coded LOG_WARN but commented
    "DEBUG"; a publish failing while offline/TX-full is routine → LOG_DBG
    (rate-limit kept as the off-hot-path mitigation).
    - serial_protocol: the per-line "rx: %s" CLI trace is normal traffic, not an
    event → LOG_DBG.
2026-06-16 fix(relay): correct Waveshare 32CH reversed FC01 coil byte order
    The Waveshare Modbus RTU Relay 32CH returns its FC01 (read coils) status
    data field with the byte order reversed (byte0 = relays 25-32), contrary to
    the Modbus spec. Control (FC05) uses the normal address, so writes work but
    read-back lands on the wrong channel.
    Proven on the wire: control coil 16 -> reported coil 8, control coil 17 ->
    reported coil 9 (bytes [B0 B1 B2 B3] sent as [B3 B2 B1 B0]; bits within a
    byte are spec-standard). Waveshare's own wiki documents it as "small-endian,
    low bytes first".
    Effect: the boot relay sync is the only read that hydrates the relay on/off
    cache, so reversed bytes -> wrong cache -> resync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
2026-06-17 fix(log): non-blocking core-safe CDC output ring with drop-on-full
    log_emit() and core-1 net code wrote straight to the USB-CDC via blocking
    printf/vprintf/putchar. When the host FIFO filled (a `log dbg` firehose with
    a slow/absent reader) the calling core stalled past the 5 s watchdog and
    rebooted — and the shared stdout mutex let core-1 block core-0's modbus/
    buttons. This was behind the Jun-16 overnight watchdog reboots.
    - New src/cdc_out.{c,h}: a 4 KB output ring. cdc_out_write() copies a whole
    line in under a brief critical section (safe from either core / ISR) and
    never blocks; if it won't fit the whole line is dropped and a counter bumped
    (never a fragment). cdc_out_drain() (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
2026-06-17 feat(diag): poll DALI gateway sysinfo → HA; quiet core1 heartbeat
    Poll each DALI gateway's FC04 0x0310 sysinfo block (uptime / boot count /
    reset reason) and publish it to Home Assistant as per-gateway diagnostic
    sensors, grouped under the existing gateway device (lighting_dali_gw_<slave>).
    - dirty_poll.c: low-frequency sysinfo read piggybacked on the existing
    per-gateway poll loop (no separate poller); decodes the 4 registers and
    emits IC_EVT_GW_DIAG. Reuses gateway_report() for reachability.
    - New event path: LEVT_GW_DIAG → IC_EVT_GW_DIAG (lighting_actions, intercore,
    serial_protocol levt_to_ic).
    - ha_bridge.c: discovery for Uptime (device_class duration, numeric/graphable),
    R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
2026-06-17 fix(test): detect Linux /dev/ttyACM* ports; add requirements.txt
    The test scripts auto-detected the controller's USB-CDC port with a
    macOS-only glob (/dev/tty.usbmodem*), so on the Raspberry Pi (music.local,
    /dev/ttyACM0) port resolution returned an empty list and threw
    "list index out of range". Extend the glob to also match /dev/ttyACM* in all
    six port-resolution sites (dali_inventory, gw_watch, dali_xlsx_sync,
    dali_tx_probe, dali_wire_proof, run_tests) so --port is no longer needed on
    Linux. CSV globs left untouched.
    Also add test/requirements.txt (pyserial, openpyxl, logic2-automation) —
    there was no manifest for the test tooling deps.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
2026-06-17 fix(dali): retry garbled memory reads before declaring a collision
    identify/read_mem flagged a collision on a single garbled DALI backward
    frame (raw_cmd_result 0x02xx). But a one-off line glitch corrupts a backward
    frame the same way two gear answering at once do, so a transient hiccup
    produced a false "collision" that read clean on the next run (seen on 2:7).
    dali_read_mem now re-reads a garbled byte up to DALI_READ_RETRIES (3) times,
    re-setting DTR0 each attempt, and only sets *collision if it never returns a
    clean byte. A real collision garbles on every read (still flagged); a glitch
    clears on retry. NAK (absent/hole) stays definitive and is not retried.
    Verified on hardware: identify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
2026-07-25 feat: OTA infrastructure + button ground-truth probe + stuck-button protection
    OTA stack (implemented July, hardware bring-up this commit's era):
    - bootloader (verify/commit/rollback + hardened: vector sanity check,
    watchdog-armed factory jump, every stuck path lands in BOOTSEL)
    - PRIMASK fix in jump_to_app — the app is entered reset-faithful now;
    entering with interrupts masked was the relocated-app "hang"
    - staging/backup partitions, ed25519 signing, manifest polling, HA update
    entity, /api/ota endpoints, cfg fw_url manifest-URL override for bench
    Buttons:
    - press-time any-on probe (QUERY LAMP POWER ON) — group toggles use ballast
    ground truth, immune to gateway-reboot mask-ca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
2026-07-25 Task 03 Phase A: config reads via raw DALI queries (dual-path)
    Add a dual-path config-read mechanism behind the runtime flag
    g_config.dali_raw_cfg (default off = existing gateway BLOCK1-3 bank reads,
    no behaviour change on flash). When on, the controller fills the per-ballast
    config cache (min/max/power-on/sys-fail/fade) with its own raw DALI queries
    instead of the gateway banks — the path that lets the gateway retire those
    banks in Phase D.
    - lighting_actions.c/.h: new lowest-priority config-query state machine
    (lighting_cfg_query_*) mirroring the any-on probe's write-then-poll against
    the single raw slot (0x1000 write / 0x0108 result). Per-slave pending bitmap;
    5-query sequence pe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
2026-07-25 Task 03 Phase B: config writes via raw DTR0+SET pairs (verified)
    When g_config.dali_raw_cfg is on, per-ballast config writes (min/max/power-on/
    sys-fail/fade, from both the serial CLI key=val path and HA number entities via
    IC_CMD_SET_DALI) become controller-owned raw DALI sequences instead of gateway
    bank writes.
    - lighting_actions.c/.h: new lighting_dali_cfg_write() arms a DTR0-load
    (0xA3 <value>, once) + field SET (SET opcodes 0x2A-0x2F, twice) back-to-back
    on the raw FIFO as an indivisible unit (the FIFO is strictly ordered and the
    probe / config-query SMs both hold off while it is non-empty, so nothing
    interleaves between DTR0 and SET). All-or-nothing: rejects unless both frame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
2026-07-26 Task 03 Phase B: raw config write returns async (2) to skip pre-verify emit
    The HA command path (IC_CMD_SET_DALI) only emits state_dali when a field apply
    returns 1. Returning 2 (as the async 'on' path does) from the raw config-write
    branch suppresses the premature emit of the pre-write cached value, leaving the
    verifying query-back to write-through and emit the actual (clamped) value.
    Claude-Session: https://claude.ai/code/session_01Qx6PYci78VgBNLL3oDM6uq
2026-07-26 Task 03 review fixes: complete gateway tombstone, bound cfgq deadline, gate seed
    Addresses reviewer-03 findings on the phase A–C branch.
    - Finding 1 (MEDIUM): tombstone_gateway now clears the entire gateway HA device
    `lighting_dali_gw_<slave>` — the three gwdiag sensor discovery configs, the
    three provisioning sensors, four provisioning buttons and the target number,
    plus the gateway-scoped data topics (availability, diag, provision/status,
    provision/target_state). Previously it cleared only availability+diag, leaving
    a ghost gateway device in HA after retirement. ~15 empty retained publishes;
    best-effort QoS0 into the ~2 KB socket (drained during a manual decommission)
    an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
2026-07-26 Task 03 hotfix: settle-gate cfgq/probe against stale raw result register
    Fixes a stale-result race in the config-over-raw query-back. After a config
    write via lighting_dali_cfg_write() (DTR0+SET pair pushed fire-and-forget
    through s_rawq, no result read), the cfgq query-back could start the instant
    the FIFO drained — while the gateway was still executing the SET on the DALI
    bus and its terminal result still occupied the single shared result register
    (FC04 0x0108). The cfgq first-field poll then consumed that stale result,
    shifting the field reads by one.
    Bench repro (firmware 2.0.0+f7dbd9c): after `dali 3 0 min=200`, the commit
    published max=200/min=stale (device verified min=200, max=254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
2026-07-26 Task 04 stage 3 (transport): FC16 + FC23 in the Modbus master
    Add ACTION_WRITE_MULTI_REG (0x10) and ACTION_READ_WRITE_MULTI_REG (0x17)
    to the RP2040 Modbus master so the gateway command queue can be fed by a
    submit window write (FC16) and a combined submit+collect transaction
    (FC23, write-before-read). The action struct grows a write-side payload
    (wr_address/wr_count/wr_payload, capped at 8 registers = the 4-command
    submit window); existing fixed-frame enqueuers switch to designated
    initialisers so the inserted fields don't misalign. Frame builders for
    both new function codes added to start_action_tx; the generic CRC-gated
    RX path already handles their variable-length responses. Public API: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
2026-07-26 Task 04 stage 3: id-based gateway command-queue client
    New src/dali_queue.{c,h}: one driver per DALI gateway that owns a local FIFO
    backlog (the priority queue in front of the gateway's 8-deep queue), assigns
    gateway ids (1..31, cycling), and ships commands via FC23 — write up to 4
    records into the submit window (0x1100) and read the 10-register status block
    back through the holding alias (0x1180) in one transaction (submit-N /
    collect-N-1). Results are routed to each command's completion callback.
    Policy:
    - Strict credits: submit min(pending, free_slots, 4); free_slots tracked from
    every response is a conservative lower bound, so the gateway never answers
    SLAVE_DEVICE_BUSY at 19200.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
2026-07-26 Task 04 docs: document the command-queue client in the controller README
    - New "DALI command queue client" section: model (local FIFO priority queue +
    id assignment), FC23 submit-N/collect-N-1, strict-credit policy (19200, the
    one baud-adjacent constant), transport recovery (read-status-before-resubmit,
    idempotency), gateway-reboot resync + controller-boot id adoption, and the
    three subsystems ported (raw path, any-on probe, config queries) with the note
    that id-tagging retired the shared-result interlocks + settle-gate.
    - Update the register contract: config banks 0x0040-0x00FF retired (ILLEGAL
    DATA ADDRESS; config now raw-only), add the queue registers, mark the
    0x1000/0x1001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
2026-07-26 Task 04: `dq [slave]` CLI observability + queue-client counters
    Bench fault drills (power-pull resync, controller-reboot id adoption) need to
    read the client's internal state from outside. Add per-slave diagnostic
    counters to dali_queue (submitted, collected, timeouts, resubmits, busy
    exceptions, adoptions, reboot resyncs) plus last-seen accepted_id, and a
    dev-grade `dq [slave]` CLI command (dq_debug_print) that dumps scheduler state,
    ids, the in-flight (id:class) list, per-class queued depths, and the counters.
    Console printf like the existing `show` outputs; no MQTT surface. Documented in
    the controller README + help. Build-only; clean, zero warnings.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
2026-07-26 Task 04 review fixes (controller): stale config-bank comments + dq_submit_sync doc
    reviewer-04 findings 3-4:
    3. Config-bank leftovers:
    - dirty_poll.h: drop the deleted-field "only when g_config.dali_raw_cfg" note;
    remove the dead DALI_BLOCK1/2/3_START defines (only BLOCK0 is read now) and
    note the config banks were retired.
    - serial_protocol.c dali_cfg_field: clarify that 0x0040/0x0080/0x00C0 are an
    INTERNAL field-pair encoding, not gateway register addresses (the config
    banks are gone; writes go via a raw DTR0+SET queue entry).
    4. dq_submit_sync idempotent=true: document precisely why it is safe — the
    driver's read-status-before-resubmit recovery never double-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
2026-07-26 Task 04 review fix 4 (upgrade): dq_submit_sync gets a real idempotent parameter
    Per team-lead: finding 4 upgraded from a comment to an actual flag. dq_submit_sync
    now takes `bool idempotent` and passes it through to dq_submit. The CLI paths set
    it correctly:
    - `dali_raw` (arbitrary human-supplied frame, can be a non-idempotent UP/DOWN
    step) passes FALSE — a transport fault fails-and-reports to the operator rather
    than auto-resubmitting and risking a double-apply ("stale-but-never-wrong").
    - read_mem's SET DTR1 / SET DTR0+READ MEMORY (queries) and blink's DAPC pass TRUE
    (idempotent, safe to resubmit).
    One-line help note on dali_raw ("no auto-retry on fault").
    Controller builds clean,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
2026-07-26 Task 04 bench fix: converge reboot resync with adoption; stop double-fire
    Bench drill 1 (gateway UPDI reset mid-burst) exposed a ledger-corruption bug
    in dali_queue's reboot recovery. Two faults, both fixed here:
    1. Double-fire: the status-anomaly detector consumed the reboot (resync #1,
    correct), but ~30 s later the periodic sysinfo poll saw boot_count change
    and fired resync #2 for the SAME reboot. dq_resync now clears boot_valid,
    so the next dq_note_boot_count re-baselines to the gateway's current
    boot_count instead of reading the already-consumed change as a new reboot.
    2. Corruption: resync hardcoded next_id=1 / last_completed=0, assuming a fresh
    gateway. When it fired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
2026-07-26 Task 04 docs: README reboot-resync ≡ adoption + two-detector re-baseline
    Fold the 77fceaa behavior into the queue-client section: both reboot detectors
    (status anomaly, boot-count poll), either consuming a reboot re-baselines the
    other, recovery always routes through the read-only adoption path, and the
    resyncs counter is split by trigger (boot=/anom=). This is the behavior the §6
    fault drill validates.
    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
2026-07-26 Task 04 bench fix v3: converge fresh-rebuild baseline with adoption
    0223c54's fresh-rebuild branch hardcoded next_id=1/last_completed=0 as a
    parallel id-baseline, separate from the read-only adoption logic that a warm
    controller boot uses. On the bench (reboot drill, verify-exhaust -> fresh
    rebuild) that baseline sat one behind the gateway's real completed_id: a
    persistent accepted-completed=1 with a repeatable one-command answer lag
    (query N returned query N-1's answer) -- the same result-ring off-by-one class
    as the v1 double-fire, now delta 1 from the single rebuild.
    The adoption path (dq_handle_adopt) reads live accepted/completed and was
    proven clean on hardware twice. Converge on it: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
2026-07-26 Task 04 DEBUG: instrument fresh-rebuild for phantom root-cause (STRIP)
    TEMPORARY bench instrumentation to decide the fresh-rebuild phantom with ground
    truth rather than a plausible-but-wrong story. reviewer-04 proved the gateway
    zeroes q_accepted_id AND q_completed_id on init and cannot complete an unaccepted
    id, so accepted==0 => completed==0 always; the fresh branch is gated on
    accepted==0, so baselining last_completed from the live read (fc388ec) is
    expected to be a NO-OP for a genuinely-fresh gateway. That leaves two live
    hypotheses for the one-command answer lag: (1) the accepted==0 gate misfiring
    against a not-actually-fresh gateway, or (2) the re-pend/resubmit id alignment
    (rebuild re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
2026-07-26 Task 04 DEBUG: refocus instrumentation on the STRUCTURAL offset (STRIP)
    reviewer-04 + team-lead ruled out last_completed as the root: dq_collect ends
    every call with last_completed = completed_id, so a bogus 0 self-heals in one
    FC23 — a self-correcting scalar cannot cause a lag persistent across thousands
    of commands. The real root is structural: a permanent one-entry misalignment
    between the controller backlog and the gateway queue (front entry forever one
    behind the gateway's just-completed id). Prime suspect: dq_rebuild_fresh re-pends
    an entry the gateway already completed pre-reboot (result reached the ring, not
    yet collected) → a +1 phantom that shifts every later collection by one.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
2026-07-26 Task 04: strip fresh-rebuild phantom instrumentation — fix validated
    Removes the temporary dqdbg instrumentation (commits ccf535b + 6164ac0);
    src/dali_queue.c is now identical to fc388ec's fix. No behavior change.
    Mechanism the instrumented trace pinned (reviewer-04's consistency-trap):
    the reboot-resync path carried a SPLIT id-baseline. dq_rebuild_fresh set
    next_id/last_completed/free_hint/adopted itself — a parallel source separate
    from the read-only adoption logic (dq_handle_adopt) that a warm controller
    boot uses and that was proven clean on hardware. The two sources were not
    mutually consistent across the reboot-resync sequence, so the first
    post-rebuild collect paired the front ba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
2026-07-26 Task 04 fix: boot_count-confirmed reboot is authoritative — fresh-rebuild (DEBUG)
    reviewer-04's bisect (confirmed on HW at gw_diag_interval_ms=200): in a busy
    burst the controller's own post-reboot submits make accepted_id!=0, so the
    accepted==0 anomaly detector never fires. The pre-reboot in-flight commands were
    lost in the reboot but stay stuck at the front of the backlog (the gateway will
    never complete their old ids). If a boot_count poll fires INSIDE the ~2s
    transport-recovery window, the reboot_flag path — gated on accepted alone — took
    the ALIVE branch and KEPT the stale-lost entries, desyncing the result ring by one
    slot permanently. Present identically in 0223c54 AND fc388ec (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
2026-07-26 Task 04 DEBUG: log alive-branch PROMOTE/ROLLBACK to capture mechanism B (STRIP)
    Bench proved the boot_count-authoritative fix (4285a82) resolves reviewer-04's
    mechanism A (alive-KEEP of lost in-flight) but NOT the persistent lag — 8/8 at
    gw_diag=200, and a single triggered resync then scrambles 19/20 solid-register
    queries across multiple slots, self-clearing only on controller reboot. That is
    reviewer-04's mechanism B: the submit_n rollback race in dq_resync_apply's ALIVE
    branch — when the status read that drives the resync predates the gateway's accept
    of the just-sent submit, accepted_id != submit_last_id, so dq_rollback_submit
    re-pends a command the gateway ACTUALLY accepted → perm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
2026-07-26 Task 04: boot_count-confirmed reboot is authoritative — fresh-rebuild
    Clean, instrumentation-free shipping build. Supersedes the debug builds
    (4285a82 / 90b19d5); dali_queue.c is fc388ec's queue plus ONLY this fix.
    Bug (reviewer-04's bisect, confirmed on HW): in a busy burst the controller's own
    post-reboot submits make accepted_id!=0, so the accepted==0 status-anomaly detector
    never fires. The pre-reboot in-flight commands were lost in the reboot but stay
    stuck at the front of the backlog (the fresh gateway will never complete their old
    ids). When a gw-diag boot_count poll fires INSIDE the ~2s transport-recovery window,
    the reboot_flag path — gated on accepted alone — took the ALIVE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
2026-07-26 Task 04 docs: known-limitation names BOTH reboot-recovery residuals
    Honest-docs correction on top of the boot_count-authoritative fix. The shipped
    known-limitation (dali_queue.h + README) previously named only the fast-poll
    boot-poll-mid-recovery transient and framed the residual as poll-gated/unreachable.
    Per reviewer-04's reachability correction that UNDERSTATED severity: there is a
    SECOND residual — the transport-glitch / verify-exhaust submit_n rollback race
    (dq_resync_apply: a status read predating the gateway's accept of the just-sent
    submit rolls back a command the gateway actually accepted) — which is PROD-REACHABLE
    independent of poll rate (on the transport-recovery path, not gw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
2026-07-27 Task 06 stage 1: generic Modbus command-queue pattern doc
    Queue v2 stage 1 (register-map lock + pattern doc). docs/modbus-command-queue.md
    describes the generic, DALI-AGNOSTIC self-describing slot protocol: 8 slots, per-slot
    lifecycle (idle/pending/executing/complete/failed), opaque 32-bit command in +
    [status:8|response8:8] out, slave-assigned wrap-aware accept-sequence ordering,
    reject-write-to-active (0x06 all-or-nothing), and the master rules (optimistic cache,
    FC23 write+read submit, deliver-once, reconcile-from-8-statuses, idle-means-gone
    fail-all + resubmit-idempotent, ABA guard).
    Bakes in reviewer-04's six correctness cruxes: status-write atomicity (response8
    before status under the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
2026-07-27 Task 06 stage 3: controller generic mbq_client (unwired)
    Adds the controller half of the generic Modbus command-queue: mbq_client.c/.h —
    the DALI-AGNOSTIC mirror of the gateway mbq_slots protocol. Per Modbus slave, an
    OPTIMISTIC 8-slot cache + a single-in-flight FC23 transaction SM. Opaque 4-byte
    command in, (result, response8) out to a per-command callback. No id ledger, no
    resync/rebuild/rollback — the gateway's 8 slot statuses are the truth, reconciled
    on every read-back.
    Design (documented in the source for the reviewer audit — this carries the task-04
    transport-glitch/reboot bug class, so the subtle points are called out):
    - Per-slot cache lifecycle FREE→ARMED→SENT→LIVE→(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
2026-07-27 Task 06 stage 3 fix: SENT-going-idle re-arm respects idempotency
    Closes the idempotency trap team-lead flagged in mbq_client's reconcile. A SENT
    (never-confirmed) slot exists only when the submit FC23's response was lost; an
    idle read on it is ambiguous — the write never landed (never executed) OR it
    landed, executed, and the gateway rebooted before the next read (ALREADY RAN). My
    first cut re-armed it unconditionally ("never executed → safe"), which would
    double-apply a non-idempotent step (UP/DOWN) in the executed-then-rebooted case.
    Fix: the SENT-going-idle path now applies the SAME idempotency policy as the
    reboot/fail path — re-arm to resubmit ONLY if idempotent; deliver MBQ_R_LO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
2026-07-27 Task 06 stage 3 fix v2: never-confirmed SENT slot is untrusted (reviewer-04 A+B)
    Closes reviewer-04's REQUEST-CHANGES on mbq_client reconcile — the v2
    mis-attribution/double-apply class. A SENT (never-confirmed) slot's read-back
    status is trustworthy ONLY in its OWN submit transaction (its write executed
    before that same read); resolved by any LATER poll it is ambiguous and must not be
    delivered by that status.
    - reconcile() now takes submit_slot (the slot this txn wrote, 0xFF for a poll).
    A SENT slot with k != submit_slot is resolved by idempotency (re-arm / LOST),
    NEVER by its status — fixes BOTH:
    A (idle read): could be write-never-landed OR landed-executed-then-rebooted.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
2026-07-27 Task 06 stage 3 fix v3: reconcile matches reviewer-04 net rule exactly
    Refines the B fix (6d218c2) to reviewer-04's precise SENT-resolution rule and
    closes a residual I introduced: a SENT non-submit-slot was idempotency-resolved
    for ANY status — including PENDING/EXECUTING, which is unambiguous (the gateway
    makes a slot active only in response to OUR write, so it landed). For a
    non-idempotent command that landed, that wrongly delivered LOST while the command
    actually ran (a false-LOST mis-report).
    reconcile() Pass 2 now:
    - PENDING/EXECUTING (any owned slot, incl. still-SENT) → LIVE (write landed, confirmed).
    - TERMINAL/IDLE: trusted only if the slot is LIVE or the submit_slot's own read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
2026-07-27 task 06 stage 4: refactor dali_queue into a DALI adapter over mbq_client
    Replace the v1 id-ledger driver in dali_queue.c with a thin DALI adapter over
    the generic queue-v2 client (mbq_client). The per-slave priority scheduler and
    the producer API (dq_submit/dq_submit_sync/dq_busy/dq_debug_print) are unchanged
    above the client; the transaction layer beneath is now the 8-slot self-
    describing protocol.
    - dq_init registers each DALI slave with mbq_client; dq_tick drives
    mbq_client_tick then ships the highest-priority backlog command into a free
    gateway slot, capped at DQ_INFLIGHT_MAX in flight so a fresh high-priority
    command is never stuck behind background work filling all 8 slots.
    - P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
2026-07-27 task 06 stage 5: controller README queue-v2 rewrite
    Rewrite the "DALI command queue client" section for queue v2: describe the two
    layers (generic DALI-agnostic mbq_client + the dali_queue.c DALI adapter/
    scheduler on top), the priority ladder + DQ_INFLIGHT_MAX depth cap above the
    client, the [addr,data,flags,dtr0] payload contract, the response8 ->
    dq_result_t mapping (collision-vs-NAK preserved for the any-on probe), and the
    status-driven "idle means gone" reboot recovery. Delete the task-04 known-
    limitation block (the recovery-corruption class it tracked is eliminated by
    construction in v2) and all the id-ledger/resync/boot_count prose. Add the
    matched-set / no-cross-version-interop note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
2026-07-27 task 06: CLI dali_raw prints specific failure reason (backlog/timeout/lost)
    dq_submit_sync now sets *result to DQ_RES_BACKLOG or DQ_RES_TIMEOUT on its two
    false-return paths so the CLI distinguishes a submit rejected up front (backlog
    full) from a submitted command that missed its 300ms deadline (bus congestion),
    instead of printing a bare timeout for both. A reboot-lost command is surfaced
    as 'lost (gateway reboot)' rather than the cryptic 0x0203 result word.
    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
2026-07-28 Task 07 stage 1: command-queue soak probe (verified DTR0 write/read pairs)
    A bench instrument for the comms path, not a product feature. The relay
    ballast cannot switch fast enough to be a soak stimulus, and the config
    parameters (fade time, power-on level, ...) are NVM-backed — a multi-hour
    soak would eat the gear's EEPROM write-cycle budget.
    DTR0 is the settable thing that is VOLATILE: SET DTR0 = v (0xA3<v>, one
    forward frame, no answer) followed by QUERY CONTENT DTR0 (0x98, backward
    frame) must answer exactly v. Verified on the bench ballast (slave 3 addr 0)
    with dali_raw before writing any code. v walks a stride-97 cycle over all
    256 values, so consecutive pairs never share an expecte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
2026-07-28 Task 07: fix soak set-accounting + add per-transaction timing
    Two corrections from the first bench run:
    - A no-answer forward frame (KIND_CMD) is completed by the gateway as
    FAILED/DALI_RESP_NAK — "no backward frame" is the SUCCESSFUL outcome for a
    fire-and-forget send (dali_state_transmitting.c: finished_transmission()
    calls dali_result_received(DALI_RESPONSE_NAK, 0) for CMD_SEND). The soak was
    scoring all 73 SET DTR0 frames as failures. Only a real bus error or LOST
    counts now.
    - txns-per-command was double-scaled by print_rate (reported 106.71 for 1.07).
    New instrumentation, because the first run showed ~100 ms per Modbus
    transaction where an FC23 at 19200 should cost ~22 ms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
2026-07-28 Task 07: RS-485 bus-occupancy accounting + `busload` CLI
    The soak's transactions measured 22 ms on the wire (the theoretical FC23 cost
    at 19200) but 102 ms end to end, so the command path is waiting for the bus,
    not driving it. Nothing in the firmware could say who had the bus.
    modbus.c now charges every transaction from the moment it leaves the action
    queue until the SM returns to IDLE — including its retries and the post-frame
    dead time, i.e. what that transaction really costs every other producer. A
    dead board being retried three times a poll therefore shows up as the bus hog
    it is, which no other view exposes. Read it with `busload` (per-slave split,
    `busload reset` to start a fresh w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
2026-07-28 Task 07: count Modbus re-sends in the busload window
    A transaction that times out, retries and then succeeds is invisible in every
    per-transaction success count, yet costs a full 50 ms response timeout of bus
    time. Without this, "the slave is slow to answer" and "the reply is being
    lost" look identical from the controller. Both re-send classes (timeout and
    DEVICE_BUSY) are now counted per busload window and printed by `busload` and
    in the soak report.
    Claude-Session: https://claude.ai/code/session_01STSZT2DguJ8ntaDTJXvk1d
2026-07-28 Task 07: measure slave turnaround (request out -> reply in)
    The soak's transactions cost 82 ms of bus each while the wire time is 22 ms,
    and the busload window showed 114 timeout re-sends and 523 DEVICE_BUSY
    re-sends. DEVICE_BUSY can only mean the targeted slot was already
    pending/executing (mbq_slots.c) — i.e. our own earlier write had landed and we
    re-sent it. So the question is whether those replies are LOST or merely LATE,
    which turnaround measurement answers directly: time from our last byte
    clearing the line to a valid reply, against the 50 ms response timeout.
    Reported by `busload` and in the soak report.
    Claude-Se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
2026-07-28 Fix: FC23 submit declared a 2-slot write — every command put a bogus DALI frame on the bus
    mbq_client's issue_submit passed MBQ_CMD_BYTES (4) as the FC23 write count,
    but that parameter is a REGISTER count. So each submit declared an 8-byte
    write: the gateway's submit_window computed n_slots = wr_count/2 = 2 and armed
    slot k AND slot k+1, and modbus_read_write_multiple_registers memcpy'd 8 bytes
    out of the 4-byte cmd[] — so slot k+1's "command" was the four bytes that
    follow cmd[] in slot_t, i.e. the callback pointer, interpreted as
    [addr, data, flags, dtr0].
    Consequences, all present in the shipped task-06 firmware:
    - HALF of every DALI frame issued was garbage, at full priority, so th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
2026-07-28 Task 07: long CLI dumps go through the CDC ring, not printf
    stdout is deliberately non-blocking (PICO_STDIO_USB_STDOUT_TIMEOUT_US=0), so a
    printf burst that outruns the host is silently truncated MID-LINE — which is
    exactly what was corrupting the soak report and busload dump, in the middle of
    the numbers they exist to deliver. New cdc_out_printf() formats a line and
    hands it to the same 4 KB ring the logs use, which serial_poll paces to what
    the FIFO can accept. Soak report and `busload` now use it.
    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
2026-07-28 Task 07 docs: soak/busload in the README, submit-length rule in the pattern doc
    Documents the two bench instruments (what they measure and how to read the
    pacing verdict), the DTR0-is-volatile reason for the stimulus choice, and the
    reference numbers. The generic pattern doc gains the rule the two-slot bug
    broke: a submit's FC23 write count is in REGISTERS and the slave derives
    n_slots from it, so wrong units silently arm the next slot with adjacent memory
    as a real command rather than failing the request.
    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
2026-07-28 Task 05 phase 1: pull scheduler replaces the shared backlog; dim steps become per-target counters
    The controller-side queue was one 16-deep priority-sorted FIFO per slave. Two
    problems, both measured in task 07:
    - Shared storage: background work can occupy the entries a button press needs.
    The bench reported backlog_full=2 in normal operation, and each of those is a
    silently dropped command.
    - Latency: the GATEWAY executes strictly FIFO with no priority, so every
    background command already submitted delays a button by a full DALI frame.
    DQ_INFLIGHT_MAX was one number for all classes, so background work routinely
    sat 3 frames deep in front of user work.
    Storage is now partitioned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
2026-07-28 Task 05 phase 1: measure the scheduler — dali_raw latency + soak submit paths
    The scheduler's claim is a bound on priority inversion, so it needs a
    measurement, not an assertion.
    - dali_raw now prints elapsed time. It is a USER-class submit, so it measures
    exactly what a button press would see under whatever load the bus is
    carrying.
    - soak gains path=direct|bg|user. direct (default) bypasses the scheduler and
    measures the transport, as before. bg/user route through dq_submit at that
    priority class, turning the probe into realistic load OF A CHOSEN CLASS —
    which is how the bound gets measured: saturate with path=bg and time a
    dali_raw against it.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
2026-07-28 Task 05 phase 1: a class-full refusal is backpressure, not an error event
    dq_submit returning false means different things to different producers: to a
    button it is a dropped command (and that caller logs it), to a polling producer
    — the config-query rotation, the bench probe — it is ordinary "try again next
    tick" backpressure. With the background class only 2 deep, a polling producer
    generated 818 730 refusals in one bench run, each one a LOG_WARN. Now
    rate-limited (every 256th) with the counter as the signal, matching how
    modbus.c reports drops. Counter renamed refused= in the dump to say what it
    actually counts.
    Also paced the soak's scheduler path against its own depth rather than t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
2026-07-28 Task 07: back off the soak's scheduler path after a class-full refusal
    The main loop spins far faster than DALI drains, so a probe offering commands
    to a deliberately shallow class retried thousands of times per second — 74 408
    refusals in one bench session, all of them backpressure rather than a fault.
    Back off ~5 ms before re-offering, which keeps the refused= counter meaningful
    as a signal.
    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
2026-07-28 Fix: an empty relay_slaves/dali_slaves list could not persist
    config_load() applied a parsed slave list only `if (count > 0)`, so an EMPTY
    list was indistinguishable from a missing key and the compiled default was
    restored on the next boot. "This installation has no relay board" is a valid
    configuration — it can be set at runtime and appeared to take effect, then
    silently reverted to slave 1 on reboot, which is how it was found: the bench
    kept polling a relay board that had been removed from the config.
    get_u8_array now returns -1 for an absent key and >= 0 for a present one
    (including empty), so only a missing key falls back to the default.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
2026-07-28 Fix: `net` reported 0.0.0.0 for a device with a working DHCP lease
    cmd_net printed g_config.net_ip — the configured STATIC address, which is all
    zeros whenever dhcp is on. So a controller with a perfectly good lease, a live
    web server and an active MQTT socket reported ip=0.0.0.0, which reads exactly
    like a network fault to anyone diagnosing one. It cost real time here: the
    bench controller was declared unreachable and HA testing written off as
    blocked, when it was sitting on 192.168.1.218 the whole time.
    Core 1 now republishes the live interface address each loop into a shared
    volatile (same pattern as the heartbeat — no queue changes), and `net` prints
    it first, marking "(no lease yet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
2026-07-28 Task 05 stage 1a: DALI level/off writes go through the command queue
    lighting_dali_set_level and the OFF branch of lighting_set_on_off wrote to the
    gateway's per-ballast brightness bank (FC06 0x0000+addr) and let the gateway
    synthesise the DAPC frame. Task 05 removes that register, so the controller now
    emits the DAPC itself — address byte in DAPC form (bit 0 clear), arc level as
    the data byte, idempotent.
    Bench-verified on slave 3 addr 0: on=true -> on/254, bri=128 -> clamped to 254
    with status 0x0C (limit error, correct for a binary relay ballast whose
    min=max=254), on=false -> off/0. The clamp is exactly the "trust the read-back,
    not the intent" case the design calls for.
    Co-Authored-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
2026-07-28 Task 05 stage 1b: controller-owned DALI world model (dali_state.c)
    The controller now learns every fact about a ballast by QUERYING IT through
    the command queue, instead of reading a gateway register. This is the half of
    task 05 that has to exist before the gateway strip can remove anything.
    Replaces, one for one:
    gateway block0 (arc/status) -> QUERY STATUS + QUERY ACTUAL LEVEL sweep
    gateway dirty bitmap -> post-command verification marks
    gateway present bitmap -> presence evidence rules
    gateway group masks -> QUERY GROUPS 0-7 / 8-15 per ballast
    Work is held as BITMAPS of what needs asking, not as a queue of commands, so a
    ballast marked twice before its que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
2026-07-28 Task 05 stage 2: group membership writes become DALI frames
    dali_group_set_members wrote the gateway's group-mask registers (0x0110+) and
    let the GATEWAY diff old-vs-new and emit the ADD/REMOVE FROM GROUP frames. That
    cache is going away with the strip — and it was also the root of the
    group-toggle bug: a rebooted gateway lost the masks, so the diff had nothing to
    work from and group buttons always turned on.
    The controller now diffs against its own cache and emits the frames itself
    (ADD 0x60|g, REMOVE 0x70|g, send-twice, idempotent), spinning the bus until
    each is accepted rather than dropping members of a membership change when the
    user class is momentarily full.
    Crucially the result i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
2026-07-28 Task 05 stage 3: DALI commissioning moves to the controller
    The IEC 62386-102 binary-search address assignment ran inside the gateway
    behind MBREG_COMMISSION (write a mode word, poll a status word). That register
    and its state machine go away with the strip, so the sequence is now driven
    from the controller as ordinary queued DALI frames — INITIALISE, RANDOMISE,
    SEARCHADDRH/M/L, COMPARE, PROGRAM SHORT ADDRESS, VERIFY, WITHDRAW, TERMINATE.
    No tight inter-step timing is involved: the gear's INITIALISE window is 15
    minutes against a run of tens of seconds.
    PORTED, not rewritten — including the two behaviours that were found on
    hardware in the gateway implementation and are easy to get wron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
2026-07-28 Task 05 stage 3 fix: provisioning frames need their own scheduler class
    The first bench run of controller-side commissioning deadlocked at the very
    first step ("Commissioning (initialise)... 0 devices" then a step timeout).
    dq_tick had: if (dali_provision_busy_slave(id)) continue;
    That gate was written when the GATEWAY owned commissioning, where the correct
    behaviour was indeed "submit nothing to this slave". Now the controller drives
    the sequence through that same queue, so the gate blocked the commissioning
    frames themselves — the run could never issue its first INITIALISE.
    Provisioning now has its own class (DQ_CL_PROV, cap 2, depth 1 — each bisect
    step depends on the previous ans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
2026-07-28 Fix: CLI/HA group `on=toggle` silently meant OFF; and the on/off parser
    Two bugs, the second self-inflicted while fixing the first.
    1. The CLI group handler tested the value against "true"/"1"/"on" only, so
    "toggle" matched nothing and fell through to FALSE — `dali <s> g<n>
    on=toggle` sent an unconditional OFF with no error. The per-ballast path
    handled toggle correctly; only groups were wrong. This is also why an
    earlier group-toggle regression drill appeared to pass while proving
    nothing: the light was on, the command sent OFF, and it looked like a
    correct toggle.
    2. Reusing parse_on_off_toggle() for the fix then broke `on=true`, because that
    helper accepted only o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
2026-07-28 Task 05 stage 4: delete the gateway-register reads; reachability via the queue
    dirty_poll.c 658 -> 328 lines. Every read of a register the strip removes is
    gone: block0 (arc/status), the present and dirty bitmaps, the group masks, and
    the background presence/fault check that walked them. What remains is the relay
    board (a different device) and the gateway sysinfo poll, neither touched by the
    strip. The controller now reads NOTHING from a gateway but the command queue
    (0x1000/0x1010) and sysinfo (0x0310).
    Fixes a regression I introduced when disabling the dirty sweep: gwdiag_cb
    deliberately ignores failed reads because "the dirty sweep owns reachability" —
    so with the sweep gone, NOTHING m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
2026-07-28 Fix: the background sweep was 256x faster than it had any reason to be
    The world model swept one ballast every 250 ms per slave. Nothing needed that.
    The system verifies its own commands immediately via the post-command path, so
    the sweep exists ONLY to catch what nothing tells us about — a ballast that lost
    power and came back, or gear changed outside this controller. For scale, the
    gateway's own rescan cursor that this replaces ran at one ballast per 64 s.
    Measured cost of the mistake: the RS-485 bus sat 59% busy on an idle system,
    400 transactions in 16 s, achieving nothing. After: 3% busy, 27 transactions in
    21 s. Idle user-command latency tightened correspondingly — p90 83.3 -> 70.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
2026-07-28 Task 05: make the DALI sweep interval tunable; probe absent addresses
    dali_sweep_interval_ms joins the config surface alongside gw_diag_interval_ms,
    with the same 0-means-off convention: CLI `cfg`, /config.json, the intercore
    snapshot, the HA number entity ("DALI Background Sweep (ms)"), the web UI field
    and the /api/cfg POST handler. Default 10000. Disabling it is safe — every
    command the system issues is still verified immediately by the post-command
    path, so 0 only means "never re-check a ballast that nothing told us about".
    Fixes a real gap found while answering "does the controller do a faster sweep
    at boot?". It does — the boot scan is checked BEFORE the interval gate, so it
    runs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
2026-07-28 Fix: adding a controller-config entity silently published nothing
    disc_controller() walked its entities with the bounds hardcoded in four places
    — `if (k < 4)`, `k - 4`, `k == 6`, and `s_i >= 7` for the phase total — while
    the entity tables were locals. So adding dali_sweep_interval_ms as a fifth
    number put it in the table but PAST the guard: no discovery message, no HA
    entity, and nothing anywhere said so. The key worked over CLI, config.json and
    the web UI; only HA was quietly missing it.
    Tables hoisted to file scope and every bound derived from their sizes
    (CFG_NUM_N / CFG_SENS_N / CFG_STEPS), so the next entity added is published by
    construction rather than by remembering to update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
2026-07-28 Fix: controller-config discovery object_ids were silently truncated
    disc_controller() formatted its object_id into char[32]. The longest is
    "lighting_cfg_dali_sweep_interval_ms" (35 chars) and
    "lighting_cfg_gw_diag_interval_ms" is 32, so BOTH were cut short in the
    discovery topic — the latter since it was added. snprintf truncates without
    complaint and the topic is the only place it surfaces, so nothing ever said so.
    Harmless in practice (HA keys entities on the unique_id in the payload, which
    was always full-length) but it makes the retained topic tree misleading and two
    config keys sharing their first 31 characters would have collided outright.
    Widened to 48, matching the other discove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
2026-07-28 One DISC_BUF (64) for every discovery string buffer
    Per user: stop hand-sizing these. They were individually 24/28/32/40/48, and
    the one that was too small — controller-config object_ids at 32, against the 35
    chars "lighting_cfg_dali_sweep_interval_ms" needs — truncated silently, because
    snprintf does not complain and the discovery topic is the only place it shows.
    "lighting_cfg_gw_diag_interval_ms" (32) had been cut short since it was added.
    A single generous constant removes the class rather than the instance: adding a
    longer entity key can no longer quietly cut a topic short. Cost is stack in the
    core-1 discovery frames, which have 8 KB.
    Stale truncated retained topics cleared on th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
2026-07-28 Task 05 docs: controller README — world model + scheduler model
    The README described a controller that polls a gateway dirty bitmask and reads
    block-0 registers. Since task 05 the gateway caches nothing, so all of that was
    wrong.
    - "DALI ballasts — dirty-bit polling" replaced by "the controller's world
    model": the three work sources (post-command verification, discovery,
    background sweep) with their priorities and rates, the measured 4.87 s full
    interrogation, fade tracking, and the presence evidence rules including why
    an explicit scan is authoritative where the background sweep is not.
    - NEW "Scheduler model" section — the class-partitioned storage and per-class
    gateway de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
2026-07-28 Absent-slave backoff: keep dead slaves off the bus
    A slave that is not there cost MODBUS_MAX_RETRIES+1 attempts x the 50 ms
    response timeout — ~186 ms of bus per transaction, every time any producer
    polled it. Measured as the LARGEST single contributor to worst-case command
    latency: a user command arriving behind one waits the whole thing out, because
    a Modbus transaction cannot be preempted.
    Four parts, each found by measuring the previous one:
    1. TRANSPORT BACKOFF (modbus.c). After 3 consecutive dead transactions, stop
    putting that slave on the wire; requests complete immediately as a timeout
    without transmitting, so producers see exactly what they saw before, minus
    the bus co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
2026-07-28 Fix: the blocking full scan could trip the watchdog on a real bus
    dirty_poll_full_scan() spins modbus_poll/dq_tick/dali_state_tick until the
    interrogation completes, and never fed the watchdog. At boot that is harmless —
    it runs before watchdog_enable() — but `scan` and the post-provisioning re-scan
    run at RUNTIME against a live 5 s watchdog.
    The scan's duration scales with how much gear is on the bus: an ABSENT address
    costs one query, a PRESENT one costs four. Measured 4.87 s with the bench's
    single ballast, which is why every test so far passed — by about 130 ms. Three
    or four present ballasts would exceed 5 s, and a full 64-ballast bus takes
    ~15 s, so on a real installation `provi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
2026-07-28 Boot no longer blocks on DALI interrogation: 53 s -> 3.5 s
    Measured on the bench with one absent gateway configured (dali_slaves=2,3,
    slave 2 not present):
    before: 3226 boot: scanning slave 2
    48226 dirty: slave 2 full scan TIMED OUT <- whole 45 s deadline
    53271 boot: main loop entering <- 53 s to boot
    after: 3227 dirty: slaves 2,3 full scan armed (non-blocking)
    3500 boot: main loop entering <- 3.5 s
    3757 dstate: 3.0 present <- discovered by the main loop
    An absent gateway can never finish a scan — every query to it fails — so the
    blocking wait could only ever burn its entire deadline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
2026-07-28 All DALI scans are asynchronous; delete the blocking variant
    The CLI `scan` was still blocking. That is the worst of the three cases, not
    the most defensible one: unlike boot, `scan` gets typed on a LIVE system where
    someone may be at a wall switch, and it stalled the main loop for the whole
    interrogation — many seconds on a populated bus, with buttons unresponsive
    throughout.
    dirty_poll_full_scan() is now DELETED rather than left available to be called
    by mistake. Every trigger — boot, CLI, post-provisioning — arms the scan and
    returns; the main loop drives it.
    Also fixes a gap introduced when boot was made async: lighting_emit_scan_complete
    was only ever called from the blocking fu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
2026-07-29 Docs: absent-slave backoff, asynchronous scans, boot sequence
    README was still describing behaviour that changed after the strip:
    - Boot sequence step 8 said "blocking read of every ballast bank + group masks".
    Both halves were wrong — there are no banks or masks to read, and boot no
    longer waits on the interrogation at all.
    - NEW "Absent slaves are backed off" section: why a dead slave was the largest
    contributor to worst-case latency (an uninterruptible ~186 ms transaction),
    the backoff policy, single-attempt probes, and the two producer-side
    companions needed because a skipped request completes instantly while every
    producer's pacing assumes ~25 ms. Records 236 -> 89 ms.
    -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
2026-07-29 docs: gateway diag block now reports internal faults (reg13/reg14)
    The gateway records errors that had no caller to return them to (bad slot
    index in the DALI completion ISR, refused command launch) and exposes
    them in the existing FC04 0x0300 block. Document them next to the RX
    counters, since that is where you go looking when a gateway misbehaves.
    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
2026-07-29 controller: clear the task-05 hangovers; fix two silent failures
    Review pass over controller/ for hangovers from superseded approaches.
    Two of the findings were live faults, not just dead weight.
    SILENT CLI (fixed). Every text command reported ONLY on error. On success
    cmd_dali / cmd_relay / cmd_cfg called emit_state_*, which publishes an
    ic_event_t to CORE 1 for MQTT and prints nothing — so `dali 3 0 on=true`
    switched the light and emitted not one byte to the terminal. A hangover
    from when the Python host bridge consumed this CLI's JSON off the serial
    wire and emitting the report WAS the reply; when the bridge moved on-board
    (2026-06-09) the report went to a channel the human cannot see,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
2026-07-29 cli: toggle reads the gear, like the button does
    A CLI toggle inverted cached state; a button toggle asks the ballasts.
    serial_protocol.c already carried a comment calling that asymmetry "worth
    unifying". It is unified now: both read, then write.
    Per-ballast and per-group toggles issue QUERY LAMP POWER ON to the target
    and invert what the GEAR reports — same opcode, same reading of the answer
    (answered = on, garbled = a collision of answers so still on, NAK = none
    on) as the button's press-time probe.
    The semantics live in ONE place. lighting_actions.c owns the opcode and
    the result mapping, and now exports lighting_any_on_probe_sync() for the
    blocking single-address case rather than ser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
2026-07-29 lighting: async toggle for the HA path, and fix HA group toggle
    The CLI toggle now reads the gear; the intercore/HA path still inverted
    cached state, because it runs in the main loop where a blocking probe
    would stall Modbus, MQTT and the watchdog feed. It now probes
    ASYNCHRONOUSLY: submit QUERY LAMP POWER ON through the normal queue, apply
    the inverse when the answer lands.
    Found while wiring it: the HA GROUP toggle was silently broken. The
    handler read
    lighting_group_set_on_off(slave, group, c->set_group.on == IC_TRI_ON);
    so IC_TRI_TOGGLE compared unequal and meant OFF. Exactly the bug the CLI
    group path carried and had fixed — never fixed here, so an HA group toggle
    turned the li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
2026-07-29 docs: correct the "HA path" claim on the async toggle
    Answering "have we tested it from HA?" honestly: no, and it cannot be.
    The previous commit called lighting_toggle_async "the HA path". It is not.
    We publish "schema":"json" light and group entities. HA's MQTT JSON light
    sends only {"state":"ON"} / {"state":"OFF"} — light.toggle is resolved
    inside HA, from the state WE publish, before anything reaches the wire.
    And ha_bridge's inbound parser is binary anyway:
    *on = jtok_eq(pay, &tk[si], "ON") ? IC_TRI_ON : IC_TRI_OFF;
    so IC_TRI_TOGGLE is never produced over MQTT. The async toggle is reached
    by the HTTP API / web UI and by anything else pushing IC_TRI_TOGGLE — not
    by Home Assista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
2026-07-29 ha: never publish a level the ballast has not confirmed
    A brightness set published the REQUESTED level as if it were fact:
    lighting_dali_set_level(slave, addr, lvl);
    state_cache_set_dali_arc(idx, addr, lvl, ...); /* the request */
    return 1; /* -> caller emits */
    The ballast then clamps to its own min/max — often far from the request —
    and fades there over seconds, so HA showed the number asked for, then
    jumped when the truth arrived. Your example: min 110, fade 2 s, slider
    dragged to 5 reports 5, snaps back, then drifts to 110.
    The requested level is no longer written to the cache or published. "bri"
    returns 2 (applied, nothing know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
2026-07-30 mqtt: subscribe to commands only; read config from the gear at boot
    The controller is the SOURCE of bus state, not a sink for it. It had one
    subscription that broke that: "dali/+/+/config" — its own retained
    per-ballast config topic. At boot the broker replayed it and core 0 adopted
    the values (IC_CMD_SEED_DALI_CFG), so a ballast that had been swapped or
    externally reconfigured while we were off came back with its OLD config
    presented as fact. Every other filter in the list is a command; that one was
    us reading our own output back.
    Gone: the subscription, the ha_bridge inbound branch, IC_CMD_SEED_DALI_CFG
    and its payload struct, and the core-0 adopt handler. Adoption is now
    impossible by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
2026-07-30 ha: publish nothing about a device until it has been read
    Extending "measured only" to its consequence: silence, not placeholders,
    for anything not yet interrogated. A device is disclosed as its information
    becomes known, which during boot means progressively.
    Ballast STATE was already gated correctly — resync skips !b->present, and
    present is set only when a ballast answers. Two things were not:
    CONFIG IC_EVT_DALI published the config topic on EVERY state event,
    unconditionally. A ballast's six config fields are zero until a
    raw config read lands, so any state change before that published
    {"min":0,"max":0,...} — asserting min=0/max=0 as fact for a devi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
2026-07-30 ha: discover every possible device; availability off until it answers
    Correcting the model: silence was the wrong default for DEVICES. Entities
    should always exist so HA can show the full estate; what must be withheld is
    the claim that a device is there and the values describing it.
    Discovery was already right and stays untouched — disc_step publishes the
    whole set unconditionally: all 64 ballast lights and their 6 config numbers
    per DALI gateway, all 32 relay channels, all 16 groups (light + members),
    button plates, provisioning, gateway diagnostics and the controller. Nothing
    is conditioned on what is actually out there.
    The availability HIERARCHY was already right too: relay and balla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
2026-07-30 watchdog: cover boot, not just the main loop
    You were right that discovery went async — but only the DALI ballast
    interrogation did. dirty_poll_arm_scan() returns immediately and the main
    loop drives it. The thing main()'s comment was guarding is the SLAVE
    discovery, which is still blocking, and that is a handful of Modbus pings
    rather than a 64-address sweep.
    So the gap was not "boot is inherently too slow to watch". It was that
    main() disarmed the bootloader's 8 s watchdog as its very first action — it
    has to, the bootloader's window is fixed — and then armed nothing until
    main-loop entry. Everything between ran unprotected: core1_launch, fs_init's
    first-boot format, blocking slave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
2026-07-30 review: stale-data and unknown-state holes left by this week's changes
    Second pass over controller/, looking for interactions our changes created
    rather than for dead code. Six findings, one of them a regression I caused.
    REGRESSION I INTRODUCED. lighting_emit_dali_state's group fan-out walked
    only the groups CURRENTLY containing the ballast. When a ballast is REMOVED
    from a group, the read-back that discovers the removal has already cleared
    the bit — so the group it just left was skipped and never re-published,
    keeping a stale member list and stale derived on/bri in HA. Harmless while
    the setter published an optimistic list immediately; live the moment that
    went. Now offers all 16 groups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
2026-07-30 review: whole-tree pass — strict warnings, dead symbols, loop audit
    Covering the files the last two reviews only dead-symbol-swept: net/
    (http_server, web_state, mqtt_app, netif, dns_resolve, http_client, ping,
    ota, fwupdate), ota_stage, boot_control, mapping, config, button_*.
    Ran the controller through -Wextra -Wshadow -Wundef -Wstrict-prototypes
    -Wmissing-prototypes -Wpointer-arith -Wcast-align, driven off CMake's
    compile_commands.json so every TU builds with its real flags. The tree came
    back CLEAN apart from one finding. (-Wswitch-enum fires ~25 times but is
    noise here — it warns even where a default: exists.)
    emit_button_event was declared as a bare extern inside button_fsm.c a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
2026-07-30 web: relays array is always 32 entries; null means never read
    Closing the gap flagged in c5d18c6. The channel count is fixed and known,
    so the array's length should not depend on what we happen to have heard
    from.
    web_state serialised relays as a boolean array truncated at the highest
    channel ever seen. Two consequences: a channel BELOW that high-water mark
    which had never reported rendered "false" — the cached default presented as
    a measurement, the same "unread is not off" bug already fixed in the CLI and
    MQTT paths — and with nothing read at all the array was empty, so the UI
    said "No relays known yet" and showed no estate.
    Now always RELAY_COUNT entries, with null for a channel not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
2026-07-31 web: re-read after a write instead of waiting out the poll
    You saw a group toggle click the relay immediately while the other groups
    containing that ballast updated a beat later. Measured where the time went:
    command sent 07:58:06
    dali/3/0/state 07:58:06 {"state":"OFF"}
    group/3/0/state 07:58:06
    group/3/1/state 07:58:06
    group/3/9/state 07:58:06
    The device is sub-second: DALI command, verification read of the ballast,
    all three groups recomputed from its MEASURED level and published, inside
    the same second. The lag was entirely this UI's POLL_MS = 1500. MQTT/HA
    never had it — that side is pushed.
    So the fix is to look sooner, NOT to predict locally: api.js gains a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
2026-07-31 web: provisioning shows the device's own state name and message
    "State 11" was two bugs, and the display was the smaller one.
    11 is PROV_STATE_ERROR. That run FAILED — the CLI had the detail all
    along: state=error slave=3 devices_found=0 msg="Error: no ballasts found".
    /api/state served {"slave":3,"state":11,"count":0}: the number without the
    label, and the message dropped entirely despite web_state already storing it.
    The UI then made it worse. provision.js carried
    { 0:'idle', 1:'running', 2:'complete', 3:'error' }
    which is the GATEWAY's old 4-value commission status word, not the
    controller's 12-state prov_run_state_t. Provisioning moved to the controller
    in task 05 and this table wa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
2026-07-31 ui+prov: Rescan button, and "nothing to commission" is not an error
    RESCAN BUTTON. There was no way to force a re-interrogation from the web
    UI — a newly powered ballast only appeared when the background sweep
    reached its address. Added IC_CMD_SCAN, a POST /api/scan route, and a
    per-gateway Rescan button in the Lights tab header (where the ballasts it
    refreshes are listed). Asynchronous on the device, calling the same
    dirty_poll_arm_scan() the `scan` CLI verb uses and for the same reason:
    an interrogation on a populated bus is many seconds, and this arrives on a
    LIVE system where someone may be at a wall switch, so blocking would freeze
    the buttons. The toast says "Scan started" rather tha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
2026-07-31 web: firmware tab could never load — defer its first fetch past mount
    renderFirmware() ended with
    refresh();
    return card;
    and refresh() opens with `if (!card.isConnected) return;`. main.js mounts
    what a tab returns only AFTER the render call returns, so that first
    refresh always ran against a detached node, hit the guard, and bailed. The
    "Loading…" placeholder was never replaced — the tab could not have worked at
    any point, which matches what you saw.
    Now setTimeout(refresh, 0), so the first fetch lands in the next task with
    the card already in the document. The guard stays: it is doing a real job
    for the LATER calls, stopping a slow response from drawing into a tab the
    user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
2026-07-31 web: list all 16 DALI groups per bus, not just populated ones
    There was no way to create a group from the UI. decode.js dropped every
    group the device had not emitted:
    (sd.groups || []).forEach((g, group) => { if (!g) return; ... });
    and a group is only emitted once it has members (lighting_actions.c skips
    empty ones on resync), so the list showed exactly the groups that already
    existed — and DALI has no create step. You make a group by adding members
    to it, which requires the empty one to be on screen.
    The device was already doing the right thing: web_state serialises all 16
    slots per slave, sending null for a group with no members. Only the decode
    threw them away. Null now becomes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
2026-07-31 web: serve all 16 group slots per bus, not up to the highest seen
    You saw 10 groups instead of 32. The device was truncating the array:
    DSUB_GROUPS ran while `cur->i <= group_max(si)`, and group_max returns the
    highest group index ever SEEN. This bus uses G0, G1, G7 and G9, so the high
    water mark was 9 and exactly ten entries were served — groups 10-15 could
    never be reached, and the absent slave 2 contributed none at all.
    The previous commit fixed the UI half (decode.js was dropping nulls), but
    the nulls only existed up to index 9, so the fix could not show what was
    never sent. Now always WEB_GROUPS entries per configured slave, unseen ones
    as null, which the UI already decodes to an emp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
2026-07-31 web: emit all 64 ballast addresses; UI filters with a per-gateway toggle
    The device now reports the DALI address space as it is — all 64 short
    addresses per bus, null where nothing answered — and the Lights tab decides
    what to draw. ballast_max() truncated the array at the highest address that
    had ever answered, which is the same high-water-mark shape that hid groups
    10-15 and the unread relay channels: an array cut at its high-water mark can
    say "nothing here yet" but never "nothing here".
    decode.js keeps the nulls as present:false entries rather than dropping
    them, so the UI has something to filter. It already knew how to draw an
    absent ballast — disabled slider and toggle, "absent"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
2026-07-31 web: hide empty group slots by default, with a toggle to reveal them
    Same treatment the Lights tab got for unused ballast addresses. All 16 slots
    per bus still arrive from the device — that part stays, it is what makes an
    unused group reachable at all — but the tab now draws only groups with
    members by default, behind a "Show all 16 per bus" toggle and an "N empty"
    count.
    The empty slots matter when you are BUILDING a group and are noise the rest
    of the time, which is the same trade as unused ballast addresses: report the
    full space on the wire, decide what to show in the UI.
    One flag for the tab rather than one per bus, unlike Lights. The Groups tab
    is a flat list of "Slave N · Group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
2026-07-31 web: side navigation instead of a scrolling tab strip, plus a Docs tab
    NAVIGATION. Twelve tabs never fitted across the top on any screen, so
    nav.tabs had overflow-x:auto — tabs you could not see and had to discover by
    dragging sideways. Replaced with a vertical list in a sidebar: every entry
    visible at once, permanently on screen from 900px up, and below that an
    overlay drawer opened by a hamburger.
    900px is where 190px of nav plus readable content stops fitting. The drawer
    closes on the scrim, on Escape, and on picking a tab — a panel that covers
    the content needs more than one way out, and on a phone the scrim is easy to
    miss. The header now shows the active tab's name, because with t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
2026-07-31 docs: add the Home Assistant section — discovery topics and entity map
    The Docs tab covered raw MQTT and REST but skipped the layer most people
    actually meet first: HA auto-discovery. Someone reading it would know how to
    publish to <prefix>/dali/3/0/set but not what appears in HA, what it is
    called, or why an entity might be greyed out.
    Transcribed from ha_bridge.c rather than written from memory — the discovery
    topic format, every component/object_id pattern, the device identifiers, and
    the homeassistant/status subscription:
    homeassistant/<component>/<object_id>/config discovery
    homeassistant/status HA birth; we re-publish on it
    Entity table covers lig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
2026-08-04 ha: derive discovery ids from the MQTT prefix so two controllers can coexist
    Discovery object_ids, unique_ids and device identifiers were hardcoded
    "lighting_...", while every state and command topic already derived from
    mqtt_app_prefix(). So two controllers on one broker could be given separate
    topic namespaces and STILL collide: both published discovery to
    homeassistant/light/lighting_dali_3_0/config, the entity's state_topic
    pointed at whichever wrote last, both re-published on every reconnect and on
    homeassistant/status, and identical unique_ids made HA treat them as one
    entity. Slave numbering is per-controller, so lighting_dali_3_0 was
    genuinely ambiguous between two boxes.
    All of it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
2026-08-04 docs: describe what the controller IS; history to DESIGN-HISTORY.md
    Same pass the gateway got. Task numbers, "this used to be", "retired in task
    04" and running commentary on superseded designs are out of the source, and
    into DESIGN-HISTORY.md — which states up front that nothing in it is current
    and that the code wins any disagreement.
    The history file covers: the gateway holding bus state and what moved where,
    the id-ledger queue, every place that predicted state (brightness, on/off,
    relays, group membership, group on/off, commanded_on and its 0.7 s settle
    window), the retained-config warm start, the three high-water-mark truncations
    (relays, groups, ballasts), optimistic availability,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
2026-08-05 docs: describe the protocol as it is, not as it was
    Finishes the sweep started in the TinyModbus repo. Historical detail is
    preserved in DESIGN-HISTORY.md; the main docs now describe only the
    current contract.
    README.md
    - "TinyModbus register contract" rewritten: the gateway caches nothing,
    so the section lists the command queue, controller-owned config over
    raw DALI, group membership via QUERY GROUPS / ADD-REMOVE FROM GROUP,
    and the three action registers. Removed the retired-register
    inventories (0x0000-0x003F arc bank, 0x0040-0x00FF config banks,
    presence/dirty bitmaps, group masks, scan trigger, commission
    register) and the "predictive cache" wording that contradicts the
    m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
2026-08-05 web: clear the slider drag latch on pointerup, not only on change
    The Lights and Groups rows suppress the 1.5 s poll's brightness refresh
    while a drag is in progress, so the poll doesn't yank the thumb out from
    under a finger. The latch was set on pointerdown and cleared ONLY in the
    `change` handler — but `change` on <input type=range> fires only if the
    value actually moved. A tap that lands on the thumb without moving it,
    or a drag released off the track, left `dragging` true for the life of
    the page, and that row's brightness never updated again.
    Symptom was specific and confusing: the on/off toggle kept working (it's
    a separate control, no latch), so a light would audibly switch while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
2026-08-05 cli: `cfg fw_url=` reports that it needs a reboot
    fwupdate.c reads the manifest URL from the intercore snapshot, which core
    0 populates once at core1_launch(). Setting fw_url therefore has no
    effect on core 1 until a reboot — but `cfg` answered a bare "ok", so the
    next `check` polled the OLD url and reported no update available. That
    presents as a broken manifest or a broken OTA server, and cost real time
    on the bench before the cause was found.
    `cfg fw_url=…` now answers "ok (reboot to apply)", matching what `mqtt
    set` and `net set` already do for their deferred fields. Other cfg keys
    are unaffected and still answer plain "ok".
    Also noted in CLAUDE.md, which described the setting with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
2026-08-06 web: live button monitor in the Bindings grid
    A button's index is which of the 8 column inputs it is wired to, not its
    position on the plate — the two orders differ per fitting, which is why
    `Switch wiring.xlsx` carries a "Button order" column at all. Until now the
    only way to learn a plate's indices was to press each button and read a
    serial log, and mistaking position for index reads exactly like an
    off-by-one bug in the scanner.
    Now a press lights its own cell in the Bindings grid, and the card names
    the most recent one ("Last press: Fixture 0 · B1 (click) just now").
    web_state.c keeps a 12-entry newest-first ring of button events rather
    than any notion of "current" button state: a p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
2026-08-06 ha: stop publishing values Home Assistant rejects
    Two defects found by reading the HA container's log rather than the MQTT
    wire — both are silent from the broker's point of view, because the
    payloads are well-formed JSON that HA then refuses.
    1. `release_url: ""` is a schema violation. HA validates the field as a
    URL and an empty string fails, and a schema violation makes it discard
    the WHOLE payload — so installed_version and latest_version never
    reached the update entity and the Firmware card stayed stale no matter
    how often we published. Present on every release since 2026-07-31:
    Schema violation after processing payload '{"installed_version":
    "2.0.1+f9311a9",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
2026-08-08 docs: test rig needs DE mode 'tx' after the transceiver swap
    The rig now has a proper RS-485 transceiver, so 'rs485 always' holds the
    bus driven and no slave can answer — every transaction times out. That
    presents as a totally dead bus, which is an alarming symptom for a
    one-word config setting, so it is worth writing down.
    Measured after switching to 'tx', with the gateway counters zeroed by
    gw_reboot: 3048 frames with 0 rx_overflow / 0 frame_error / 0 crc_error /
    0 internal faults, across two soaks (1300 DALI frames, 2305 Modbus
    transactions, zero failures). Pre-swap the same counters read 8868 frame
    errors and 5162 CRC errors against 29210 good frames.
    Also corrected the rig descripti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
2026-08-08 docs: measure 38400 properly now the transceiver is good
    The old note blamed the ATtiny's RC oscillator for 38400 being
    unreliable. That was right, but it was measured through the bad
    transceiver, which turned out to be the dominant fault by a wide margin
    (8868 frame / 5162 CRC errors against 29210 frames — at 19200).
    Re-ran identical soaks at both rates with the new transceiver and DE in
    tx mode, gateway counters zeroed before each: 19200 gives 0 frame /
    0 CRC errors in 3048 frames; 38400 gives 13 / 14 in 3755. Retries absorb
    them (0 txn failures either way), so 38400 is usable — but the gain is
    narrow, because pacing is 99% 'queue full, DALI-bound'. The user-path
    soak is unchanged (26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
2026-08-09 mbq: follow the gateway to two slots
    Matches TinyModbus MBQ_SLOTS=2. Class depths clamped to fit, with
    background held at ONE slot so a button press always finds the second
    free and waits at most the DALI frame already in flight — letting
    background fill both would put a user command behind two frames, which
    is the inversion the depth cap exists to bound. A _Static_assert now
    enforces both properties against MBQ_SLOTS.
    Deploy order matters: a 2-slot CLIENT is compatible with an 8-slot
    gateway (it addresses a subset of slots and reads a subset of the status
    block), but an 8-slot client against a 2-slot gateway reads past the end
    and gets ILLEGAL DATA ADDRESS. So the controller goes first.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
2026-08-09 ota: an aborted manifest check must say so, and retry
    Every abort path called fw_abort() with no argument and no logging, so a
    check that never happened was indistinguishable from "you are up to
    date" — installed/latest simply kept their old values and the HA card
    looked current. On the bench this hid a broken update path for ten
    minutes across repeated CHECK requests, with nothing in the log at debug
    verbosity; only a reboot cleared it.
    Worse, F.pending is consumed on entry to the check, so an abort DISCARDED
    the request: the next attempt waited out the full FWCHECK_INTERVAL_S
    hour. A single transient lost an hour of update visibility.
    - fw_abort(why) logs the reason and records it.
    - R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
2026-08-09 modbus: close RX frames on t3.5 silence, not on a zero running CRC
    The master completed a response the instant its accumulated bytes
    happened to CRC-validate:
    if (readbuf_crc == 0 && modbus_rx_valid())
    bus_state = MODBUS_RECEIVED_RESPONSE;
    That infers the frame boundary from CONTENT. RTU defines it by SILENCE
    (§2.5.1.1): the frame is over after t3.5, and only then is it validated.
    Two consequences. It never observed t3.5 at all — so of the two ends,
    the master was the less conformant, despite the gateway being the one we
    kept auditing. And a truncated reply whose prefix chanced to CRC-clean
    (1 in 65536 per byte position, gated only by modbus_rx_valid()) would be
    accepted as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
2026-08-09 modbus: disable the RX FIFO so t3.5 measures the wire, not the ISR
    Closing frames on t3.5 silence was measuring "time since a byte was
    DRAINED", which equals "time since a byte ARRIVED" only if the ISR runs
    per byte. It did not. pico-sdk's uart_set_irqs_enabled arms RXIM at a
    4-character threshold:
    // RX asserts when >=4 characters are in the RX FIFO (RXIFLSEL=0).
    // RT asserts when there are >=1 characters and no more have been
    // received for 32 bit periods.
    So during continuous reception the ISR fired every 4 bytes — 2.08 ms at
    19200, LONGER than t3.5 itself (2.005 ms). The main loop saw an apparent
    silence in the middle of a reply and closed the frame there.
    Measured dam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
2026-08-09 modbus: FC65/FC66 transport for the DALI queue
    Adds ACTION_MBQ_ENQUEUE (0x41) / ACTION_MBQ_STATUS (0x42), their frame
    builders and modbus_mbq_enqueue() / modbus_mbq_status(). Matches the
    gateway side in TinyModbus da757d8.
    FC65 tx: dev fc cmd[4] -> 8 bytes on the wire (FC23 sends 17)
    FC66 tx: dev fc -> 4 bytes
    Transport only — mbq_client still uses FC23, so behaviour is unchanged
    until the client is switched over. Committed separately because that
    switch is not mechanical; see the next commit message for why.
2026-08-09 mbq: rewrite the queue client as the v4 per-slave FSM (C1)
    Replaces the v2 FC23 optimistic slot mirror with the queue-v4 transport of
    TinyModbus/QUEUE-PROTOCOL.md: one function code (0x41) carrying an optional
    enqueue plus an optional ack, gateway-assigned sequences, and results retained
    until acked. The FC23 submit/reconcile path is gone entirely — resolve_ambiguous
    and the slot cache with it — because v4's reconcile is rules R1-R4 and nothing
    else, and a dead fallback is a second set of semantics nobody exercises.
    FSM per slave: VERSION -> DRAIN -> BOOT_CHECK -> IDLE <-> AWAIT_REPLY, with
    AWAIT_REPLY's failure edge going to RECOVERY_POLL and, for the ack-less corner,
    on to BOOT_CHECK.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
2026-08-09 mbq: v4 CLI, loss-drill knob and the recovery-rule host test (C3, C4)
    `mbq [slave]` dumps the transport's FSM state, per-command seq binding and the
    §6 counters — reboots split by the rule that noticed them (R2/R3/R4), recovery
    polls, R1 vs R1' outcomes, deadline expiries, A_FULL, LOST/RESULT_LOST.
    `mbq drop-reply <slave> <n>` discards the next n replies inside the client,
    after transport accounting and before resolution, so the §4 paths run for real
    on hardware rather than being simulated. `busload` now also reports the
    bad-CRC discard count.
    test/mbq_client_test.c drives the real FSM against a fake gateway that
    implements the §2 processing order over a real command FIFO and retained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
2026-08-09 mbq: don't count R1's own head movement as a structural anomaly
    R1 deliberately polls with no ack so that a moved head can only mean the lost
    frame's ack was applied — an ack of ours we never saw acknowledged. The
    head-changed-without-our-ack guard was firing on exactly that, flagging every
    successful R1 and making the counter useless as a signal. Skipped during
    recovery, with a regression check in the host test.
    Also: only claim AWAIT_REPLY when a request actually went out. A refusal from a
    full Modbus action queue left the state claiming a transaction that did not
    exist, which blocked submits until the next tick noticed.
    Claude-Ses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
2026-08-09 mbq: arm the version latch, add the backpressure drill and gateway counters
    gw-coder settled the two coordination items: the v4 gateway reports FW_VER 1.0
    and defines 0.x = pre-v4 / MAJOR >= 1 = queue v4, and the §6 counter block is
    FC04 0x0320, exactly 8 registers. So the §8 compat latch's version half is now
    a real refusal rather than an advisory warning — it was only advisory because
    guessing the constant wrong would have silently stopped the controller driving
    every gateway on the bus. Tested in both directions: 0.x refused with its queue
    never driven, 1.0 accepted.
    `mbq no-ack <slave> <n>` withholds the piggybacked ack for n requests, which is
    what validation gate 4 drives: the gat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
2026-08-09 mbq: reconcile the client with the revised spec §4
    The team lead rewrote §4 while stage C was in flight, fixing five defects in
    the recovery design. Reconciling the implementation against the new normative
    text, point by point:
    - The lost-reply procedure now has a pinned EVALUATION ORDER, because R1/R1'
    and R3 can read the same observation and disagree. Implemented as the spec's
    four branches, first match wins: head still holds the acked seq -> R1';
    untracked seq -> R3; EMPTY head -> genuinely ambiguous, resolved by a
    cold-path boot_count read (changed = R3, unchanged = R1); different tracked
    seq -> R1. The empty-head branch is new here and is the common case in
    practice, sinc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
2026-08-09 mbq: one transaction per DALI frame, and terminate every recovery path
    Fixes gate V1's 2.04 transactions per command and the spin that made gate V2's
    counters unreadable. Both turned out to be the same shape of bug: the client
    spending a transaction to ask a question it should have waited for the answer
    to.
    THE PACING FIX, and a spec hole it exposed. §5 now says the client must not
    poll when it cannot enqueue, and §0/§5 say one transaction should both collect
    the oldest result and submit the next command. Those two are not jointly
    satisfiable under §5's other bullet, "in-flight cap = CMDQ_DEPTH (accepts minus
    results)": at the instant that combined request is BUILT the oldest result has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
2026-08-09 mbq: fix the V2 mis-attribution, V4 double execution and the phantom prediction
    Three defects, all found by the reviewers on hardware or in probes, all now
    reproduced as host tests that FAIL without their fix.
    1. GATE V2, THE MIS-ATTRIBUTION — resends did not preserve producer order.
    dispose_tracked() re-queues every disposed command, and drive() then picked
    the one in the LOWEST SLOT, which has no relation to the order the producer
    submitted them. The gateway executes strictly FIFO in accept order, so the
    order the client re-offers IS the order the DALI frames happen in: a reboot
    that disposed a soak SET/QUERY pair could put the SET back on the wire after
    the QUERY, rev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
2026-08-09 mbq: anchor completion estimates at send time, and calibrate them
    The pacing rework hit its transaction target (1.02 txns/command, bus 27%)
    but cost 32% of throughput: 9.9 pairs/s against a 14.7 FC23 baseline, with
    the gateway queue at depth only 21% of the time. One transaction per DALI
    frame is worthless if the frames are further apart.
    Two causes, both in the estimator that gw_occupancy uses to decide when a
    command slot has freed -- which makes it the throughput governor, not the
    advisory poll-pacing hint its comment claimed:
    1. completion_reanchor() anchored at MBQ_NOW_US(), the moment the master
    PARSED the reply. The result was already in the gateway's response queue
    when it bu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
2026-08-09 mbq: stop one gateway reboot cascading into thousands
    A reboot drill lost 225 of 240 idempotent commands and crawled at 3.4
    pairs/s. Two independent runaway loops, both on the reboot path, both
    found by instrumenting the drill rather than by inspection.
    1. R3 re-fired on every leftover result. A reboot leaves the gateway's
    response queue holding results for commands whose bindings we have just
    discarded, and each one surfaces as an untracked head -- R3's exact
    signature. Every firing disposed the healthy work that had replaced the
    disposed commands, whose results were then themselves untracked. Self
    sustaining: MEASURED 3801 R3 firings and 959 commands lost from ONE real
    r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
2026-08-09 mbq: close the last gate-V2 value errors — three causes, all on reboot
    The reboot drill's residual "one bad query per reboot" was three separate
    defects wearing the same signature. All value errors are now zero across a
    six-run sweep; the only remaining "bad" is an honest RESULT_LOST.
    1. R2 kept a command that was NOT the oldest. note_reboot('2', c) keeps the
    command whose accept byte revealed the reboot -- but the gateway has
    already accepted it, so it is first in the new epoch's FIFO while every
    disposed command is re-offered BEHIND it. When the soak's QUERY was the
    one kept, its paired SET was resent behind it, the query ran first and
    read the DTR0 the PREVIOUS pair left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
2026-08-09 history: record the v2 slot mirror and why v4 removed it
    The entry stopped at 'v1 was an id ledger, replaced by self-describing
    slots'. Adds what v2 cost (FC23 forces the master to name the slot, so
    every DALI frame bought a poll it could not use: 1.73 txns/command, 99%
    bus) and what v4 changed (gateway picks the slot, results retained until
    acked: 1.03 and 37%). Notes that the optimistic slot mirror — the thing
    task 04 spent three fix cycles reconciling — is gone entirely, along with
    resolve_ambiguous and 'idle means gone'.
    Also records the deletion of docs/modbus-command-queue.md, and the
    bring-up lesson: three defects had a clean verdict at full throughput
    while being badly wrong, so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
2026-08-09 docs: bring the controller's README and CLAUDE.md up to queue v4
    README.md described the retired FC23/v2 design in every section that touched
    the command queue: an 8-slot register block at 0x1000/0x1010, a per-slot
    lifecycle mirror, "idle means gone" reboot detection, FC23 submit lengths, and
    a cross-reference to docs/modbus-command-queue.md (the v2 slot spec, now
    deleted). All of that is replaced with the v4 model, pointing at
    ../TinyModbus/QUEUE-PROTOCOL.md as the normative spec:
    - one FC 0x41 per transaction, enqueue + ack in one frame, results retained
    until acked, sequences assigned exclusively by the gateway;
    - the pacing requirement, which is what delivers one transaction per DALI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
2026-08-09 docs: delete the standalone v2 slot-protocol spec
    docs/modbus-command-queue.md specified the generic self-describing SLOT
    pattern — eight slots, a per-slot [status:8|response8:8] register, master
    names the slot it writes. Queue v4 replaced all of it: the gateway picks
    the slot, results are retained until acked, and the whole exchange is one
    user-defined function code with no registers involved. Nothing in the
    document survives except the DALI-agnosticism, which QUEUE-PROTOCOL.md
    states itself.
    Its last three references are gone (README.md, dali_queue.h, and the
    gateway README), and TinyModbus/QUEUE-PROTOCOL.md is normative for both
    halves. Recorded in DESIGN-HISTORY.md so the deletion is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
2026-08-12 mbq: A_FULL is flow control; delete the completion estimator
    User decision 2026-08-12: the gateway is the authority on its own queue.
    The client offers a command and is told yes or no, instead of predicting
    how full the gateway is.
    Deleted: est_ms(), completion_reanchor(), oldest_done_at(), cmd_t.est_done_us,
    the EST_* constants and the poll_at_us gate — the whole apparatus that timed
    each command by class (~26 ms SET / ~38 ms query) to guess when a gateway slot
    had freed. gw_occupancy() goes with it; admission is now bounded only by
    having a local slot to track the command in, which is real bookkeeping rather
    than a guess. A_FULL is logged at DBG and re-offered on the next transaction.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
2026-08-13 soak: the probe could never hold more than 2 commands — every rate number was measured through that
    THE INSTRUMENT WAS THE BOTTLENECK. dq_soak clamped `depth` to CMDQ_DEPTH (2)
    and allocated from a pool of CMDQ_DEPTH+1 (3) records, with rec_alloc()
    scanning only 3 slots. So `soak ... depth=4|8|16` all silently ran at 2, the
    controller's queue was always empty, and every transaction after the first had
    nothing to attach and went out as a bare poll.
    That put a floor of ~2.7 Modbus transactions per DALI command into every
    measurement taken with this probe, and it invalidated task 08 gate V1's "depth
    sweep {1,2,3}", which ran at depth 2 three times over. It is also why six
    successive client-s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
2026-08-13 mbq: accepting a command and transmitting it are different jobs
    Adopts Bruce's loop shape. The client already reached zero bare polls via the
    two-phase ordering and sizing in a380a18, but by accident of arrangement
    rather than by design — the API still coupled "will you take this command" to
    "is the bus free right now".
    mbq_client_can_submit() is now ROOM IN THE QUEUE and nothing else. Not the
    wire, not the recovery state machine, not how full
    the gateway is (the gateway answers that with
    A_FULL). A transaction lasts ~12 ms and the
    controller runs ~340 loop passes inside one, so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
2026-08-13 mbq: separate the queue from in-flight — two knobs, two meanings
    The last piece of Bruce's structure. Capacity was ONE number holding both
    things, so "how much backlog do we keep?" and "how deep is the gateway?" could
    not be answered independently — and in-flight work could fill the array,
    leaving the transmission loop nothing to attach and sending a packet with no
    command in it.
    MBQ_QUEUE_DEPTH the QUEUE: accepted from a producer, not yet offered.
    OUR policy — how much backlog we hold so the loop always
    has something to attach.
    MBQ_INFLIGHT_MAX IN FLIGHT: at the gateway or on the wire. NOT policy and
    not enforced here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
2026-08-13 mbq: one staging slot — a deep client queue only buys latency
    Bruce's correction, and he was right twice over.
    MBQ_INFLIGHT_MAX was never a knob: at most CMDQ_DEPTH sit at the gateway
    (it says A_FULL beyond that) plus one on the wire. It is how many we must
    REMEMBER, not a policy. Documented as derived.
    The staging queue was the real error. dali_queue already holds the backlog
    SORTED BY PRIORITY; a command staged in mbq_client has left that ordering
    behind — committed, FIFO, un-overtakeable. So every staging slot past the
    first is a DALI frame added to the next button press. I had set it to 4 and,
    worse, let background hold 3 of them (DQ_DEPTH_BG = QUEUE_MAX-1), which is
    precisely the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
2026-08-13 dali_queue: bound background to one gateway slot
    DQ_DEPTH_BG was CMDQ_DEPTH (2), which contradicted the file's own design
    note directly above it: "background may occupy only ONE of the gateway's
    command slots, bounding that inversion to one frame time". At 2 a button
    press could sit behind two background DALI frames in the gateway's strict
    FIFO, roughly 76 ms of priority inversion.
    Measured on the bench, USER-priority latency under saturating background
    load (MQTT publish to confirmed read-back state, n=23):
    before median 241 ms p90 254 ms
    after median 189 ms p90 202 ms
    Background throughput drops to about 0.6x, which costs a few seconds on
    the boot scan and nothing at al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
2026-08-14 mbq_client: rotate the drive order, so a second gateway cannot starve
    have_free_slot()'s comment already states the design assumption: "With
    several gateways the round-robin supplies the spacing for free — by the
    time the master comes back to a slave, it is more likely to have room."
    There was no round-robin. mbq_client_drive() scanned from index 0 every
    pass. Transactions serialise on one wire, so when the low-index slave's
    reply lands both slaves are free at the same instant and a fixed scan
    hands the wire straight back to the same one. Under saturation it always
    has an offer to make (A_FULL is re-offered immediately), so it never
    yields and the higher-indexed gateway never transmits.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
2026-08-14 modbus: the bus asks for work instead of being pushed at
    Queues were driving queues. A command passed through dali_queue's priority
    rings, mbq_client's per-slave slots, a 256-deep FIFO in the transport, and
    the gateway's own 2-deep queue. The third of those earned no keep: every
    caller is on core 0 (core 1 reaches core 0 through ic_cmd_t, never the
    transport), so it was sized for a cross-core problem it does not have.
    Worse, it DISCARDED PRIORITY. The queue is FIFO, so once an action was in
    it the order was fixed and a button press could sit behind a background
    read committed microseconds earlier. dali_queue does careful work to rank
    commands; that ranking was thrown away one layer down.
    T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
2026-08-14 38400 canonical, with a fallback walk; fold away the dead rotation
    CANONICAL BAUD IS NOW 38400. DEFAULT_BAUD_RATE, the config default and
    bus_discovery's BAUD_FAST all move together.
    bus_discovery's header carried the reason 19200 was canonical: "the
    ATtiny's internal-RC-oscillator RX sampling is marginal at 38400 —
    confirmed on the Saleae: clean frames on the wire, but the gateway
    mis-frames bytes and fails CRC under load". The OBSERVATION was exactly
    right and the DIAGNOSIS wrong — "clean on the wire but mis-framed by the
    receiver" is the signature of a tinyAVR silicon erratum in the USART
    start-of-frame detector, not the oscillator. Scoped: both ends transmit
    within 0.8 % of nominal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
2026-08-15 measure_cmdpath: land the command-path harness, with an honest denominator
    The review's scratchpad script, parameterised (--port/--slave/--addr) and made
    repeatable: four windows (idle / scan / user+verify / saturated soak), each
    reporting transactions per DALI command and the busload read immediately after
    the window closes.
    The one change of substance is the denominator. Dividing transactions by
    ENQUEUES counts an A_FULL refusal as a command, so any change that converts
    polls into re-offers — which is what raising a queue depth does — reads as an
    improvement while the bus does exactly as much work as before. The ratio now
    divides by commands that reached a terminal outcome (the client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
2026-08-15 cfgq: run the five field queries as a rolling window of two
    The config rotation asked its five independent fields strictly one at a time,
    so like the sweep beside it the queue was empty at every collect moment and the
    transport had to spend a bare poll. No field's opcode depends on another's
    answer, so the next is submitted as the previous lands and the collect rides
    the enqueue.
    Two, not five: the real backlog belongs to the priority ladder in dali_queue,
    and a third field staged here would only sit in front of a button press.
    Bookkeeping: per-field query records, each with its own token and its own
    deadline, replacing the single in-flight slot — two are live at once and either
    may be a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
2026-08-15 dali_queue: let a scan raise the background depth, and only a scan
    DQ_DEPTH_BG = 1 (dd83279) bounds a button press's inversion to the single DALI
    frame already executing, and that is right for the steady state. It also means
    background work runs one command per round trip — the gateway's DALI engine
    finishes a frame and idles while the master collects the result and enqueues
    the next — which is most of what makes a full interrogation scan take 3.4 s and
    hold two thirds of the RS-485 bus. The producer windows in dali_state and cfgq
    cannot ship their second query while a background command is outstanding, so
    they need this to do anything at all.
    dq_set_bg_burst(slave, on) raises that slav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
2026-08-15 mbq_client: a NAK is not a loss — give it its own counter
    `deliver()`'s switch caught MBQ_R_NAK in the `default:` arm, so every clean
    "the gear did not answer" was charged to `stats.lost`. On the bench's 2-of-64
    bus that is ~62 phantom losses per interrogation scan, and most of the
    lost=1106 sitting in `mbq 3` — the counter that exists to say "a reboot ate
    work" was reporting empty addresses instead.
    NAK gets `stats.naks`. Nothing else moves: the terminal delivered to the
    producer is still MBQ_R_NAK, dali_queue still maps it to DQ_RES_NAK, and the
    wire is untouched.
    measure_cmdpath.py's RES_RE has to learn the new field or its command
    denominator quietly drops every NAK and inflates tx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
2026-08-15 mbq_client: a written-off link fails fast instead of running the ladder
    An absent gateway turned dali_state's 5 s liveness probe into an 8-second
    recovery saga, forever. The probe is a QUERY through the full queue path; the
    transport's absent-slave backoff completes its enqueue instantly as a timeout;
    the client cannot distinguish that from a lost frame, so it runs §4 — recovery
    polls, four `recovery_give_up` requeues, CMD_MAX_LIFE_MS, LOST. Per probe:
    ~5 WARN lines, an mbq slot and a dq pending record held 8 s, and `lost` growth
    (1106 on the bench, burying real losses). Bus cost zero; observability cost
    total.
    The client now writes a link off once it has been DECLARED down
    (c_consec_fai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
2026-08-15 modbus: the absent-slave backoff says it once, not once a minute
    The transport is the layer that owns the down/up transition and it already
    prints both halves — so mbq mirrors it rather than duplicating it (previous
    commit). That only pays off if the transport's own lines are actually per
    transition, and two of them were not:
    "slave N unresponsive — backing off M ms" re-fired on every re-trip, i.e.
    every time the periodic probe found the slave still absent. At the 60 s
    ceiling that is one WARN a minute per absent slave, forever.
    "rx timeout slave=N fc=0xNN (gave up)" fired for the probe too, doubling it.
    Both keep their text and drop to LOG_DBG once the backoff owns the slave;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
2026-08-15 comments: retire the FC23/estimator/submit-window narration
    The queue rework (tasks 04-09) left load-bearing comments describing
    machinery that no longer exists. In this codebase comments ARE the design
    record, so a stale one is a landmine. Comments only — no behaviour change,
    proven by an identical `arm-none-eabi-nm --size-sort` against main.
    - dali_queue.c dq_tick: can_submit does NOT mean "no transaction in
    flight" any more, so it is not what bounds the tick to one command per
    slave. ship_ladder returning after one ship is, and the per-class
    depths bound what may be outstanding.
    - mbq_client.h: the same false claim on can_submit's own declaration, plus
    mbq_client_submit "issues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
2026-08-15 includes: drop four that no file uses
    clangd flags these as unused direct includes, and grepping each header's
    symbols against its file confirms it: dq_soak.c and dali_queue.c print
    only through cdc_out.h, modbus.c calls no ctype function, and
    dali_commission.c touches nothing from config.h. Object code is unchanged
    (identical `arm-none-eabi-nm --size-sort` against main).
    Header-in-header includes are deliberately untouched — mbq_client.h in
    dali_queue.h, for one, is there for the MBQ_QF_* aliases and clangd's
    "not used directly" is wrong about the intent.
    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
2026-08-15 test: subscribe to the LWT that exists — <prefix>/availability, not bridge/status
    The harness checked lighting/bridge/status, the retired external
    bridge's topic, so the controller's device-level availability read
    MISSING on every run — indistinguishable from a real LWT regression.
    The firmware's LWT is lighting/availability (mqtt_app.c).
    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
2026-08-16 bootloader: a retried commit can't blindly redo the backup copy
    try_commit_staging() backed up the outgoing active image into BACKUP
    whenever bc_has_valid_backup() was true, unconditionally. But a commit can
    be interrupted after the staging->active copy finishes (and even
    re-verifies) but before main()'s deferred bc_write() persists
    BC_F_PENDING's clear. On the retry boot, BC_F_PENDING is still set,
    STAGING/staged_len are unchanged, and boot_decide() sends this function
    through the exact same path again -- except ACTIVE already holds the
    candidate, not the old outgoing image the backup step assumed.
    Verifying ACTIVE against backup_len before backing it up does not close
    the hole: when the o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
2026-08-16 ota: a PENDING|CONFIRMED record can't commit safely, so stop making one
    Two halves of the same hole, both reachable without any deliberate
    misuse:
    1. ota_stage_confirm() (src/ota_stage.c) ORed BC_F_CONFIRMED onto
    whatever record bc_read() returned, including one that still had
    BC_F_PENDING set. That's reachable in practice: ota_poll()'s 30 s
    healthy-boot confirm one-shot (src/net/ota.c) runs unconditionally
    every tick, independent of the download state machine, so it can fire
    in the same window as ota_succeed() pushing IC_CMD_REBOOT after a
    brand-new install finishes staging -- controller_reboot() takes on the
    order of ~350 ms to actually take effect, and IC_CMD_OTA_CON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
2026-08-16 net: jfind returning the last token's index reads one past the array
    jsmn_parse can fill the fixed-size token array exactly, so when the
    matched key happens to be the very last token, jfind's `i + 1` return
    points one past the array end. Callers dereference it unchecked, and
    jint()'s length clamp only bounds the *upper* end of `t->end -
    t->start` — garbage from out-of-bounds memory can yield a negative
    length, which becomes a huge size_t in memcpy. That's a remotely
    triggerable core-1 crash from any MQTT set topic or authenticated
    POST /api/*.
    Fix jfind in both src/net/ha_bridge.c and src/net/http_server.c to
    return -1 when the value token would be out of range, and add a
    negative-length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
2026-08-16 dali_queue: dq_submit_sync's blocking wait never feeds the watchdog
    dq_submit_sync()'s wait loop polls modbus and ticks the queue but
    never touches the watchdog, unlike every other core-0 blocking wait
    (cli_mb_wait in serial_protocol.c, wait_done in bus_discovery.c).
    Long CLI-driven chains built on it — dali_read_mem chains up to ~193
    of these, cmd_blink similarly — can run past the 5 s watchdog against
    a slow or dead gateway and reboot the controller mid-command.
    Feed with wd_feed() inside the loop, same as the other two blocking
    waits. wd_feed() already encodes the core-0-feeds-only-while-core-1
    is-alive policy (main.c), so this stays uniform with the rest of the
    codebase without re-i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
2026-08-16 mapping: mapping_save is not power-cut-safe
    mapping_save() opened /mappings.json with "w" and rewrote it in
    place, destroying the old table before the new one was durable. A
    power cut mid-write truncates the file, and mapping_load() then
    parses the survivors with no fallback — this is the exact
    silent-binding-loss failure the line-delimited JSON format was
    adopted to eliminate (CLAUDE.md "Persistence (2026-06-07)"); the
    old raw fwrite() of mapping_record_t had the same in-place-rewrite
    hole alongside its layout fragility.
    Write the full new table to /mappings.json.tmp, fflush+fclose it
    (pico-vfs's littlefs backend has no separate fsync(); fclose()
    reaches lfs_file_close(), which syncs to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
2026-08-16 cfg: make dali_slaves/relay_slaves rewrite reboot-to-apply, not live
    cfg dali_slaves=/relay_slaves= wrote straight into g_config's live
    relay_slave_ids/dali_slave_ids arrays, but consumers bind slave_id -> array
    index once at boot (dali_state.c, dirty_poll.c, dali_queue.c each keep their
    own frozen slave_id/idx table) while state_cache_slave_idx() recomputes the
    index live from those same arrays on every call. A live rewrite made the
    frozen tables and the live lookup disagree mid-session: after `cfg
    dali_slaves=3` on a {2,3} device, state_cache's index for slave 3 became 0,
    so emit_state_dali published slave 2's cached data under slave 3's identity
    while dirty_poll kept polling the now-remov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
2026-08-17 modbus: cfg baud= now reaches the UART, not just the persisted config
    modbus_set_baud() (modbus.c:486) set s_baud and persisted g_config.baud but
    never called modbus_uart_set_baud_runtime()/uart_set_baudrate(), so `cfg
    baud=` (CLI) and the JSON/HA set_cfg baud key changed the reported rate and
    the live timing constants derived from s_baud (t3.5, the DE-release alarm,
    deadtime) while the hardware UART kept clocking the old rate — every
    subsequent transaction was framed at the wrong speed. Only the dedicated
    `baud` CLI verb got this right, by calling modbus_uart_set_baud_runtime()
    itself before modbus_set_baud().
    Fix: fold the runtime UART change into modbus_set_baud() itself, so every
    call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
2026-08-17 serial_protocol: an over-long CLI line ran its overflow tail as a command
    serial_poll()'s overflow branch only reset line_pos to 0 on a too-long line;
    the comment said "overflow — discard" but nothing actually discarded the
    rest of the line. The buffer immediately started refilling from offset 0, so
    whatever bytes followed the overflow point — the tail of an over-length
    paste, everything after the point it stopped fitting — got buffered as its
    own line and dispatched through handle_line() at the next newline. A big
    paste (or anything else that overflows SERIAL_LINE_MAX, 256 bytes) could
    therefore execute a command drawn from the middle of a line nothing meant to
    run standalone.
    Fix: a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
2026-08-17 mbq_client: bound S_BOOT_CHECK against a persistently exceptioning sysinfo read
    A Modbus exception is still an answer, so mbq_modbus_cb only counts a genuine
    no-reply (res == 0) toward c_consec_fail/link_down. That left S_BOOT_CHECK's
    sole exit, "if (down) bootchk_give_up(s)" in resolve_failure, unreachable for
    a gateway that answers the FC04 0x0310 sysinfo read with a persistent
    exception (e.g. a register-map skew while still reporting version >= 1.0, so
    resolve_version's compat latch never fires either) — the slave parks in
    S_BOOT_CHECK forever, re-issuing the read every PACE_FAIL_MS with the whole
    command path stalled behind it (drive() returns from the S_BOOT_CHECK case
    before any comm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
2026-08-17 mbq_client: only spend the no-ack drill's budget on a real withheld ack
    issue_queue_txn (mbq_client.c) always calls issue_queue_txn_acked with
    with_ack = true, so every transaction to a slave with withhold_acks > 0
    decremented the budget — including requests where s->ack_pending was already
    0 (the very first command of a run, or any request issued right after a
    reply had just cleared ack_pending). For those, ctl's ack field comes out 0
    whether with_ack is forced false or left true, so the decrement withheld
    nothing at the gateway: `mbq no-ack <slave> <n>` could burn through its whole
    budget without the gateway's response queue ever filling, and a short drill
    could read clean on gate V4 (QU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
2026-08-17 dq_soak: gate the direct-path depth sweep on gateway-held commands, not client occupancy
    dq_soak.c's direct-path gate (dq_soak_tick, ~:358) compared `depth` against
    occupied = mbq_client_inflight(S.slave) with `>`. mbq_client_inflight()
    counts every non-FREE client slot — a command staged but not yet sent
    (MBQ_QUEUE_DEPTH), one sent but whose accept byte hasn't arrived, AND one
    accepted by the gateway — not just what the gateway holds. Because the
    MBQ_QUEUE_DEPTH staging slot stays topped up between transactions, "occupied
    > depth" only closed once a command was ALSO staged behind the `depth`
    already-accepted ones, so a depth-N sweep actually ran the gateway at N+1
    outstanding the whole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
2026-08-17 net: fix stranded socket-0 state after a lend revoke, and a perma-stuck arbiter
    Two related defects in the socket-0 lending path (netif <-> http_server <->
    ping/ota/fwupdate).
    (a) http_server_tick() revoke handling: when netif drops
    netif_web_sock0_enabled() (DHCP renewal due, or the ping/ota/fwupdate arbiter
    took socket 0), the tick loop only cleared s_sock0_active and stopped pumping
    s_conn[N_BASE] — arm_listen() (the only place s_logbuf_owner is cleared) never
    ran for that slot. A connection that owned the /api/log snapshot at the
    moment of revoke left every later GET /api/log answering 503 until a loan
    happened to land on that same connection again, which could be a long wait or
    (per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
2026-08-17 ha_bridge: drain intercore events into web_state during the discovery burst
    ha_bridge_tick() ran the discovery burst (disc_step(), DISC_BATCH=6/tick) and
    returned without ever reaching intercore_pop_event() for as long as
    s_disc_active held — the full burst is ~1380 steps, so ~230 ticks, and it
    re-runs on every reconnect and every homeassistant/status=online. Core-0
    events piled into the 512-deep intercore queue for the whole burst (dropped
    past that, counted in intercore_event_drops) and web_state_on_event never
    ran, freezing the config web UI for the duration — contradicting the
    documented contract (README "Config Web UI") that web_state is fed from the
    same drain in both the connected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
2026-08-17 ha_bridge: delete the dead IC_EVT_PRESENCE arm and its translation plumbing
    ha_bridge_publish_event's IC_EVT_PRESENCE case published up to 128 retained
    availability topics in one synchronous pass with no TX gating — the sweep
    cursor (sweep_step(), scan_complete) exists precisely to avoid this pattern
    for the same 64-per-slave availability set, batching SWEEP_BATCH per tick
    behind mqtt_app_tx_free(). But the arm is unreachable: nothing ever
    constructs a LEVT_PRESENCE event to translate into it.
    Verified with grep: LEVT_PRESENCE was declared (lighting_actions.c,
    serial_protocol.c — two independent copies of levt_t, per the "In a real
    project these would share a header" comment) and transl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
2026-08-17 net: rename the socket-0 arbiter to reflect ping/ota/fwupdate, not just ping
    netif.c's s_ping_sock0 / netif_ping_acquire_sock0() / netif_ping_release_sock0()
    were named for their original sole caller, the CLI network ping (ping.c,
    IPRAW/ICMP, held ~1 s). ota.c and fwupdate.c later grew onto the same
    arbiter for their own socket-0 needs without a rename: ota.c holds it for a
    whole signed-firmware-image HTTP GET (minutes, not seconds), fwupdate.c for
    a single small manifest GET (bounded ~10 s). The netif.c comment at the flag
    declaration still justified the design with "ping taking priority for the
    ~1 s it runs" — true of ping alone, false of what the arbiter now actually
    gates, and misleadi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
2026-08-17 ota: check image-download HTTP status; stop losing the post-install reboot
    FIX 1: the image fetch (ota.c OS_DOWNLOADING) streamed the response body
    into STAGING regardless of HTTP status, unlike the manifest path
    (fwupdate.c's FS_FETCHING). A 404/500 error page got staged, burned an
    erase/write cycle, and came back through ota_stage_finish()'s fw_verify()
    as OTA_VERIFY_FAIL — reported (once anything was reported at all) as "bad
    signature" instead of the true cause. httpc_status_code() is now checked
    every OS_DOWNLOADING tick, before O.fill/done are ever inspected, so a bad
    status is caught the same tick the header completes and aborts before this
    phase ever reaches the flush-to-core-0 bran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
2026-08-17 ota_stage: invalidate a stale PENDING record before ota_stage_begin() touches STAGING
    FIX 2 (part 2 — see the previous commit for the IC_CMD_REBOOT retry that
    closes the common path into this window). ota_trigger() only refused a new
    job while OTA_RUNNING, so a re-trigger during the post-success pre-reboot
    window could still reach ota_stage_begin() while boot-control's PENDING
    record still names the fully-verified previous candidate sitting in
    STAGING. If that second download then failed after ota_stage_write() had
    already begun erasing sectors, boot-control was left pointing BC_F_PENDING
    at a STAGING region that no longer held the image it claimed to — the
    bootloader's try_commit_stagin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
2026-08-17 main: keep the bootloader's watchdog armed through the early-init hang window
    FIX 3. main() unconditionally cleared watchdog_hw->scratch[2] and disabled
    the bootloader's 8 s watchdog-armed-jump (bootloader/main.c HARDENING #2)
    as the very first thing in main() — before cdc_out_init/stdio_init_all/
    alarm_pool_init_default/pico_led_init, the fixed 2.5 s USB-enumeration
    busy_wait_ms, and above all intercore_init()+core1_launch(). Our own 5 s
    watchdog only armed later, at the point discovery needed protecting. That
    left the whole stretch in between running with NO watchdog live at all:
    the bootloader's was just switched off, ours hadn't started yet.
    Both documented hardware hang classes (boot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
2026-08-17 bootloader: factor commit/rollback into commit.c; add boot_commit_test.c
    FIX 5. Nothing exercised try_commit_staging()/try_rollback() as a SEQUENCE
    across boots — both real power-cut bugs this design has had (the
    commit-retry backup clobber fixed by 9620301's trailer gate, and the
    PENDING|CONFIRMED persist fixed by ae1f661) live exactly in that
    sequencing, not in boot_decide()'s pure decision table that
    boot_decide_test.c already covers exhaustively.
    Factored bootloader/main.c's try_commit_staging(), try_rollback(),
    flash_copy_region(), and the orchestration main() ran between boot_decide()
    and the jump (the COMMIT_STAGING/ROLLBACK dispatch + the shared "about to
    boot ACTIVE" bc_write() s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
2026-08-17 config: config_save is not power-cut-safe
    config_save() opened /config.json with "w" and rewrote it in place,
    destroying the old config before the new one was durable. A power cut
    mid-write truncates the file, and the tolerant jsmn parse in
    config_load() softens the blast radius (missing/malformed fields fall
    back to compiled defaults) but doesn't eliminate it — whatever fields
    were cut off silently revert to defaults on next boot, including
    mqtt/network config, which bricks connectivity until physical access.
    Apply the same fix as mapping_save() (cc19f7b): write the full config
    to /config.json.tmp, fflush+fclose it (the pico-vfs littlefs backend's
    actual durability boundary, since it has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
2026-08-17 mapping: clamp serialise_targets' snprintf accumulator
    serialise_targets() did `p += snprintf(buf + p, size - p, ...)` in a
    loop with no clamp on p. snprintf returns the length it WOULD have
    written, not what actually fit, so once the buffer fills p can exceed
    size — the next iteration's `size - p` (size_t, per snprintf's
    signature) then underflows to a huge value, and snprintf believes it
    has that much room to write into.
    Unreachable today: worst case is ~202 of tbuf's 256 bytes
    (MAX_TARGETS_PER_BTN-bounded). But that headroom is accidental, not
    guaranteed — raising MAX_TARGETS_PER_BTN past ~10 turns this into a
    stack smash in the persistence path. Clamp p to size after each
    snprintf c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
2026-08-17 docs: queue-client doc truth — A_FULL, epoch_clean, callback contexts, estimator, LINK_DOWN_FAILS
    Several comments in the queue-v4 client stated a retracted or never-true
    design as current fact. Fixed each against QUEUE-PROTOCOL.md and the real
    call graph:
    - mbq_client.h's CMDQ_DEPTH comment and dali_queue.c's scheduler-depth
    comment both still said "the cap is the flow control — A_FULL is only the
    backstop" (the pre-v4 story). Since the 2026-08-12 decision (spec §5),
    A_FULL IS the flow control: the client has no in-flight cap and submits
    until refused. Mirrors the language TinyModbus's cq.h/cq.c/registers.h
    already carry (commit 1848f84).
    - epoch_clean: a per-slave bool wri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
2026-08-17 docs: retire the bridge/mqtt_bridge.py and core1-stub references
    ha_bridge.c/.h opened by saying they "reproduce mqtt_bridge.py" — true when
    that Python host still existed, false since the 2026-06-09 on-board MQTT
    bridge rewrite retired it. Reworded to describe what these files are directly,
    pointing at controller/CLAUDE.md's "On-board MQTT bridge" section instead of a
    file that no longer exists.
    ha_bridge.c's IC_EVT_FAULT case cited the same dead file to justify publishing
    no MQTT topic for it. Checked what the event actually carries before writing
    a new comment: {slave, addr, lamp_fail, power_cycle}, consumed by the web
    UI's read model (web_state.c sets S.ball[].lamp_fail from it) but w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
2026-08-17 refactor: remove dead code — retired JSON CLI surface, levt_t duplication
    serial_protocol.c: json_str/json_int/json_bool/json_uint8_array/parse_targets
    and now_ms_u had no reachable caller. handle_line() has dropped any '{'-
    prefixed line unconditionally since the JSON CLI surface was retired (core 1
    owns MQTT/JSON now — see the file header); the only callers of this cluster
    were each other, and parse_targets (the only real consumer of json_int/
    json_str) fed the JSON mapping-target parser that dropped with it. now_ms_u
    had no caller at all. Left parse_csv_u8 alone — it's the live CLI comma-list
    parser (`cfg dali_slaves=2,3` etc.), unrelated to the JSON cluster it
    happened to sit next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
2026-08-17 serial_protocol: replace the CLI's strcasecmp chain with a dispatch table
    handle_text_line was a ~39-branch strcasecmp chain and cmd_help spelled out
    the same verb list by hand — the two had already drifted (cmd_cfg accepted
    gw_diag_interval_ms/dali_sweep_interval_ms/relay_byteswap that help never
    mentioned). Replace both with one static cli_commands[] table of
    {verb, handler, help-text} driving dispatch and `help` from a single source.
    dstate/resync had no named handler (inlined in the old chain); gave them one
    each (cmd_dstate/cmd_resync) so every entry is a plain function. cmd_help and
    cmd_reboot are void-arg handlers; wrapped (cmd_help_v/cmd_reboot_v) rather
    than changed, per the rest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
2026-08-17 ha_bridge: dedup discovery builders' shared device blocks
    Eight-ish discovery builders shared a six-line skeleton (payload snprintf ->
    ids/name/via snprintf -> dev() -> objid snprintf -> pub_cfg()) with only the
    literals differing, plus the controller-device JSON literal
    (",\"device\":{\"identifiers\":[\"%s_controller\"],...") was copy-pasted 6x
    (disc_controller's 3 branches, disc_system_reboot, disc_fw_update,
    disc_fw_check). Extends the file's existing PROV_TAIL/GWD_TAIL precedent
    (the gateway device) to the other three device shapes actually shared by
    more than one builder:
    - dev_plate(n, fix) — switch-plate device: disc_plate_event,
    disc_plat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
2026-08-17 fw_image: centralise the trailer-extraction idiom; bootloader tidy; fix stale test comment
    (a) memcpy(&t, base + (len - sizeof t), sizeof t) was open-coded ~5x:
    fw_image.c's own fw_verify(), ota_stage.c, bootloader/commit.c (in
    try_rollback(), after the commit.c refactor moved it out of
    bootloader/main.c), and three spots in test/boot_commit_test.c plus one in
    test/ota_stage_test.c. Added fw_trailer_at(base, total_len, out) to
    fw_image.h/.c, centralising the total_len < sizeof(trailer) underflow guard
    in one place; fw_verify() itself now calls it instead of open-coding the
    guard+copy, and every other site above was switched to call it too (the
    three call sites past an already-successful fw_v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
2026-08-17 retire the xlsx→HA workflow: HA is now the single source of truth
    tools/xlsx_to_ha.py and test/dali_xlsx_sync.py pushed Switch wiring.xlsx into
    Home Assistant one-way. That workflow is superseded by the lightswitch_mapper
    HA integration (names, positions, button orders, bindings all live/edit in HA
    directly) plus mapper/tools/export_mappings.py for read-only spreadsheet
    snapshots. Switch wiring.xlsx stays in the repo as frozen wiring documentation
    (matrix wiring, button wiring order) only. Updated every reference in
    CLAUDE.md and README.md; dropped the now-unused openpyxl test dependency.
2026-08-17 test/run_tests.py: match the current bench rig (slave 3, not 2)
    Slaves 1-2 are configured but absent (CLAUDE.md "Test rig wiring") — only
    slave 3 is on the bus. DEFAULT_SLAVE and the module docstring described a
    two-device slave-2 rig that no longer exists. Also default --capture-baud to
    38400 (canonical bus speed, per CLAUDE.md "RS-485 baud") — a capture set to
    the old 19200 default decodes Modbus garbage against the real 38400 traffic.
2026-08-17 dali_inventory.py: adaptive drain instead of flat sleep; stop swallowing IndexError
    (a) cmd() slept a fixed `wait` then did one read, so --all (64 addresses x 8 s
    each) takes ~8.5 min regardless of how fast the gateway actually answers, and a
    reply landing right at the sleep boundary got truncated into a bogus
    "absent"/"?" row. Replace with an adaptive drain (pattern from
    test/measure_cmdpath.py's Rig.drain): extend the deadline while bytes keep
    arriving, stop once it's quiet. Same `wait` values at each call site, but now
    they're a cap, not a fixed cost.
    (b) `except IndexError` around main() existed only to catch the serial-port
    glob's `[0]` on no device found — but it would just as happi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
2026-08-17 ha_e2e.py: exit nonzero on failure, dedupe the two round-trip loops
    (a) The script always printed a summary and exited 0 regardless of outcome —
    sys was imported but unused. Now exits 0 only if every round trip completed
    AND all three availability topics read "online" in the baseline, so this can
    gate a release instead of needing its output eyeballed.
    (b) The brightness-targets loop and the OFF/ON loop were copy-pasted and had
    already drifted (append-then-print vs print-then-append). Extracted a single
    round_trip(label, payload, matches) helper with one drain+wait+record
    implementation.
    (c) '%.3f s' % got inside f-strings -> f"{got:.3f} s".
    (d) Broker IP is now overridable via argv[1] (def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
2026-08-17 build: prove the ioLibrary patches landed instead of hoping they did
    The two build-time submodule patches sat entirely outside the build graph,
    and their failure mode was silent in two different ways.
    First, nothing listed them as a configure dependency. The setup step this
    project documents -- `git submodule update --init --recursive` (CLAUDE.md)
    -- resets lib/ioLibrary_Driver's working tree and DISCARDS both patches, and
    a following `make -C build` does not re-run configure because CMakeLists.txt
    is unchanged. The firmware then compiles against unpatched sources with no
    warning printed at all.
    Second, even when configure did run, a failed apply was only
    message(WARNING), which scrolls pa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
2026-08-17 mbq_client: bound resolve_version's digit scan to the version field
    The FC04 0x0200 version block is a free-form 32-byte STRING from off-device,
    but resolve_version() parsed it with a raw pointer walk that had no end:
    while (*p >= '0' && *p <= '9') maj = maj * 10u + (unsigned)(*p++ - '0');
    The 'v' can match as late as v[30], so the major-digit scan can start on the
    field's final byte and then run on through the frame's CRC bytes and off the
    end of cb_buf[40] into the rest of slave_t. Same class as the jfind overread
    fixed in a8d30f4, in a file whose own standard is to never trust "shouldn't
    happen" -- and this one parses a reply from another device.
    Not reachable from the shipped gate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
2026-08-17 http: an over-long hostname was truncated into a valid one, not rejected
    Found on the bench: POSTing a 32-char hostname to /api/net answered
    {"ok":true} and stored 31 'a's — a name the caller never asked for, and one
    the CLI rejects outright with bad_hostname for the same input.
    jstr_key() silently truncates to its cap (http_server.c: `if (len >= cap)
    len = cap - 1`). Reading straight into cmd.set_netcfg.hostname, a 32-byte
    field, therefore clamped any over-long value to 31 chars BEFORE
    config_hostname_set() ever saw it — at which point it was a perfectly valid
    label and was accepted. The validation added in 62d4756 was correct but
    looked at an already-truncated string, so it could not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
2026-08-17 config: one fits-or-fails rule for every externally-supplied string
    Follow-up to e875365, which fixed the /api/net hostname truncation in
    isolation. The same silent-substitution bug existed at every other config
    string, in three separate layers, none of which could tell a caller it had
    happened:
    - http_server.c's jstr_key() clamps to its cap on extraction.
    - config.c's get_str() clamps the same way on load.
    - the CLI's strncpy(dst, v, sizeof dst - 1) truncates — and four sites
    (mqtt host/user/pass/prefix) never wrote the terminating NUL at all,
    safe only because those fields' last byte happens never to be written
    non-zero. The intercore handler 460 lines below terminated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
2026-08-18 build: single source list shared by light_switch and light_switch_ota
    The application source list was maintained twice — once for light_switch,
    once (inside OTA_APP_LAYOUT) for light_switch_ota — as two byte-identical
    26-line lists plus twin ioLibrary/net target_sources blocks. A .c file added
    to one target and forgotten in the other compiles fine and fails at link, or
    worse, silently diverges the OTA build; strfit.h was deliberately made
    header-only partly to dodge exactly this.
    Factor the lists into APP_CORE_SRCS / MONOCYPHER_SRCS / IOLIB_VENDORED_SRCS /
    APP_NET_SRCS, defined once and consumed by both add_executable()/
    target_sources() sites. The duplicated set_source_files_properties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
2026-08-18 test: one command to build and run all 13 host tests
    Every host test documented its exact `cc ... && /tmp/<name>` line in its
    header comment, but nothing ran them as a suite — "run the tests" meant
    hand-copying 13 compiler invocations, so in practice each change ran only
    the tests its author remembered.
    test/run_host_tests.sh builds and runs all of them: PASS/FAIL per test,
    summary count, nonzero exit on any failure, artifacts in a mktemp dir
    cleaned on exit. The per-test recipes live in an explicit table mirroring
    each test's own documented build line (transcribed, not parsed at runtime —
    a table is greppable and reviewable; comment-scraping is fragile). All 13
    currently compile warnin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
2026-08-18 json: one jsmn helper layer instead of three, and it fixes a latent OOB read
    config.c, http_server.c and ha_bridge.c each grew their own near-identical
    jsmn token helpers (tok_eq/find_key/get_str; jeq/jfind/jstr_key; jtok_eq/
    jfind/jint). That triplication already cost real bugs: the clamp-not-reject
    string flaw was fixed in http_server.c's jstr_key (e875365) and then needed
    a SECOND, separate fix for config.c's identical get_str (23761ba), because
    the two were never the same function. src/jsmn_util.h (header-only static
    inline, the strfit.h pattern) is that layer written once:
    jtok_eq/jfind/jhas/jint/jint_key/jbool_key — the shared walk
    jstr_set — strict fits-or-fails string ex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
2026-08-18 refactor: split serial_protocol.c into cli.c + ic_seam.c
    serial_protocol.c was 2,706 lines holding three responsibilities under a
    name that stopped being true in June 2026, when the machine-readable serial
    protocol died with the move to the on-board bridge (its dead JSON surface
    was deleted in 2590c9f): the human USB-CDC CLI, ic_dispatch_cmd() — the
    single writer of g_config for ALL core-1 traffic, i.e. every web and Home
    Assistant write — and the core0<->core1 event seam. The practical cost was
    real: last week's both-or-neither credential fix was a change to the
    system's config-write seam, buried at line ~2500 of a console file.
    Now:
    src/cli.c — 39 verb handlers, cli_command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
2026-08-18 config: schema table — one definition per field, ranges finally enforced
    One config field's definition was scattered across ~9 files, and the layers
    had measurably drifted: ha_bridge's CFG_NUM[] declared ranges (long_press_ms
    100..5000, ...) purely as UI hints to Home Assistant — the firmware never
    enforced them anywhere. A raw MQTT publish of long_press_ms=70000 was cast
    (uint16_t) and silently stored as 4464; the CLI's cfg verb ran bare atoi
    with no bound at all. The string fields got one shared rule in 23761ba
    (strfit/jstr_get, fail-closed credentials); the numerics still had zero
    rules in four places.
    CFG_SCHEMA[] (config.c, 15 rows) now defines each field once — key, kind
    (U16/U3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
2026-08-18 json: RFC 8259 escape/unescape at every config string boundary
    config_save() wrote every string field as a raw %s between JSON quotes. A
    password set via the CLI as ab"cd saved as "mqtt_pass":"ab"cd" — the
    embedded quote ended the JSON string early, the whole document stopped
    parsing, and on the NEXT BOOT config_load() fell back to compiled defaults
    for every field: mqtt/network gone AND web_user/web_pass back to
    admin/admin. One legitimate write, a config wipe plus an auth downgrade,
    detonating one reboot later.
    jsmn cannot help with this by design — it is a tokenizer that VALIDATES
    escape sequences on parse but never decodes them, and has no write side at
    all. That asymmetry also prod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
2026-08-18 auth: web password stored as Argon2id hash, never plaintext
    /config.json is readable over the CLI (cat), lands in UPDI/flash dumps and
    backups, and until now carried web_pass verbatim. The device is the
    VERIFIER of that credential, so only a hash needs storing. (mqtt_pass is
    deliberately untouched: the device authenticates TO the broker and needs
    the plaintext; the JSON-escaping layer is what protects it at rest.)
    src/web_auth.{h,c}: Argon2id via the vendored Monocypher 4.x — nb_blocks=32
    (32 KB static work area; map file measured ~155 KB headroom before, ~123 KB
    after), nb_passes=3, nb_lanes=1 (Monocypher runs lanes serially; more lanes
    would only dilute the same 32 KB). Storage: web_pas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
2026-08-18 docs: correct gateway-recovery registers and bootloader commit.c factoring
    Two doc-rot classes surfaced by the review sweep, both MISLEADS-OPERATOR.
    README.md's manual baud/slave-address recovery table pointed at wrong (and
    in two cases RETIRED) Modbus registers — an operator recovering a stranded
    gateway by hand, during the very production conversion we're preparing,
    would have written to illegal addresses and read the device as dead:
    - DALI set-baud register 0x1013 -> 0x1F03 (0x1013 is in the removed FC23
    range that now answers ILLEGAL DATA ADDRESS); value for 38400 0x0001 ->
    0x0002 (0x0001 selects 19200).
    - Relay set-baud value for 38400 0x0002 -> 0x0003 (register 0x2000 wa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
2026-08-18 config/mapping: skip the save when nothing actually changed
    config_save() and mapping_save() rewrote flash unconditionally — even when
    the applied value equalled what was already stored. Neither config_apply_*()
    nor mapping_set() has a dirty check, so an ordinary HA "sync desired state"
    automation that republishes the same value on a timer (a normal,
    non-malicious pattern — the MQTT topics config/set, config/<key>/set,
    mapping/<f>/<b>/set and binding/<f>/<b>/set all reach a save with no rate
    limit) drove a full two-file littlefs write every tick. The flash-wear
    review's arithmetic put the worst realistic case at the 256 KB region's
    erase budget in ~2 months.
    Both save functions now comp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
2026-08-18 tools: release-check.sh — one pre-release gate for the OTA footguns
    The release flow has several failure modes that are each easy to get right
    alone and easy to forget under pressure: a dirty tree baking "-dirty" into
    FW_VERSION, a manifest version that doesn't equal the image's FW_VERSION
    (CLAUDE.md's "#1 footgun" — HA never converges on "up to date"), a warning
    slipping into src/ or bootloader/, or shipping boot-code changes against a
    stale/unbuilt bootloader. Nothing ran them as one gate.
    tools/release-check.sh runs them fail-fast with a PASS/FAIL per stage:
    git cleanliness → host tests (16) → standalone build (warnings in our
    sources are failures) → OTA build+sign+manifest wit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
2026-08-18 ota: anti-rollback build counter — refuse a signed but OLDER image
    CRITICAL fix (OTA trust-model review, verified against code). The update
    decision was strcmp(latest, installed) != 0 — a bare inequality, no recency
    ordering at ANY layer, and fw_verify() checks only signature/hash. So an
    attacker controlling the manifest (plain HTTP, no TLS) could point `url` at
    any previously-published, validly-signed OLDER image, label it anything, and
    one authenticated Install click (human or HA automation) would stage it,
    pass verification (it really is signed), and commit it — silently
    reinstating every since-fixed bug. No private key needed; signed artifacts
    never expire. This closes the downgrad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
2026-09-30 docs: gateway frame_error ignores other devices' clean traffic
    Mirrors TinyModbus fix/rx-diag-attribution.
2026-09-30 release: build counter 2 — first OTA-layout image for the house controller
2026-09-30 buttons: a group with several lights on can be switched off again
    House, 2026-09-30: group 3.6 (four members, all on) could not be turned
    off from its wall buttons (F7.B5, F15.B1). Every press logged "any-on probe
    unresolved (dropped, 41 ms) — assuming DALI off", so a tap turned the group
    ON and a hold dimmed UP.
    The probe sends QUERY LAMP POWER ON to the group. Every lit member answers
    at once; the backward frames overlap and the gateway reported the overlap
    as DALI_RESP_BUSFAULT (a pulse of in-between width) rather than COLLISION.
    dq_yes_no() maps BUSFAULT to UNRESOLVED, and the button then guessed "off".
    It never showed on the bench because no bench group ever had two lit
    members answe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
2026-09-30 dstate: a collided address is present, not unavailable
    House, 2026-09-30: 3.1 and 3.3 each hold two ballasts (a known collision).
    They switch on and off with every command to their address, but HA showed
    them unavailable: a scan's QUERY STATUS to the address came back garbled,
    the gateway labelled the overlap BUSFAULT, and presence_from() froze the
    belief at "absent" -- so a collided address could never become present.
    A garbled answer to a query sent to ONE short address means something
    answered. It now counts as present (WARN logs the collision) -- but only if
    this bus gave a clean answer or silence within BUS_ALIVE_MS (5 s), because
    an unpowered bus reads BUSFAULT on every address and mu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
2026-09-30 commissioning: re-provisioning a collided address actually splits it
    `provision <slave> <addr>` could not work on a real collision:
    1. COMPARE over two or more gear always answers garbled -- that is the
    mechanism -- and the gateway may label it BUSFAULT, which dq_yes_no()
    reads as UNRESOLVED, so the run aborted on the first COMPARE. A garbled
    answer (DQ_RES_ERR) now reads YES. Dropped/lost still aborts. Safe
    because PROGRAM only touches gear whose random address equals the search
    value; a wrong YES leads nowhere and the strict VERIFY re-bisects.
    2. lowest_unused_addr() trusted the presence cache, which cannot see
    collided or unread gear and was not updated during the run -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
2026-09-30 commissioning: the first gear on a collided address keeps it
    Splitting a collided address moved EVERY gear off it and then moved the
    last one back with SET SHORT ADDRESS -- two address writes for a gear that
    started on the right address (3.1 -> 19 -> 1 on the house bus). The detour
    existed only because VERIFY SHORT ADDRESS is answered by every initialised
    gear on the address, so the first gear couldn't be verified in place while
    its twins were still there.
    Verify later instead: the first gear the bisect selects keeps the target
    (nothing programmed, just WITHDRAWn from the search); every other gear is
    moved to a checked-free address and verified there; at the end the target
    must answer QUERY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
2026-09-30 dstate: a MASK (255) level read is "still starting", not brightness 255
    IEC 62386-102: QUERY ACTUAL LEVEL answers MASK (0xFF) while the lamp is
    still starting up. Slow-start drivers (house 3.1, 3.9, 3.19) answer it to
    the verify read ~100 ms after an "on", and it was published as brightness
    255 -- which HA showed until the idle sweep re-read the ballast minutes
    later (3.19: 255 -> 228, its real last-active level).
    MASK now gets the same treatment as a running fade: keep the cached level,
    publish nothing from that read, and re-read at FADE_POLL_MS (250 ms) via
    the fade watch until a real level comes back (bounded by the existing
    FADE_TRACK_MAX_MS give-up). A full scan that reads MASK commits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
2026-09-30 buttons work the moment a gateway comes back, not a minute later
    House, 2026-09-30: after the DALI side was powered down to refit the panel
    cover, the wall switches did nothing for up to a minute once the gateways
    were back. modbus.c's absent-slave backoff doubles to a 60 s cap and fails
    every request without touching the wire in between -- button presses
    included -- so a returning gateway was only noticed at the next probe
    window. mbq_client's own failure pacing (up to 1 s) sat on top of it.
    A user command now kicks both: modbus_backoff_kick() makes the next request
    to that slave the probe and restarts the ladder at 1 s; mbq_client_kick()
    clears the transport's pacing. dq_submit() kicks fo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
2026-09-30 cfg-query: back off an unavailable gateway instead of spinning on it
    House, 2026-09-30: during a one-minute DALI power-down the log ring filled
    with "slave 3 class 4 full — cmd 17A1 refused" -- 272k refusals in ~7 min
    (~4000/s; the WARN is already rate-limited to every 256th and still ran at
    16 lines/s), which wiped the very history needed to see what the buttons
    did. The class was only "full" because the gateway had stopped answering and
    nothing could drain.
    The config-query reader never looked at the link: it kept starting ballasts
    on a down gateway, and a refused submit was retried every tick (only
    submitted fields have a deadline, so nothing ever timed it out).
    Now, like dali_state's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
2026-10-04 dirty_poll: poll a healthy relay board every 10 s, not 2 s
    The relay poll is a health check plus an out-of-band reconcile of the coil
    cache, and the controller is the relays' only writer, so 2 s buys nothing
    while the board answers. It also costs every DALI gateway a false CRC error
    per poll: the Waveshare board replies faster than their end-of-frame window
    and request+reply arrive glued (gateway fix 225e778, pending a panel visit).
    Healthy: 10 s. Not answering: still 2 s, so a returning board is found
    quickly; a relay press kicks the Modbus backoff on its own (35f7af7).
2026-10-04 remove the RS-485 "always" DE mode
    `rs485 always` held the transceiver's driver enable on permanently -- it
    only suited a long-gone non-standard driver, and on the real transceiver it
    jams the bus (the controller talks over every slave). DE is now asserted
    only while transmitting, unconditionally.
    Removed: modbus_de_mode_t and its set/get/to_str, the `rs485` CLI command
    and `rs485=` in `show config`, g_config.de_mode and its save/load, the
    /modbus_config.txt migration (the file is just deleted if present),
    IC_CFG_F_DE_MODE and the de_mode intercore fields, de_mode in /api/cfg and
    the web state JSON, and the DE dropdown in the web UI. A "de_mode" key in
    an existing /config.json is ignored an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
2026-10-04 the CLI over the network: POST /api/cli and <prefix>/cli/cmd
    One command interface. The 39-verb USB CLI was the only way to read raw
    registers, gateway counters, `mbq`, `dstate` etc., so anything off-site or
    without a USB cable plugged in was blind (2026-10-04: verifying the new
    gateway firmware's crc_error needed USB).
    remote_cli.c is a single-slot mailbox between core 1 (HTTP, MQTT) and core 0
    (where the CLI must run): core 1 posts one command line, core 0's main loop
    runs it through cli_exec_line() -- the same handle_line() USB uses -- with
    stdout captured by a temporary pico stdio driver, and core 1 reads the
    output back. A hardware spinlock guards the slot; a requester that gives up
    (c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
2026-10-04 remote CLI: also capture output printed through cdc_out_printf
    Commands like `mbq gw` and the soak report print their results with
    cdc_out_printf(), which writes straight into the console ring and bypasses
    stdio, so the network CLI returned an empty reply for them (house,
    2026-10-04: `mbq gw 2` over MQTT came back empty while the counters landed
    in /api/log). cdc_out gains a core-0 tap that remote_cli installs alongside
    its stdio capture driver; LOG_* lines ("# ...") are excluded -- they are in
    /api/log already.
2026-10-10 coalesce HA commands into latest-wins desired state (task 14)
    A burst of HA commands lost lights. Measured on the house with a 107-command
    no-op burst (Siri-style, 11 ms): 57 of 75 DALI commands dropped at the
    8-deep user class, 7 of 32 relays at the Modbus action queue, 0 at the
    intercore queue — and a wall press right behind the burst was refused
    ("backlog full") or took 276 ms.
    On/off/level from HA, web, HTTP API and CLI now overwrite a per-target
    slot (64 ballasts + 16 groups per gateway, dali_pending.c) instead of
    queueing a frame. The scheduler drains it oldest-written first as a ladder
    rung below buttons and dim steps, at depth 2 so it never takes the staging
    slot: buttons always w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
2026-10-10 relays: drain desired state with paced FC05, not FC15
    Live on the house (2.0.1+0a895fa), the Waveshare 32CH did not answer an
    FC15 over one 8-coil bank at all: silent timeouts, then slave backoff.
    The burst was a re-assert of current state, so no relay changed. Drain the
    relay table one FC05 in flight at a time instead: still latest-wins and
    still cannot overflow the action queue, ~8 ms per channel. FC15 support is
    removed from modbus.c rather than left unused. Also records build counter
    12 as used to sign 2.0.1+0a895fa.
2026-10-10 README: measured burst + button latency on the coalesced command path
2026-10-10 group membership edits and blocking CLI waits no longer stall HA bursts
    dali_group_set_members submitted each ADD/REMOVE TO GROUP frame into the
    8-deep user class and spun the bus (up to 2 s per frame) until there was
    room: replacing a big group stalled core 0 for about a second, with no HA
    commands absorbed and wall buttons waiting. Membership edits now go into the
    gateway's desired-state table as per-group add/remove lists (latest wins per
    ballast/group pair) and drain in the same write order as level commands, so
    "set members, then group on" changes the members first. Edits diff against
    the last requested membership as well as the lagging cache; each frame's
    ballast is re-interrogated as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
2026-10-23 hardware: bring in the all-in-one hub board
    The carrier board this firmware runs on (Pico-footprint W5100S-EVB-Pico,
    RS-485, two mikroBUS sockets for the TinyModbus adapters, 24 RJ45 switch
    ports) lived only in a retired checkout (SwitchesModbusAndDali/pcb), with
    its latest revision uncommitted. Moved here so the firmware and its
    hardware live in one repo: KiCad schematic/PCB/project, the case STEP/STL
    and FreeCAD mount, and the JLCPCB production outputs (previously
    gitignored, so never on any remote). KiCad auto-backups and fp-info-cache
    stay ignored.
